Ferivas/RADIOBRIDGE/DOCS/MODBUS/MDBGPS_PROG1.jpg

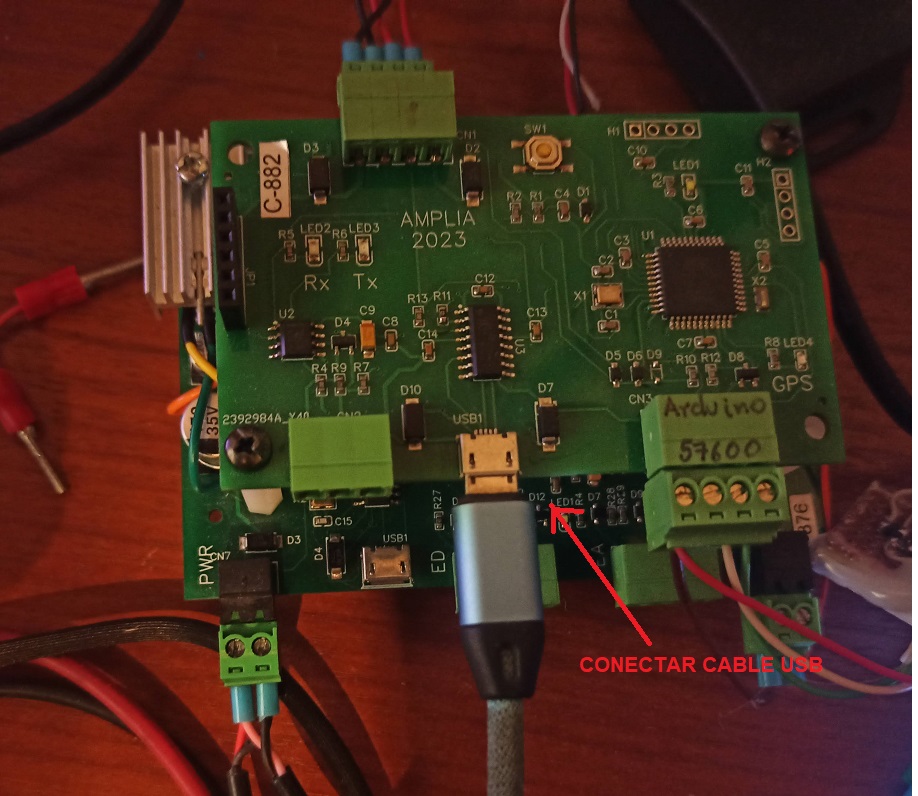
DOCS/MODBUS/MDBGPS_PROG1.jpg
