Ferivas/RADIOBRIDGE/DOCS/MODBUS/MDBGPS_PROG2.jpg

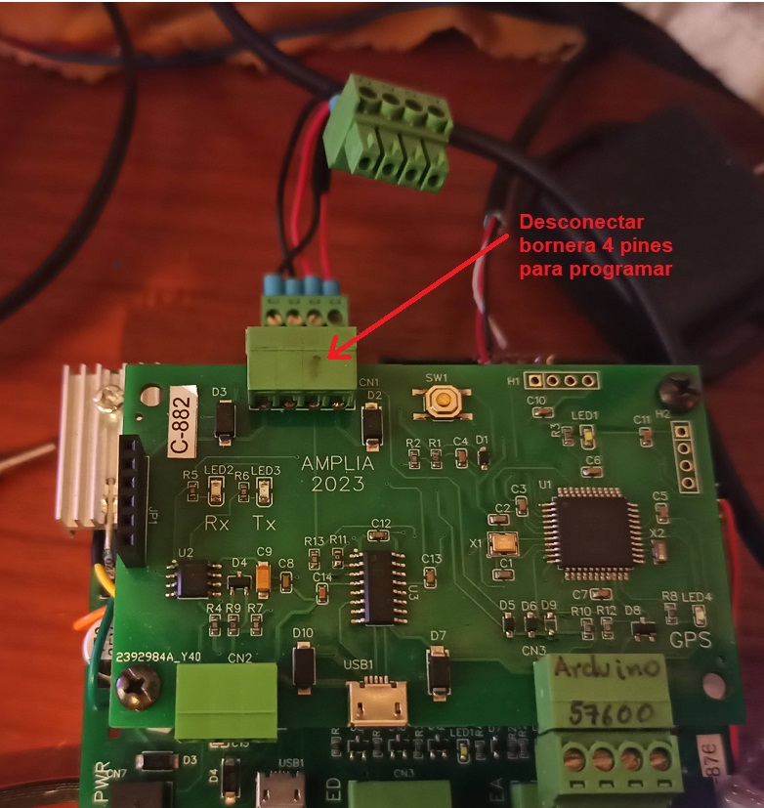
DOCS/MODBUS/MDBGPS_PROG2.jpg
