Ferivas/RADIOBRIDGE/DOCS/ON_OFF_RPI.jpg

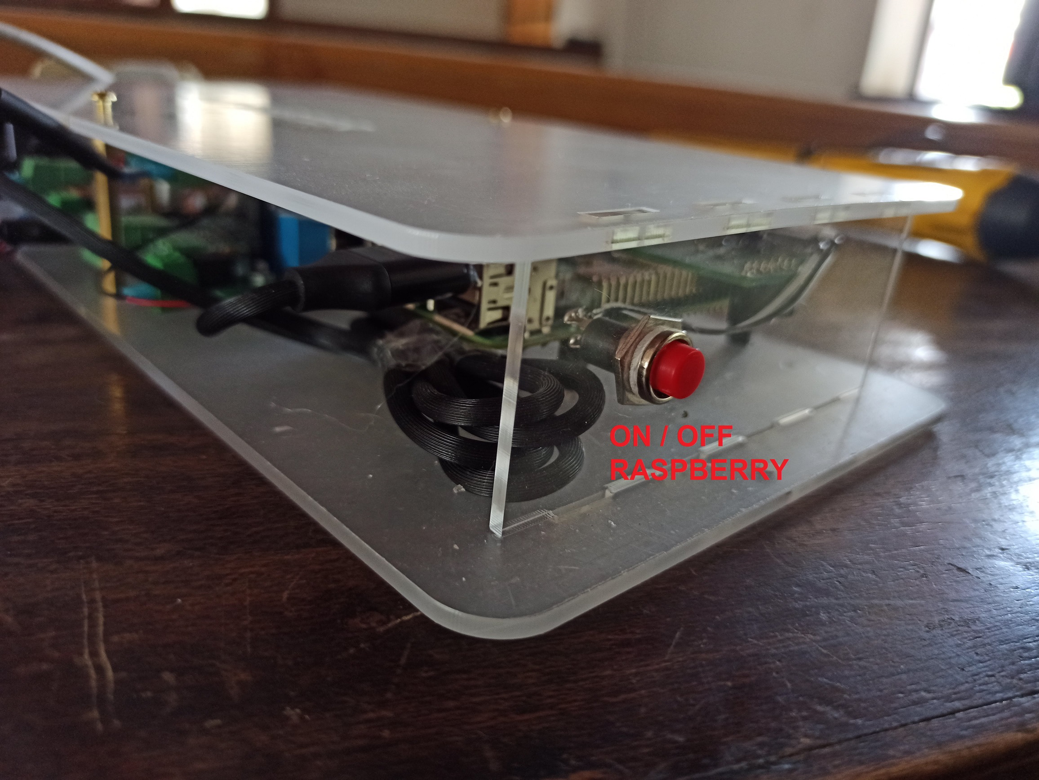
DOCS/ON_OFF_RPI.jpg
