Ferivas/RADIOBRIDGE/DOCS/PWR_RPI.jpg

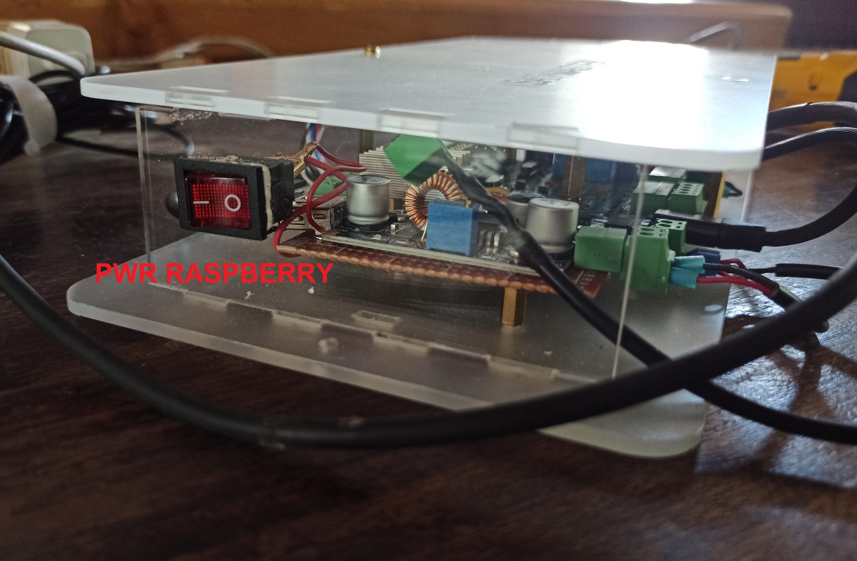
DOCS/PWR_RPI.jpg
