Ferivas/RADIOBRIDGE/DOCS/SAT_MASTER.jpg

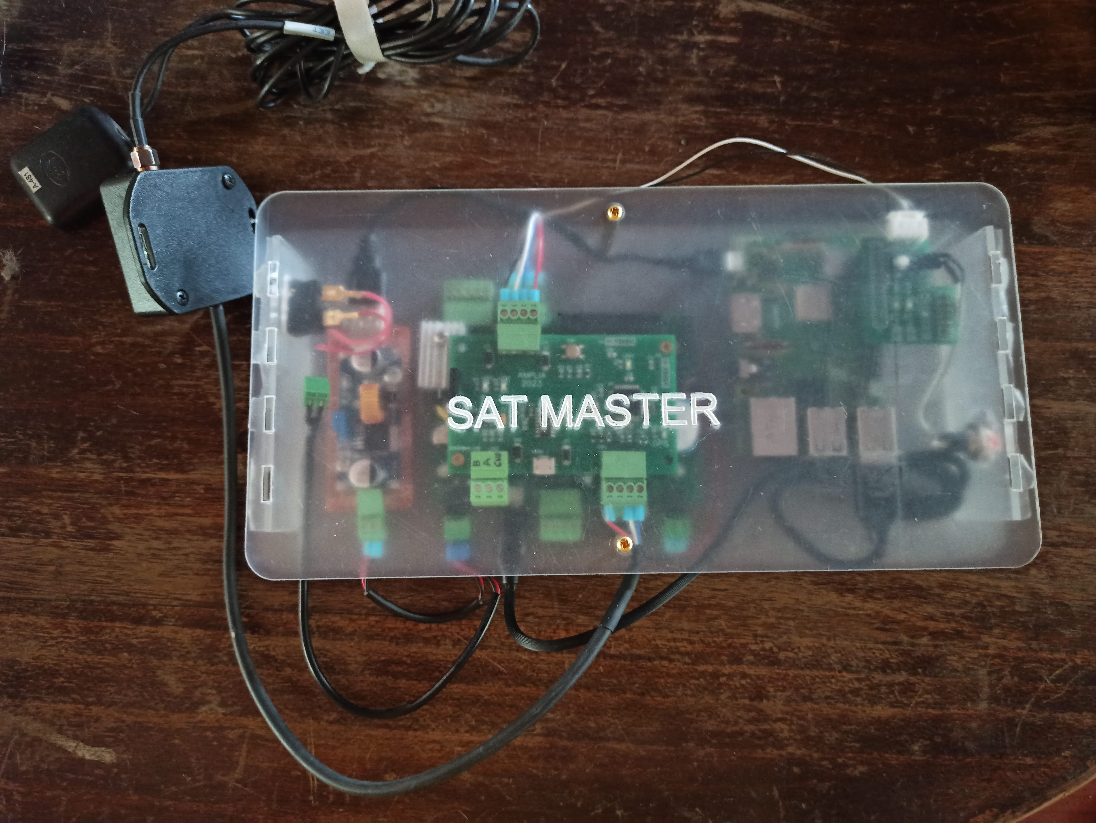
DOCS/SAT_MASTER.jpg
