Ferivas/RADIOBRIDGE/DOCS/SAT_MASTER_CONEXIONES.jpg

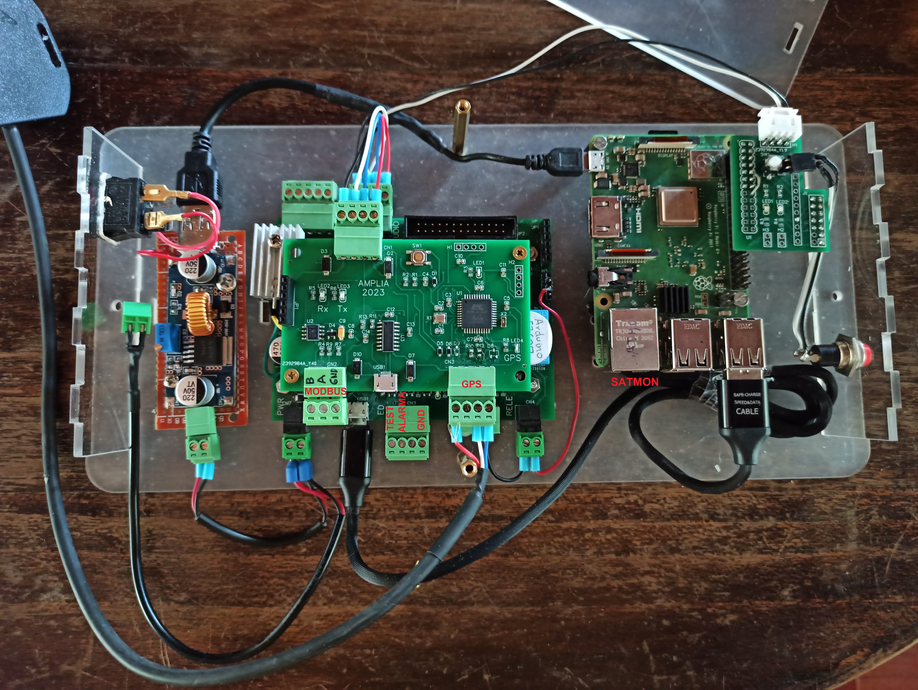
DOCS/SAT_MASTER_CONEXIONES.jpg
