Ferivas/RADIOBRIDGE/SCH/DRVLEDSAT/BOM_DRVLEDSAT_2024-02-23.csv

ID | Name | Designator | Footprint | Quantity | Manufacturer Part | Manufacturer | Supplier | Supplier Part | Price
1 | 22pF | C1,C2 | C0603 | 2 | CL10C220JB8NNNC | SAMSUNG | LCSC | C1653 | 0.006
2 | 100nF | C3,C4,C5,C6,C7,C8,C9,C12,C14,C15,C16 | C0603 | 11 | CC0603KRX7R9BB104 | YAGEO | LCSC | C14663 | 0.002
3 | 10uF | C10 | CAP-SMD_L3.2-W1.6-RD-C7171 | 1 | TAJA106K016RNJ | Kyocera AVX | LCSC | C7171 | 0.095
4 | 220uF | C11,C13 | CAP-SMD_BD6.3-L6.6-W6.6-FD | 2 | RVT220UF16V67RV0015 | KNSCHA(科尼盛) | LCSC | C2887273 | 0.031
5 | THD2528-11SD-GF | CARD1 | TF-SMD_THD2528-11SD-GF | 1 | THD2528-11SD-GF | THD | LCSC | C283232 | 0.208
6 | 1N4148WS T4 | D1,D4 | SOD-323_L1.8-W1.3-LS2.5-RD | 2 | 1N4148WS T4 | CJ | LCSC | C2128 | 0.01
7 | SS14 | D2 | SMA_L4.2-W2.6-LS5.3-RD | 1 | SS14 | MDD | LCSC | C2480 | 0.014
8 | SMAJ5.0A_C2925443 | D3 | SMA_L4.3-W2.6-LS5.0-RD | 1 | SMAJ5.0A | Liown(里阳半导体) | LCSC | C2925443 | 0.029
9 | 220S-1*4P H=8.5MM | H2 | HDR-TH_4P-P2.54-V-F | 1 | 220S-1*4P H=8.5MM Ytype Gold-plated | Ckmtw | LCSC | C124413 | 0.111
10 | whiteLEDSMD | LED1 | LED0805-R-RD | 1 | KT-0805W | KENTO | LCSC | C34499 | 0.017
11 | HDR-IDC-2.54-2X8P | P1,P2 | IDC-TH_16P-P2.54_C3406 | 2 | IDC Box 2.54mm 16P Straight | BOOMELE | LCSC | C3406 | 0.092
12 | SI2301CDS-T1-GE3 | Q1 | SOT-23-3_L3.0-W1.7-P0.95-LS2.9-BR | 1 | SI2301CDS-T1-GE3 | VISHAY | LCSC | C10487 | 0.072
13 | 2n3904S-RTK/PS_C18536 | Q2 | SOT-23-3_L2.9-W1.3-P1.90-LS2.4-TR | 1 | 2N3904S-RTK/PS | KEC | LCSC | C18536 | 0.012
14 | 47K | R1,R3 | R0603 | 2 | 0603WAF4702T5E | UniOhm | LCSC | C25819 | 0.001
15 | 1K | R2 | R0603 | 1 | 0603WAF1001T5E | UniOhm | LCSC | C21190 | 0.001
16 | 10kΩ | R4,R6,R7,R14,R15 | R0603 | 5 | 0603WAF1002T5E | UNI-ROYAL(厚声) | LCSC | C25804 | 0.001
17 | 100kΩ | R5 | R0603 | 1 | 0603WAF1003T5E | UNI-ROYAL(厚声) | LCSC | C25803 | 0.001
18 | 100Ω | R8,R9,R10,R11,R13,R16,R17 | R0603 | 7 | 0603WAF1000T5E | UNI-ROYAL(厚声) | LCSC | C22775 | 0.001
19 | 3.3kΩ | R12 | R0603_NEW | 1 | 0603WAF3301T5E | UniOhm | LCSC | C22978 | 0.001
20 | TS-1187A-B-A-B | SW1 | SW-SMD_4P-L5.1-W5.1-P3.70-LS6.5-TL-2 | 1 | TS-1187A-B-A-B | XKB Connectivity(中国星坤) | LCSC | C318884 | 0.016
21 | ATMEGA1284P-AU | U1 | TQFP-44_L10.0-W10.0-P0.80-LS12.0-BL | 1 | ATMEGA1284P-AU | MICROCHIP(美国微芯) | LCSC | C33575 | 7.038
22 | 24LC256T-I/SN SOP-8 | U2 | SOIC-8_L4.9-W3.9-P1.27-LS6.0-BL | 1 | 24LC256T-I/SN | MICROCHIP(美国微芯) | LCSC | C5458 | 0.804
23 | AMS1117-3.3 | U3 | SOT-223-3_L6.5-W3.4-P2.30-LS7.0-BR | 1 | AMS1117-3.3 | AMS | LCSC | C6186 | 0.141
24 | 32.768kHz | X2 | FC-135R_L3.2-W1.5 | 1 | Q13FC1350000400 | EPSON | LCSC | C32346 | 0.202
25 | 18.432MHz | X1 | CRYSTAL-SMD_4P-L5.0-W3.2-BL-7I12288F20UCG | 1 | TXM18.432M0004503KDCDO00T | YJX(雅晶鑫) | LCSC | C362488 | 0.228
