Ferivas/RADIOBRIDGE/SCH/SATMASTER/BOM_PCB_MDBGPS_2023-09-29.csv

ID | Name | Designator | Footprint | Quantity | Manufacturer Part | Manufacturer | Supplier | Supplier Part | Price
1 | CH340C | U3 | SOP-16_L10.0-W3.9-P1.27-LS6.0-BL | 1 | CH340C | WCH(南京沁恒) | LCSC | C84681 | 0.476
2 | 100nF | C7,C10,C3,C11,C4,C5,C6,C8,C12,C13 | C0603 | 10 | CC0603KRX7R9BB104 | YAGEO | LCSC | C14663 | 0.002
3 | 1N4148WS T4 | D1,D9,D5,D6 | SOD-323_L1.8-W1.3-LS2.5-RD | 4 | 1N4148WS T4 | CJ | LCSC | C2128 | 0.011
4 | SS14 | D2 | SMA_L4.2-W2.6-LS5.3-RD | 1 | SS14 | MDD | LCSC | C2480 | 0.014
5 | PSM712-LF-T7 | D4 | SOT-23-3_L3.0-W1.7-P0.95-LS2.9-BR | 1 | PSM712-LF-T7 | PROTEK | LCSC | C32677 | 0.326
6 | BAV70-C68978 | D8 | SOT-23-3_L3.0-W1.7-P0.95-LS2.9-BR | 1 | BAV70 | CJ | LCSC | C68978 | 0.018
7 | 2685Y-106CNG1SNA01 | JP1 | HDR-TH_6P-P2.54-V-F | 1 | 2685Y-106CNG1SNA01 | 华宇创 | LCSC | C350307 | 0.099
8 | 0805G (Green) | LED2 | LED0805-R-RD | 1 | KT-0805翠绿 | KENTO | LCSC | C2297
9 | 17-21SUYC/TR8 | LED3 | LED0805-R-RD | 1 | KT-0805黄灯 | KENTO | LCSC | C2296
10 | 47K | R1 | R0603 | 1 | 0603WAF4702T5E | UniOhm | LCSC | C25819 | 0.001
11 | 1K | R2,R7,R4,R5,R6,R10,R11,R12,R13 | R0603 | 9 | 0603WAF1001T5E | UniOhm | LCSC | C21190 | 0.001
12 | 470Ω | R3,R8 | R0603 | 2 | 0603WAF4700T5E | UNI-ROYAL(厚声) | LCSC | C23179 | 0.001
13 | TS-1187A-B-A-B | SW1 | SW-SMD_4P-L5.1-W5.1-P3.70-LS6.5-TL-2 | 1 | TS-1187A-B-A-B | XKB Connectivity(中国星坤) | LCSC | C318884 | 0.016
14 | ATMEGA1284P-AU | U1 | TQFP-44_L10.0-W10.0-P0.80-LS12.0-BL | 1 | ATMEGA1284P-AU | MICROCHIP(美国微芯) | LCSC | C33575 | 6.811
15 | SN75176BDR | U2 | SOIC-8_L5.0-W4.0-P1.27-LS6.0-BL | 1 | SN75176BDR | TI(德州仪器) | LCSC | C7063 | 0.283
16 | micro 5PBoard5.9No column plus welding feet | USB1 | MICRO-USB-SMD_5P-P0.65-H-F-C40955 | 1 | micro 5PBoard5.9No column plus welding feet | ValuePro | LCSC | C40955 | 0.066
17 | 16MHz | X1 | OSC-SMD_4P-L3.2-W2.5-BL | 1 | X322516MLB4SI | YXC | LCSC | C13738 | 0.064
18 | 32.768kHz | X2 | FC-135R_L3.2-W1.5 | 1 | Q13FC1350000400 | EPSON | LCSC | C32346 | 0.204
19 | 22pF | C1,C2 | C0603 | 2 | CL10C220JB8NNNC | SAMSUNG | LCSC | C1653 | 0.007
20 | SMAJ5.0A_C2925443 | D10,D3 | SMA_L4.3-W2.6-LS5.0-RD | 2 | SMAJ5.0A | Liown(里阳半导体) | LCSC | C2925443 | 0.039
21 | 0603White light_C2290 | LED1 | LED0603-R-RD_WHITE | 1 | KT-0603白灯 | KENTO | LCSC | C2290
22 | KT-0603R | LED4 | LED0603-RD | 1 | KT-0603R | KENTO | LCSC | C2286
23 | 120Ω | R9 | R0603 | 1 | 0603WAF1200T5E | UNI-ROYAL(厚声) | LCSC | C22787 | 0.001
24 | 10uF | C9 | CAP-SMD_L3.2-W1.6-RD-C7171 | 1 | TAJA106K016RNJ | Kyocera AVX | LCSC | C7171 | 0.1
25 | 10nF | C14 | C0603 | 1 | 0603B103K500NT | FH(风华) | LCSC | C57112 | 0.003
26 | SS14 | D7 | SMA_L4.4-W2.8-LS5.4-RD | 1 | SS14 | MDD | LCSC | C2480 | 0.014
