Ferivas/RADIOBRIDGE/SCH/BOM_RADIOBRIDGE_2022-01-24.csv

ID | Name | Designator | Footprint | Quantity | Manufacturer Part | Manufacturer | Supplier | Supplier Part | Price | JLCPCB Part Class
1 | 100nF | C1,C4,C5,C6,C8,C9,C11,C12,C13,C16,C18,C19,C21,C22,C23,C26,C31,C32 | C0603 | 18 | CC0603KRX7R9BB104 | YAGEO | LCSC | C14663 | 0.003 | Basic Part
2 | 22pF | C2,C3,C14,C15,C33,C34,C35,C36 | C0603 | 8 | CL10C220JB8NNNC | SAMSUNG | LCSC | C1653 | 0.005 | Basic Part
3 | 470uF | C7 | CAP-SMD_BD10.0-L10.3-W10.3-FD | 1 | RVE1V471M1010 | ROQANG | LCSC | C131125 | 0.15 | Extended Part
4 | 220uF | C10 | CAP-SMD_BD6.3-L6.6-W6.6-LS7.2-R-RD | 1 | RVT1A221M0605 | HONOR | LCSC | C3345 | 0.037 | Extended Part
5 | 100uF | C17,C29 | CAP-SMD_BD6.3-L6.6-W6.6-LS7.6-FD-1 | 2 | RVE100UF35V67RV0072 | KNSCHA(科尼盛) | LCSC | C2836437 | 0.057 | Extended Part
6 | 220pF | C20 | C0603 | 1 | CL10B221KB8NNNC | SAMSUNG | LCSC | C1603 | 0.005 | Basic Part
7 | 10uF | C24,C25,C27,C28,C30 | CAP-SMD_L3.2-W1.6-R-RD | 5 | TAJA106K016RNJ | AVX | LCSC | C7171 | 0.113 | Basic Part
8 | JL15EDGRC-35004GT1 | CN2,CN3,CN6 | CONN-TH_4P-P3.50_JL15EDGRC-35004GT1 | 3 | JL15EDGRC-35004GT1 | JILN | LCSC | C400561 | 0.062 | Extended Part
9 | 31342102 | CN4,CN7 | CONN-TH_2P-P3.50_31342102 | 2 | 31342102 | METZ CONNECT | LCSC | C123232 | 0.633 | Extended Part
10 | JL15EDGVC-35006G01 | CN5 | CONN-TH_6P-P3.50_JL15EDGVC-35006G01 | 1 | JL15EDGVC-35006G01 | JILN | LCSC | C400552 | 0.091 | Extended Part
11 | 1N4148WS T4 | D1,D5,D7,D9,D11 | SOD-323_L1.8-W1.3-LS2.5-RD | 5 | 1N4148WS T4 | CJ | LCSC | C2128 | 0.017 | Basic Part
12 | M7_C95872 | D2 | DO-214AC_L4.3-W2.7-LS5.3-RD | 1 | M7 | MDD | LCSC | C95872 | 0.009 | Basic Part
13 | SS34_C8678 | D3 | DO-214AC_L4.3-W2.7-LS5.3-RD | 1 | SS34 | MDD | LCSC | C8678 | 0.048 | Basic Part
14 | SS14 | D4 | SMA_L4.4-W2.8-LS5.4-RD | 1 | SS14 | MDD | LCSC | C2480 | 0.019 | Basic Part
15 | BAV99,215 | D8,D10,D12 | SOT-23-3_L2.9-W1.6-P1.90-LS2.8-BR | 3 | BAV99,215 | Nexperia | LCSC | C2500 | 0.026 | Basic Part
16 | 220S-1*4P H=8.5MM | H2 | HDR-TH_4P-P2.54-V-F | 1 | 220S-1*4P H=8.5MM Ytype Gold-plated | Ckmtw | LCSC | C124413 | 0.117 | Extended Part
17 | 2685Y-106CNG1SNA01 | JP1 | HDR-TH_6P-P2.54-V-F | 1 | 2685Y-106CNG1SNA01 | 华宇创 | LCSC | C350307 | 0.074 | Extended Part
18 | MTB110-26S | JP2 | IDC-TH_MTB110-26S | 1 | MTB110-26S | MINTRON | LCSC | C358747 | 0.177 | Extended Part
19 | 10uH | L1 | L0603 | 1 | SDFL1608S100KTF | Sunlord | LCSC | C1035 | 0.011 | Basic Part
20 | 0603White light_C2290 | LED1 | LED0603-R-RD_WHITE | 1 | 0603White light | KENTO | LCSC | C2290 |  | Basic Part
21 | 17-21SUYC/TR8 | LED2 | LED0805-RD | 1 | 17-21SUYC/TR8 | KENTO | LCSC | C2296 |  | Basic Part
22 | KT-0603R | LED3 | LED0603-R-RD | 1 | KT-0603R | KENTO | LCSC | C2286 |  | Basic Part
23 | SI2301CDS-T1-GE3 | Q1 | SOT-23-3_L3.0-W1.7-P0.95-LS2.9-BR | 1 | SI2301CDS-T1-GE3 | VISHAY | LCSC | C10487 | 0.083 | Basic Part
24 | MMBFJ177LT1G | Q2 | SOT-23-3_L3.0-W1.7-P0.95-LS2.9-BR | 1 | MMBFJ177LT1G | ON Semicon | LCSC | C106763 | 1.374 | Extended Part
25 | 2N5460 | Q3 | TO92-INLINE | 1
26 | 2n3904S-RTK | Q4,Q5 | SOT-23-3_L2.9-W1.3-P1.90-LS2.4-TR | 2 | 2n3904S-RTK/PS | KEC | LCSC | C18536 | 0.019 | Extended Part
27 | 47K | R1 | R0603 | 1 | 0603WAF4702T5E | UniOhm | LCSC | C25819 | 0.001 | Basic Part
28 | 1K | R2,R9,R10,R17,R21,R36 | R0603 | 6 | 0603WAF1001T5E | UniOhm | LCSC | C21190 | 0.001 | Basic Part
29 | 10K | R3,R11,R15,R24,R26 | R0603 | 5 | 0603WAF1002T5E | UniOhm | LCSC | C25804 | 0.001 | Basic Part
30 | 470 | R4,R5,R6,R27,R30,R35 | R0603 | 6 | 0603WAF4700T5E | UniOhm | LCSC | C23179 | 0.001 | Basic Part
31 | 0 | R7 | R0603 | 1 | 0603WAF0000T5E | UniOhm | LCSC | C21189 | 0.001 | Basic Part
32 | 51K | R8 | R0603 | 1 | 0603WAF5102T5E | UniOhm | LCSC | C23196 | 0.001 | Basic Part
33 | 100K | R12,R13,R18,R20,R29,R32,R34 | R0603 | 7 | 0603WAF1003T5E | UniOhm | LCSC | C25803 | 0.001 | Basic Part
34 | 300K | R14 | R0603 | 1 | 0603WAF3003T5E | UniOhm | LCSC | C23024 | 0.001 | Basic Part
35 | 220K | R16,R25 | R0603 | 2 | 0603WAF2203T5E | UniOhm | LCSC | C22961 | 0.001 | Basic Part
36 | 120K | R19 | R0603 | 1 | 0603WAF1203T5E | UniOhm | LCSC | C25808 | 0.001 | Basic Part
37 | 3.3K | R22 | R0603_NEW | 1 | 0603WAF3301T5E | UniOhm | LCSC | C22978 | 0.001 | Basic Part
38 | 56K | R23 | R0603 | 1 | 0603WAF5602T5E | UniOhm | LCSC | C23206 | 0.001 | Basic Part
39 | 1M | R28,R31,R33 | R0603 | 3 | 0603WAF1004T5E | UniOhm | LCSC | C22935 | 0.001 | Basic Part
40 | SRD-05VDC-SL-C | RLY1 | RELAY-TH_SRD-XXVDC-XL-C | 1 | SRD-05VDC-SL-C | SONGLE | LCSC | C35449 | 0.544 | Extended Part
41 | K2-1839SP-C4SW-02 | SW1 | SW-SMD_4P-L6.2-W6.2-P4.50-LS8.5 | 1 | K2-1839SP-C4SW-02 | Korean Hroparts Elec | LCSC | C164133 | 0.206 | Extended Part
42 | ATMEGA128A-AU | U1 | LQFP-64_L14.0-W14.0-P0.80-LS16.0-BL | 1 | ATMEGA128A-AU | MICROCHIP | LCSC | C6510 | 7.261 | Extended Part
43 | CJ7805 3% | U3 | TO-252-2_L6.6-W6.1-P4.58-LS10.1-BR-CW | 1 | CJ7805 3% | CJ | LCSC | C21706 | 0.34 | Extended Part
44 | CH340G | U4 | SOIC-16_150MIL | 1 | CH340G | WCH | LCSC | C14267 | 0.73
45 | 78L12G-AB3-R | U5 | SOT-89-3_L4.5-W2.5-P1.50-LS4.2-BR | 1 | 78L12G-AB3-R | UTC | LCSC | C75501 | 0.144 | Basic Part
46 | HT9170B | U6 | DIP18-2.54-22.8X7.62MM | 1 | HT9170B
47 | HT9200B | U8 | SOIC-14_L8.7-W3.9-P1.27-LS6.0-BL | 1 | HT9200B | HOLTEK | LCSC | C16087 | 1.097 | Extended Part
48 | micro 5PBoard5.9No column plus welding feet | USB1 | MICRO-USB-SMD_5P-P0.65-H-F-C40955 | 1 | micro 5PBoard5.9No column plus welding feet | ValuePro | LCSC | C40955 | 0.069
49 | 16MHz | X1 | OSC-SMD_4P-L3.2-W2.5-BL | 1 | X322516MLB4SI | YXC | LCSC | C13738 | 0.087 | Basic Part
50 | 12MHz | X2 | CRYSTAL-SMD_4P-L3.2-W2.5-BL | 1 | 7M1204LCSC-EIE4S | TXC | LCSC | C93114 |  | Extended Part
51 | 3.579545MHz | X3,X4 | HC-49S_L11.4-W4.8 | 2 | TXM3.579545M0002491HDDEO00T | Zhejiang Abel Elec | LCSC | C370890 | 0.12
52 | LM324 | U7 | SOIC-14_L8.7-W3.9-P1.27-LS6.0-BL | 1 | LM324 | PUOLOP | LCSC | C351427 | 0.156 | Extended Part
