Ferivas/RADIOBRIDGE/SCH/DRVAUDIO/BOM_DRVAUDIOSAT_2024-05-31.csv

ID | Name | Designator | Footprint | Quantity | Manufacturer Part | Manufacturer | Supplier | Supplier Part | Price
1 | 22pF | C1,C2 | C0603 | 2 | CL10C220JB8NNNC | SAMSUNG | LCSC | C1653 | 0.006
2 | 100nF | C3,C4,C6,C7,C8,C9,C12,C13,C15,C17,C20,C25,C35,C36,C37,C38 | C0603 | 16 | CC0603KRX7R9BB104 | YAGEO | LCSC | C14663 | 0.002
3 | 100uF | C5 | C1206 | 1 | CL31A107MQHNNNE | SAMSUNG(三星) | LCSC | C15008 | 0.065
4 | 1uF | C19,C22,C23,C24,C28,C29,C30,C32,C33,C34 | C1206 | 10 | CL31B105KBHNNNE | SAMSUNG(三星) | LCSC | C1848 | 0.017
5 | 10nF | C10 | C0603 | 1 | 0603B103K500NT | FH(风华) | LCSC | C57112 | 0.002
6 | 150pF | C27,C31 | C0603 | 2 | 0603B151K500NT | FH(风华) | LCSC | C1594 | 0.003
7 | 100uF | C11,C14,C16,C18 | CAP-SMD_BD8.0-L8.3-W8.3-FD | 4 | UWT1H101MNL1GS | Nichicon(尼吉康) | LCSC | C445063 | 0.168
8 | 10uF | C21,C26 | CAP-SMD_L3.2-W1.6-RD-C7171 | 2 | TAJA106K016RNJ | Kyocera AVX | LCSC | C7171 | 0.096
9 | 1N4148WS T4 | D1,D2,D4 | SOD-323_L1.8-W1.3-LS2.5-RD | 3 | 1N4148WS T4 | CJ | LCSC | C2128 | 0.009
10 | SS14 | D3,D8 | SMA_L4.4-W2.8-LS5.4-RD | 2 | SS14 | MDD | LCSC | C2480 | 0.015
11 | SMAJ5.0A_C2925443 | D5,D9 | SMA_L4.3-W2.6-LS5.0-RD | 2 | SMAJ5.0A | Liown(里阳半导体) | LCSC | C2925443 | 0.03
12 | SS210 | D6 | SMA_L4.3-W2.6-LS5.2-RD | 1 | SS210 | MDD | LCSC | C14996 | 0.024
13 | SMBJ28CA_C19077583 | D7 | SMB_L4.6-W3.6-LS5.4-RD | 1 | SMBJ28CA | 宏迦橙 | LCSC | C19077583 | 0.041
14 | 2685Y-106CNG1SNA01 | JP1 | HDR-TH_6P-P2.54-V-F | 1 | 2685Y-106CNG1SNA01 | 华宇创 | LCSC | C350307 | 0.093
15 | 19-213/Y2C-CQ2R2L/3T(CY) | LED1 | LED0603-RD-YELLOW | 1 | 19-213/Y2C-CQ2R2L/3T(CY) | EVERLIGHT(亿光) | LCSC | C72038 | 0.021
16 | AO3401A | Q1 | SOT-23_L2.9-W1.3-P1.90-LS2.4-BR | 1 | AO3401A | AOS | LCSC | C15127 | 0.055
17 | 47K | R1,R5 | R0603 | 2 | 0603WAF4702T5E | UniOhm | LCSC | C25819 | 0.001
18 | 1K | R2,R7,R8,R9,R30,R31 | R0603 | 6 | 0603WAF1001T5E | UniOhm | LCSC | C21190 | 0.001
19 | 10kΩ | R3,R4,R25,R29 | R0603 | 4 | 0603WAF1002T5E | UNI-ROYAL(厚声) | LCSC | C25804 | 0.001
20 | 120Ω | R6,R14 | R0603 | 2 | 0603WAF1200T5E | UNI-ROYAL(厚声) | LCSC | C22787 | 0.001
21 | 47Ω | R10,R11 | R0603 | 2 | 0603WAF470JT5E | UNI-ROYAL(厚声) | LCSC | C23182 | 0.001
22 | 560Ω | R12 | R0603 | 1 | 0603WAF5600T5E | UNI-ROYAL(厚声) | LCSC | C23204 | 0.001
23 | 390Ω | R13,R15 | R0603 | 2 | 0603WAF3900T5E | UNI-ROYAL(厚声) | LCSC | C23151 | 0.001
24 | 100kΩ | R16,R17,R18,R19,R20,R21,R22,R23,R26,R28 | R0603 | 10 | 0603WAF1003T5E | UNI-ROYAL(厚声) | LCSC | C25803 | 0.001
25 | 150kΩ | R24,R27 | R0603 | 2 | 0603WAF1503T5E | UNI-ROYAL(厚声) | LCSC | C22807 | 0.001
26 | TS-1187A-B-A-B | SW1 | SW-SMD_4P-L5.1-W5.1-P3.70-LS6.5-TL-2 | 1 | TS-1187A-B-A-B | XKB Connectivity(中国星坤) | LCSC | C318884 | 0.017
27 | ATMEGA328PB-AU | U1 | TQFP-32_L7.0-W7.0-P0.80-LS9.0-BL | 1 | ATMEGA328PB-AU | MICROCHIP(美国微芯) | LCSC | C132230 | 1.958
28 | AMS1117-3.3 | U3 | SOT-223-3_L6.5-W3.4-P2.30-LS7.0-BR | 1 | AMS1117-3.3 | AMS | LCSC | C6186 | 0.135
29 | CH340C | U5 | SOP-16_L10.0-W3.9-P1.27-LS6.0-BL | 1 | CH340C | WCH(南京沁恒) | LCSC | C84681 | 0.486
30 | LM317MQDCYR | U6,U7,U8 | SOT-223-4_L6.5-W3.5-P2.30-LS7.0-BR | 3 | LM317MQDCYR | TI(德州仪器) | LCSC | C496125 | 0.494
31 | CD4066BM/TR | U9 | SOP-14_L8.6-W3.9-P1.27-LS6.0-BL | 1 | CD4066BM/TR | HGSEMI(华冠) | LCSC | C512770 | 0.101
32 | micro 5PBoard5.9No column plus welding feet | USB1 | MICRO-USB-SMD_5P-P0.65-H-F-C40955 | 1 | micro 5PBoard5.9No column plus welding feet | ValuePro | LCSC | C40955 | 0.059
33 | 16MHz | X1 | OSC-SMD_4P-L3.2-W2.5-BL | 1 | X322516MLB4SI | YXC | LCSC | C13738 | 0.055
34 | LM324DT | U10 | SOIC-14_L8.7-W3.9-P1.27-LS6.0-BL | 1 | LM324DT | ST(意法半导体) | LCSC | C71035 | 0.114
35 | 31342102 | CN3,CN4 | CONN-TH_2P-P3.50_31342102 | 2 | 31342102 | METZ CONNECT | LCSC | C123232 | 0.596
