Ferivas/RADIOBRIDGE/DOCS/MODBUS/HoldingregisterPruebas.jpg

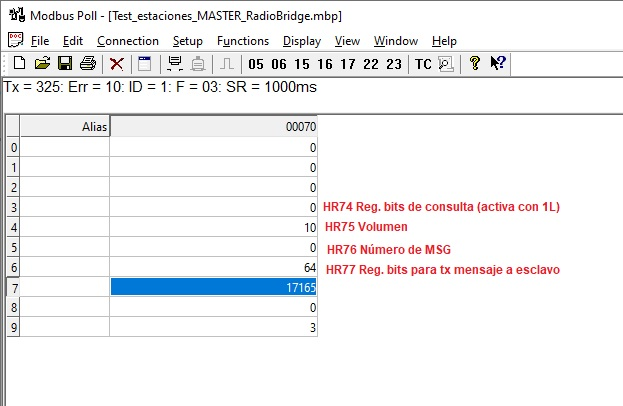
DOCS/MODBUS/HoldingregisterPruebas.jpg
