Ferivas/RADIOBRIDGE/DOCS/MODBUSPOLL/Escribe_Registro_TEST.jpg

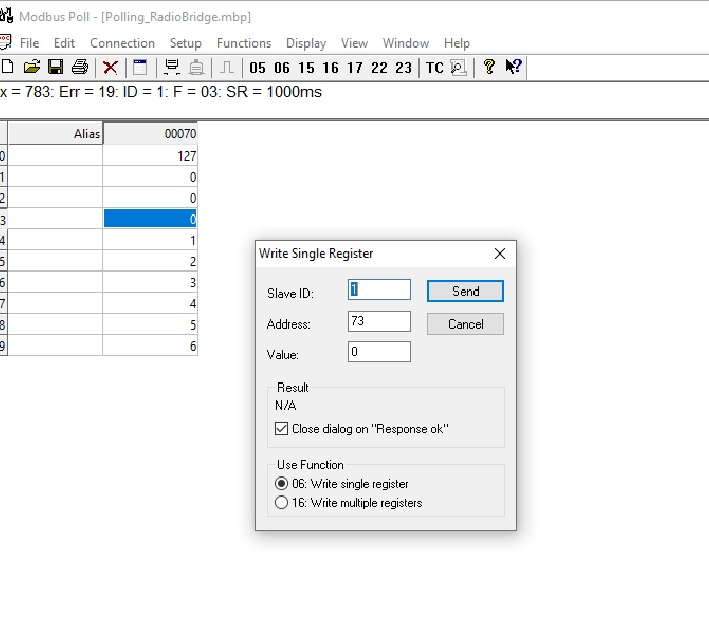
DOCS/MODBUSPOLL/Escribe_Registro_TEST.jpg
