Ferivas/RADIOBRIDGE/DOCS/MODBUSPOLL/Prueba_TEST_HDR.jpg

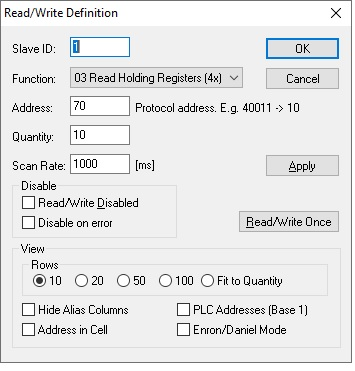
DOCS/MODBUSPOLL/Prueba_TEST_HDR.jpg
