Ferivas/RADIOBRIDGE/DOCS/MODBUS PUNTEROS HOLDING REGISTERS.pdf

## HOLDING REGISTER

En dos registros de 16 bits se almacenan consecutivamente CNTR tx, VBAT, VPS

Numestacion | PTR_ CTRTX | PTR_VBAT | PTR_VPS
1 | 1 | 3 | 5
2 | 7 | 9 | 11
3 | 13 | 15 | 17
4 | 19 | 21 | 23
5 | 25 | 27 | 29
6 | 31 | 33 | 35
7 | 37 | 39 | 41
8 | 43 | 45 | 47
9 | 49 | 51 | 53
10 | 55 | 57 | 59
11 | 61 | 63 | 65
12 | 67 | 69 | 71

74 En el Holding Register 74 se almacena la palabra de 16 bits que activa las consultas en estado Normal y Test de las estaciones

B15B14B13B12B11B10B9B8B7B6B5B4B3B2B1B0 En el Holding Register 74 se escriben los bits para hacer una consulta vía Modbus de los esclavos

B0 (bit 0 de HR20) corresponde a la estación 1

B1 (bit 1 de HR20) corresponde a la estación 2

B8 (bit 8 de HR20) corresponde a la estación 9

Un cambio de bit a 1L habilita una consulta en modo Test

Un cambio a bit0 hace una consulta en modo normal

## INPUT REGISTER

DIRECCION

1 MSW CNTRTX

2 LSW CNTRTX

3 N4N3N2N1 | N1, N2, N3 y N4 nibbles de 4 bits que almacenan estados de estacion 1, 2,3,4
4 N8N7N6N5 | Estados estacion 5, 6, 7 y 8

5 N12N11N10N9 Estado estacion 9,10,11,12

6 S2S1 | STAinout de estacion 1,2 | En cada registro de 16 bits se almacenan los estados de los registros ADC I2C del Driver Audio de dos estaciones
7 S4S3 | STAinout de estacion 3,4 | En el registro 6 se almacena los estados de las estaciones 1 y 2, en el registro 7 los estados de las estaciones 3 y 4, y así sucesivamente
8 S6S5 | STAinout de estacion 5,6 | Por ejemplo, el IPR 8(Input Register 8) almacena los estados de la estación 5 en el LSB (byte menos significativo) y los estados de la estación 6 en el MSB (byte MSB)
9 S8S7 | STAinout de estacion 7,8 | El registro de 16 bits almacena los estados de los registros ADC del DRIVERAUDIO
10 S10S9 | STAinout de estacion 9,10 | Un 0 en un bit implica que el valor ADC leído es menor que un valor de referencia que se configura en el RadioBridge,
11 S12S11 | STAinout de estacion 11,12 | mientras que un 1 en un bit implica que el valor ADC leído es mayot que el valor de referencia configurado

12 ULTIMA CONSULTA DE ESTACION

En los bytes que almacenan el estado de los registros ADC del DRIVERAUDIO, los estados se codifican en las siguientes posiciones:

B4 | Estado ADC0 | (Voltaje de entrada del DRVAUDIO)
B5 | Estado ADC1 | (Sensor de Temperatura)
B6 | Estado ADC2 | (Corriente Salida B)
B7 | Estado ADC3 | (Corriente Salida A)
21 B15B14B13B12B11B10B9B8B7B6B5B4B3B2B1B0 | En el registro de entrada 21 se escriben los bits para indicar un Timeout en la rx de datos de los esclavos (3600 segundos por defecto)

Un bit 0 indica estado normal y un bit 1 indica que se ha producido un timeout

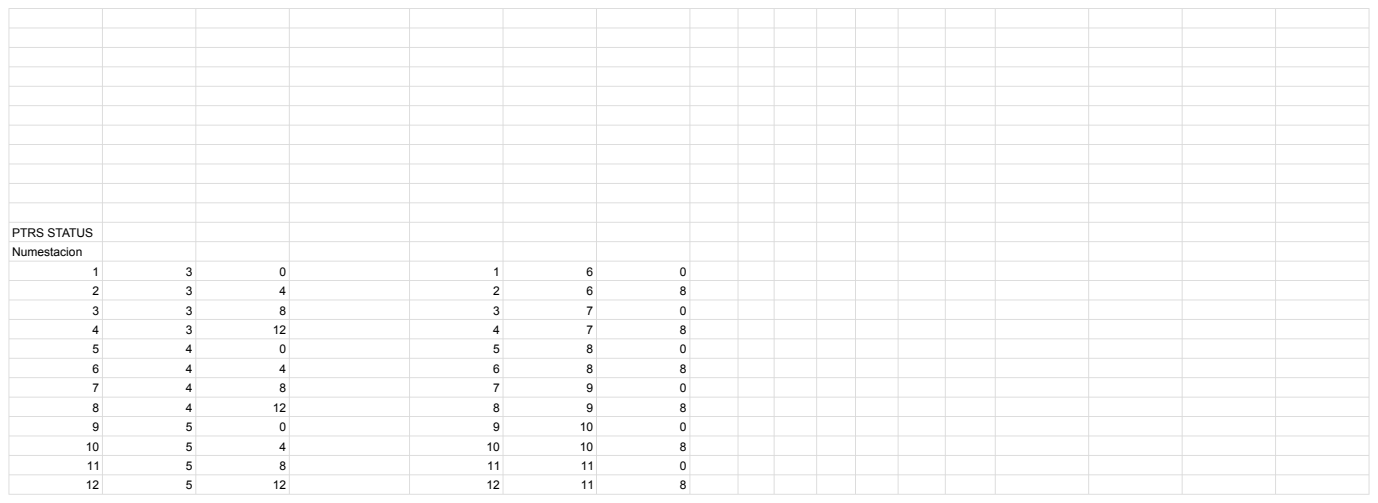
[picture p19: page 2]
PTRS STATUS; Numestacion
