Ferivas/RADIOBRIDGE/SCH/JLCPCB/PDF_RADIOBRIDGE NUEVO_2026-04-17/SCH_RADIOBRIDGE_2026-04-17.pdf

## DRIVER LED

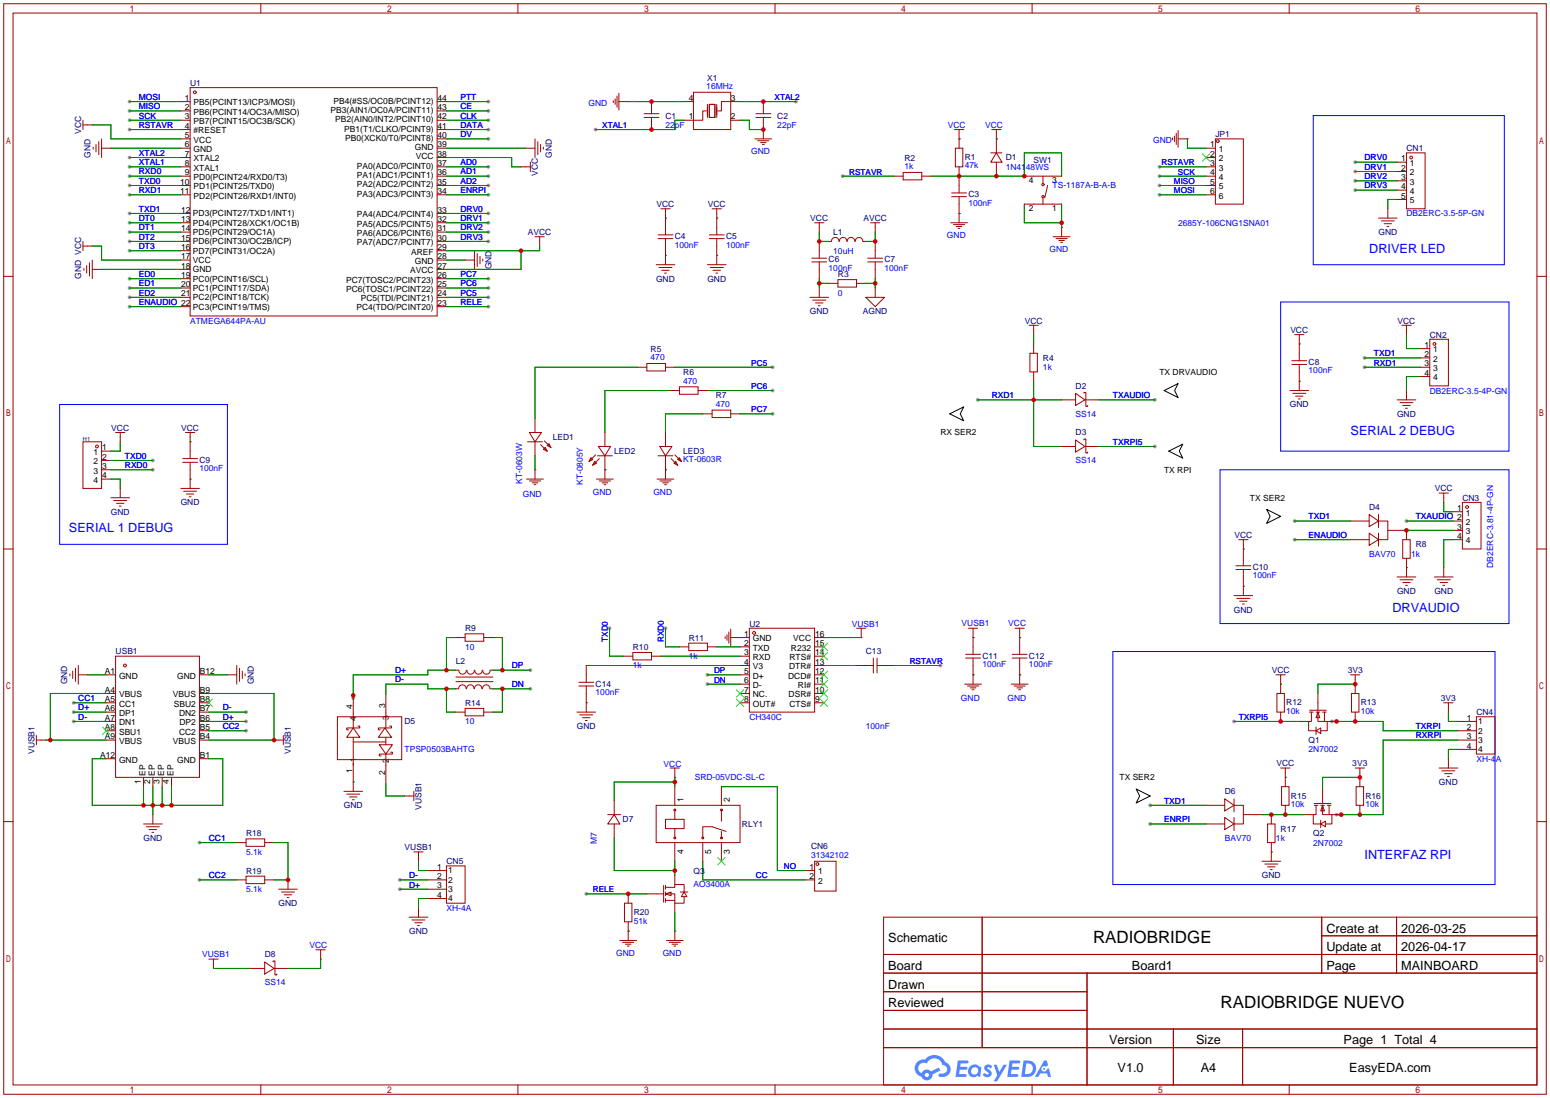
[picture p20: page 1]

DSR# 10 RI# 11 DCD# 12 DTR# 13 RTS# 14 R232 15 VCC 16

Schematic | RADIOBRIDGE | Create at | 2026-03-25

Update at | 2026-04-17

Board | Board1 | Page | MAINBOARD
Drawn | | RADIOBRIDGE NUEVO
Reviewed

Version | Size | Page 1 Total 4
V1.0 | A4 | EasyEDA.com

# TOE 10 Q1 11 Q2 12 Q3 13 Q4 14 StD 15 ESt 16 St/GT 17 VDD 18

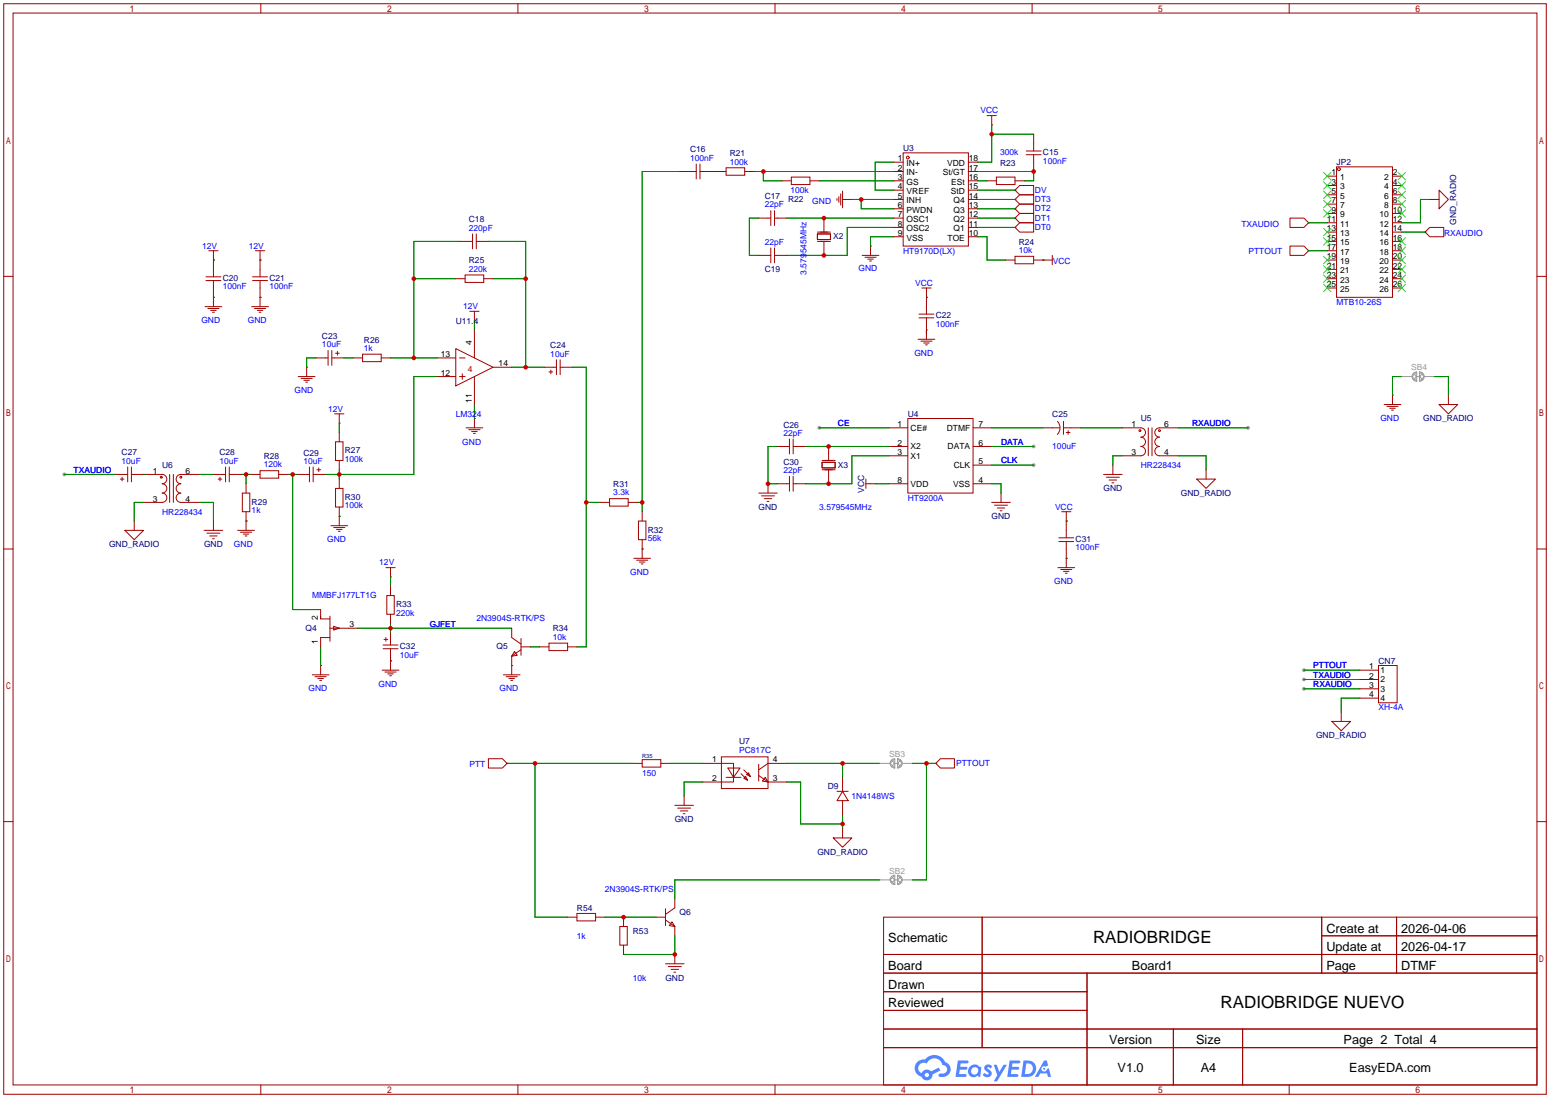
[picture p21: page 2]

Schematic | RADIOBRIDGE | Create at | 2026-04-06

Update at | 2026-04-17

Board | Board1 | Page | DTMF
Drawn | | RADIOBRIDGE NUEVO
Reviewed

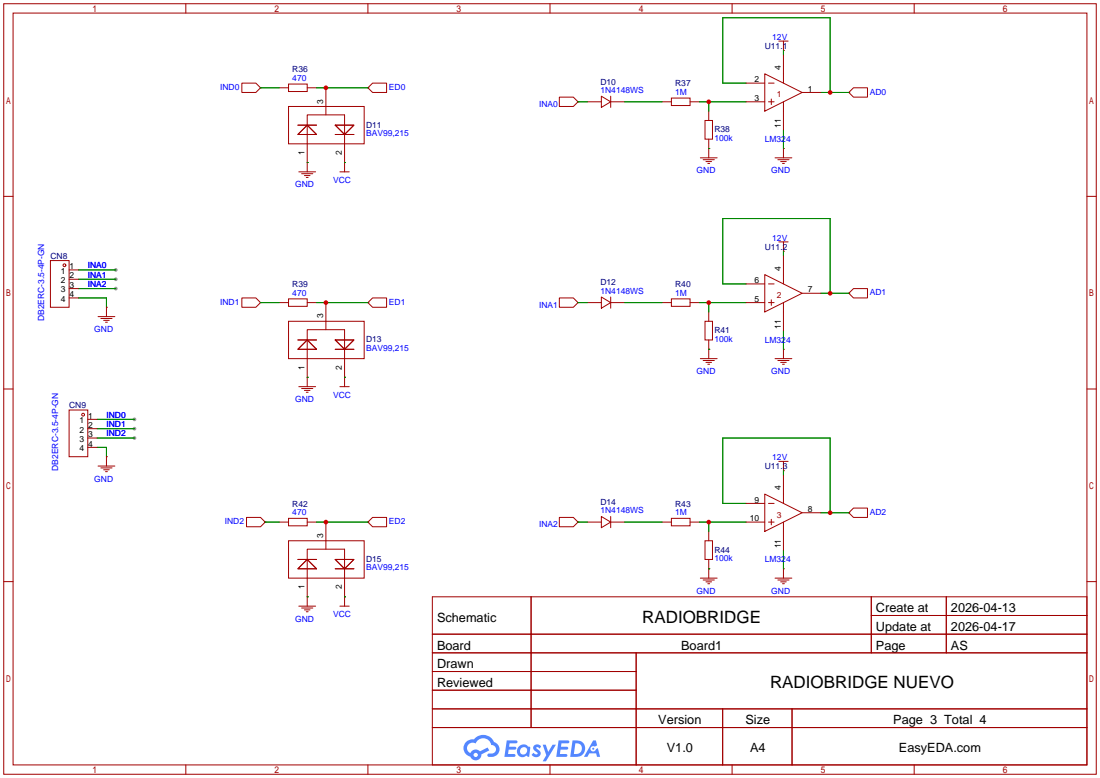
[picture p22: page 3]

Schematic | RADIOBRIDGE | Create at | 2026-04-13

Update at | 2026-04-17

Board | Board1 | Page | AS
Drawn | | RADIOBRIDGE NUEVO
Reviewed

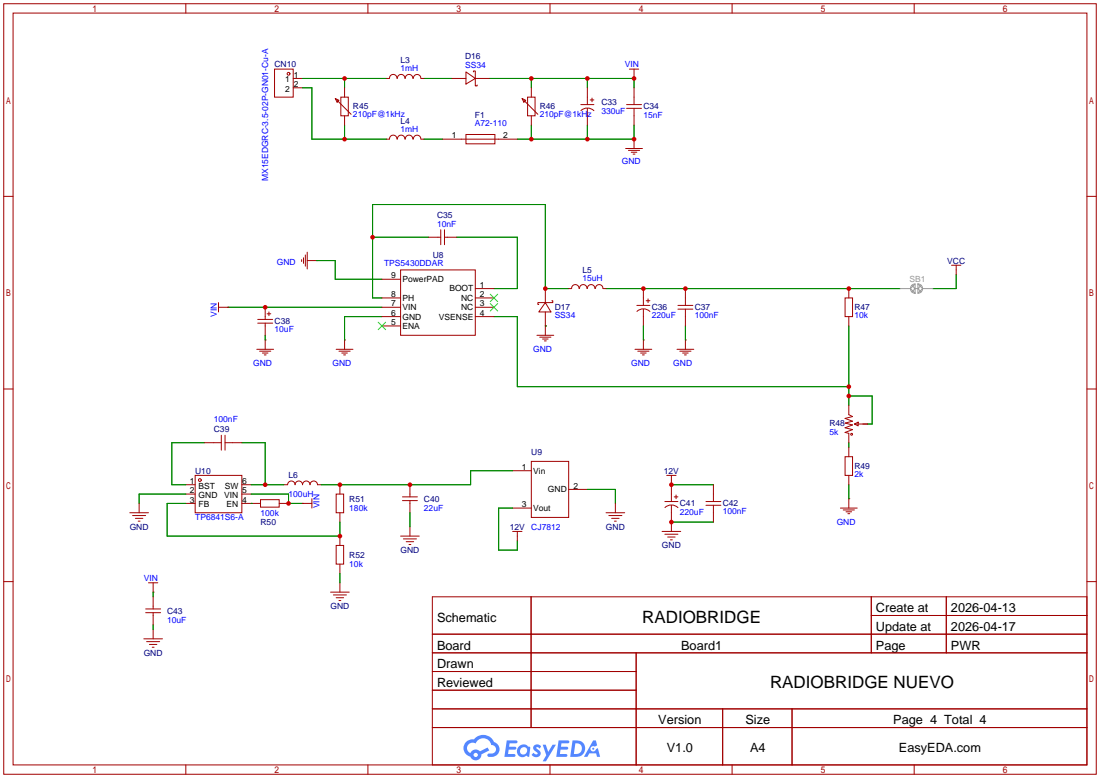
[picture p23: page 4]

Schematic | RADIOBRIDGE | Create at | 2026-04-13

Update at | 2026-04-17

Board | Board1 | Page | PWR
Drawn | | RADIOBRIDGE NUEVO
Reviewed
