Ferivas/RADIOBRIDGE/SCH/DRVAUDIO/Schematic_DRVAUDIOSAT_2026-05-25.pdf

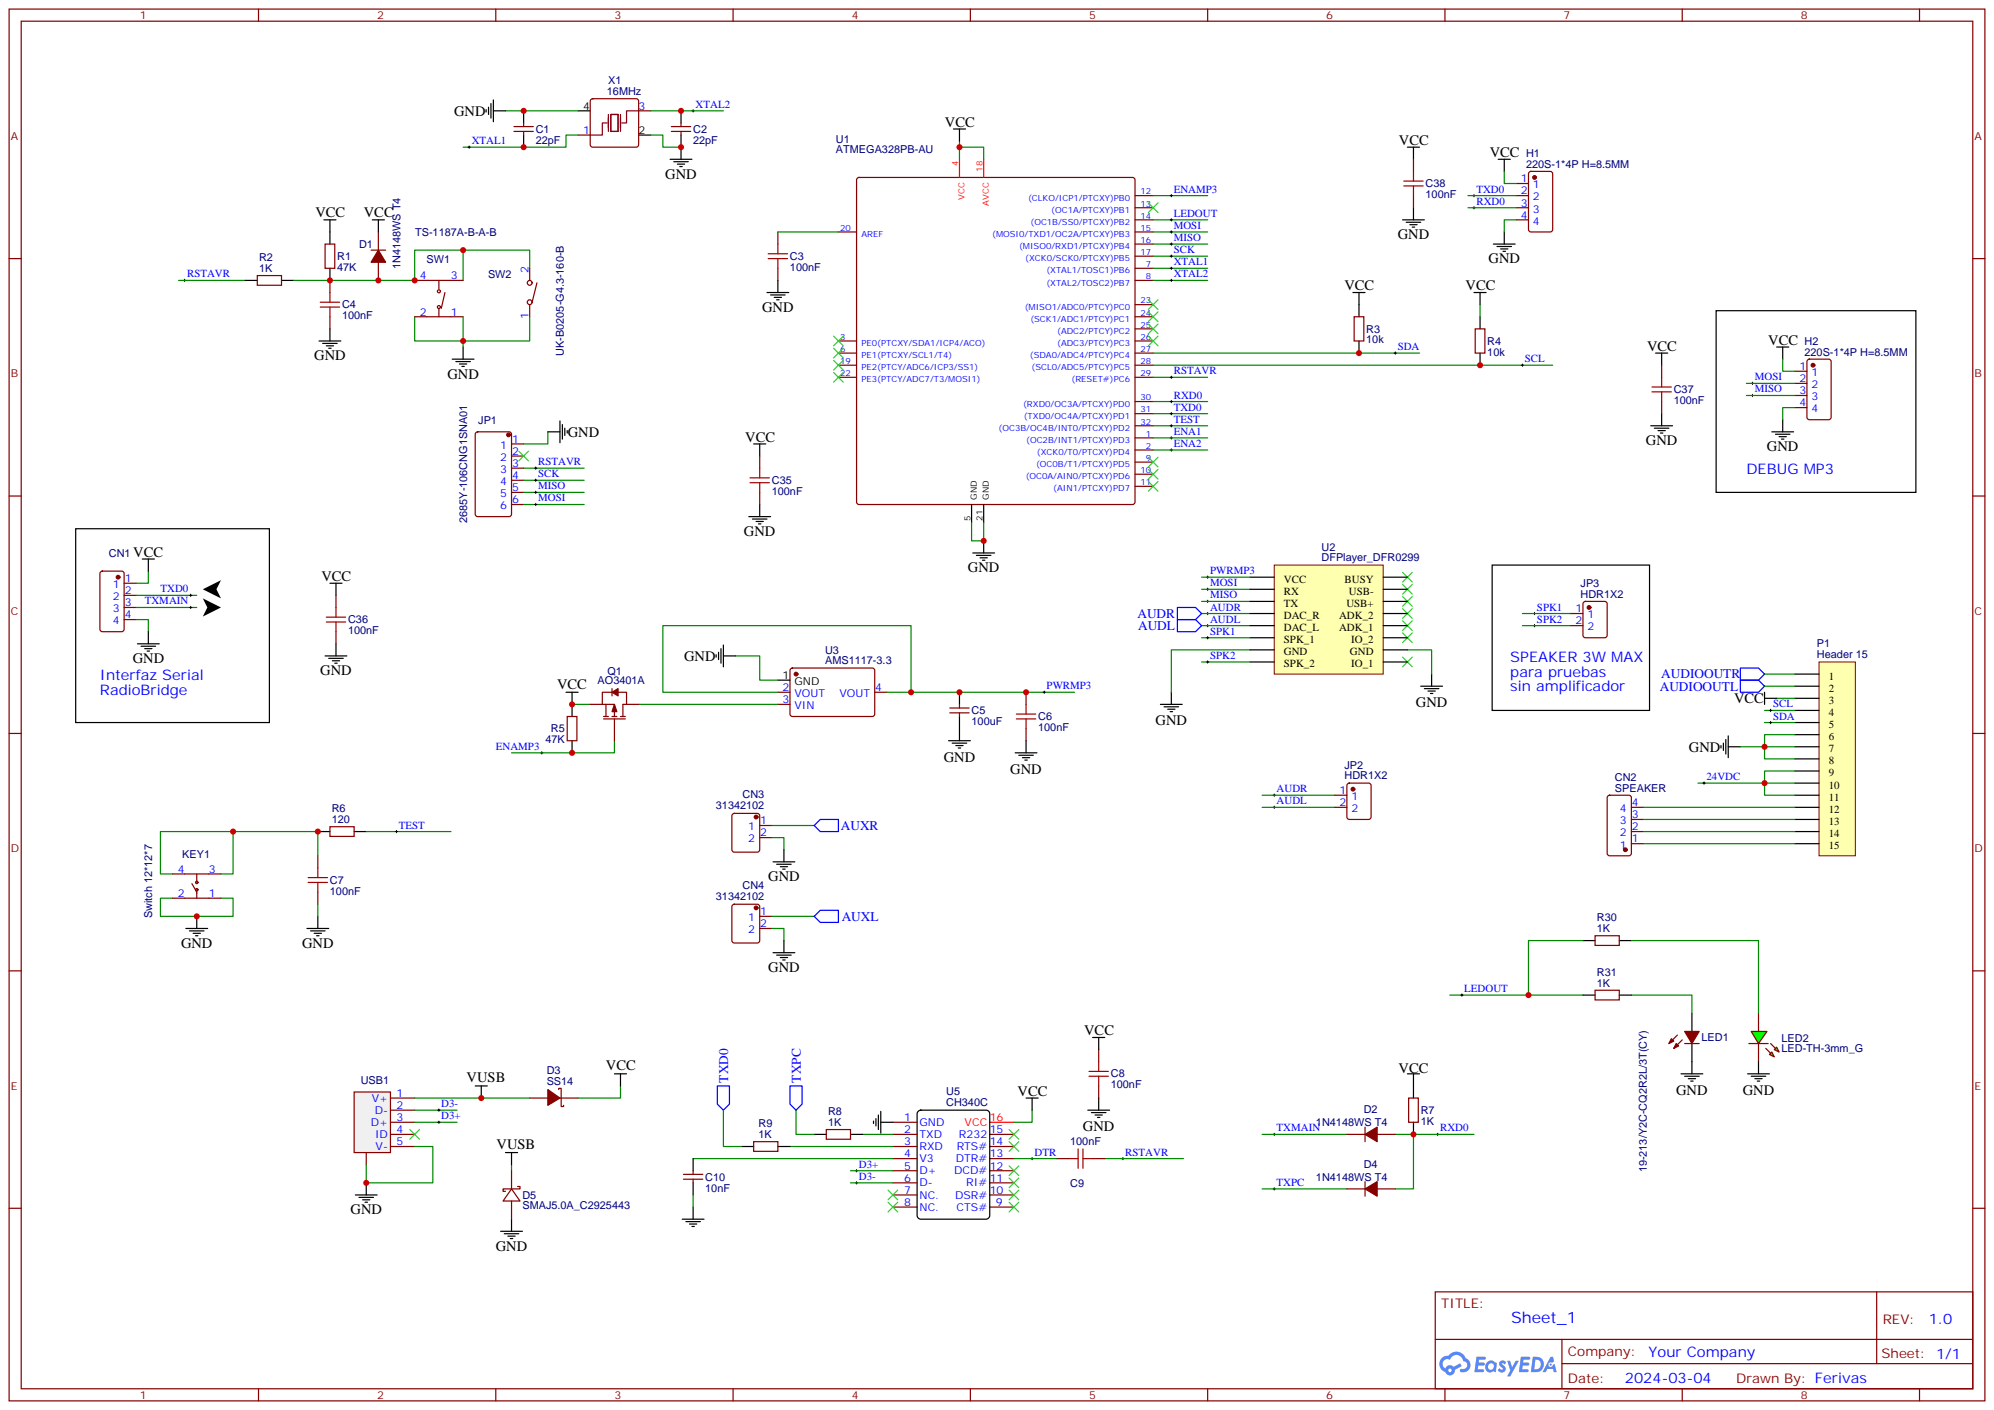
[picture p24: page 1]

## ADJ

## ADJ

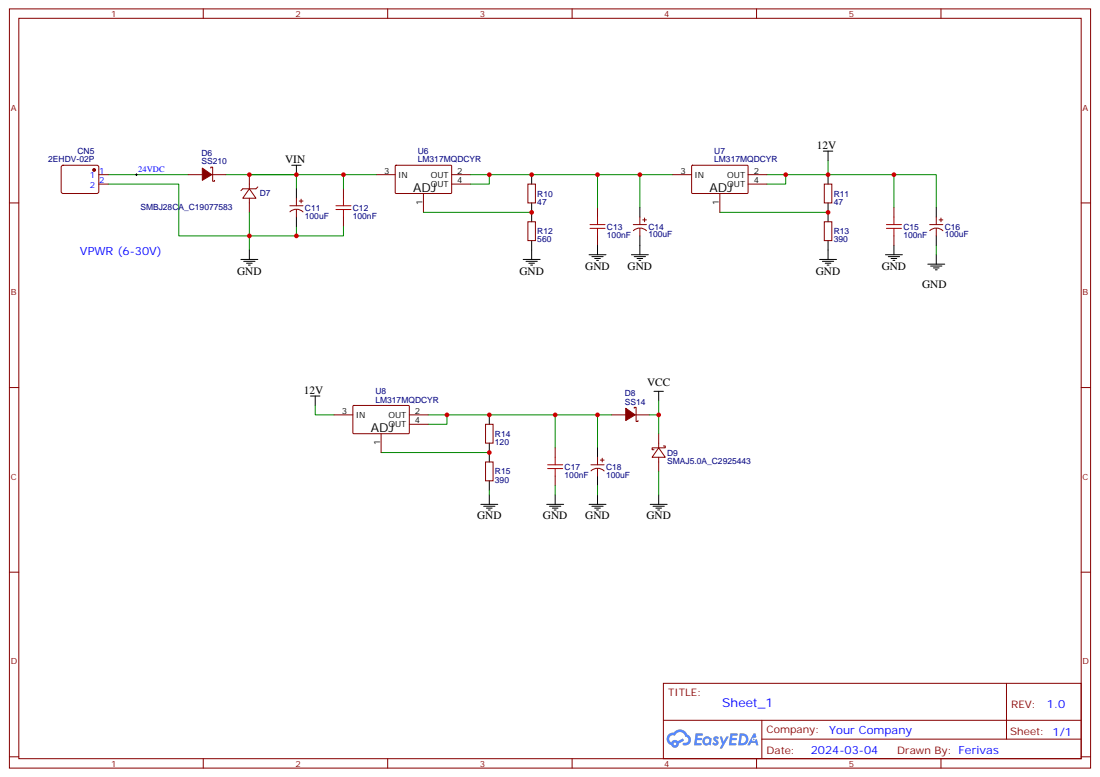
[picture p25: page 2]

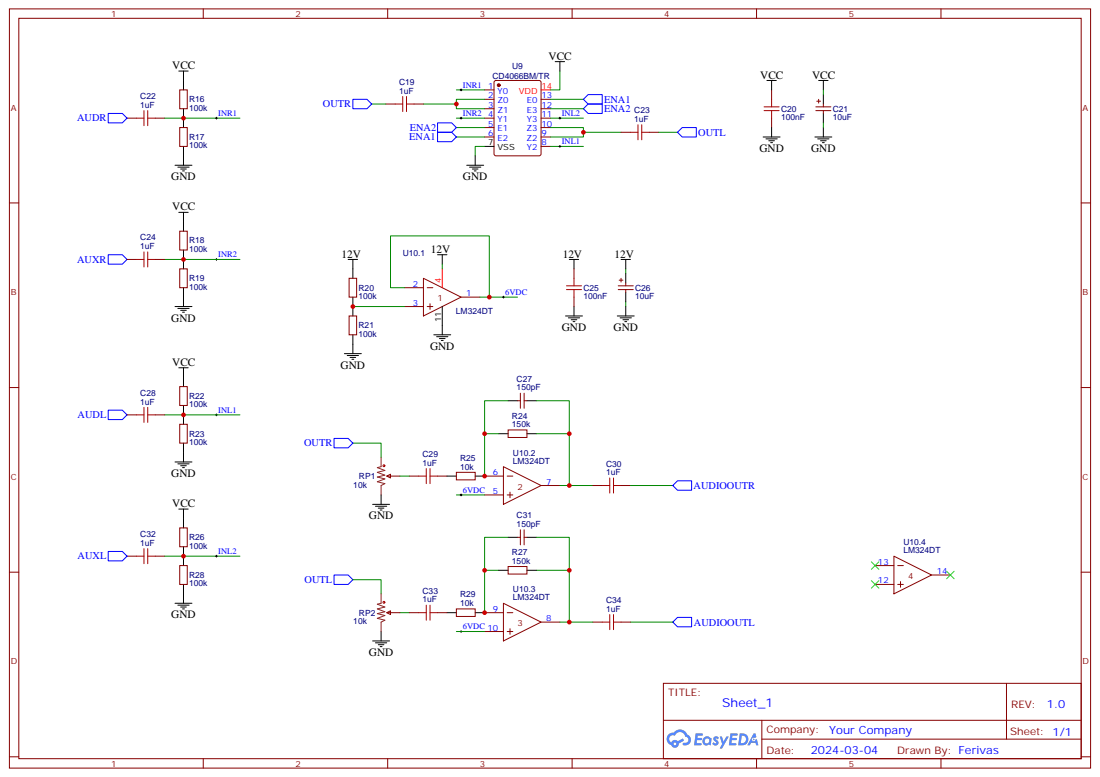
[picture p26: page 3]
