Ferivas/RADIOBRIDGE/SCH/DRVLEDSAT/Schematic_DRVLEDSAT_2026-05-25.pdf

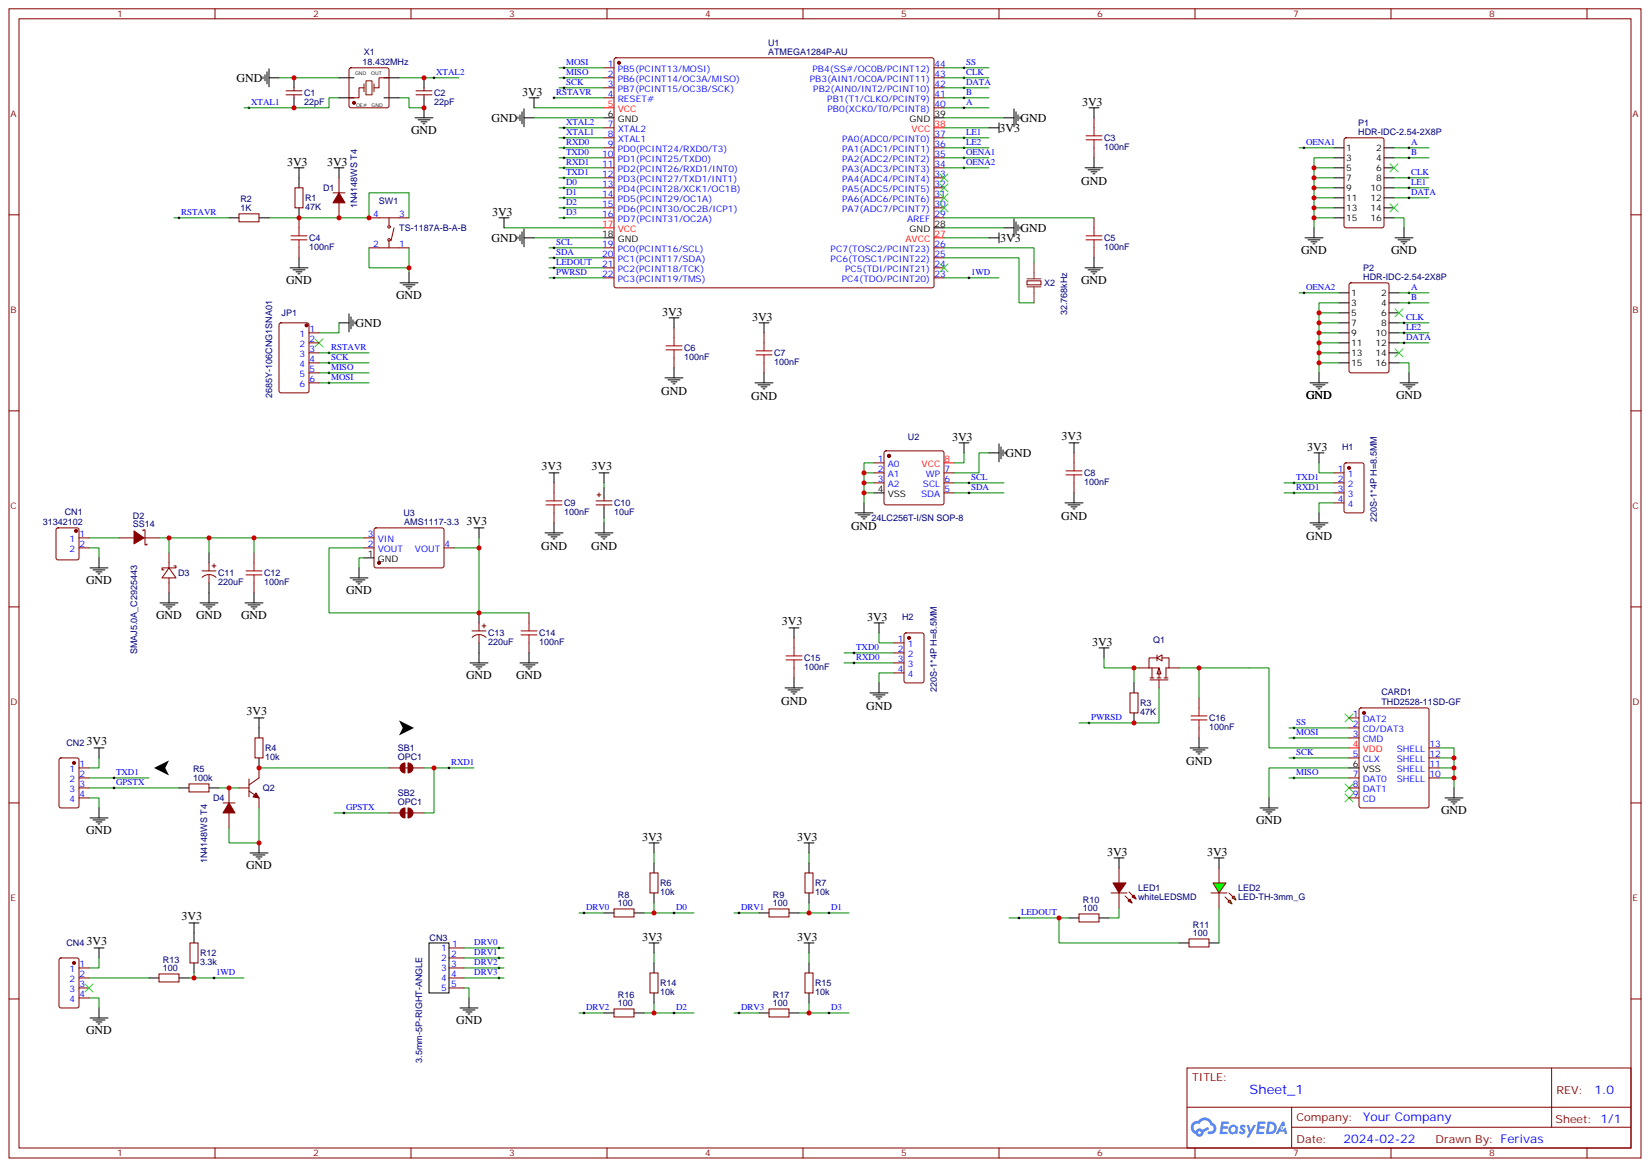
[picture p27: page 1]
