Ferivas/RADIOBRIDGE/SCH/SATMASTER/Schematic_MDBMODULO_2023-09-18.pdf

A | A

1

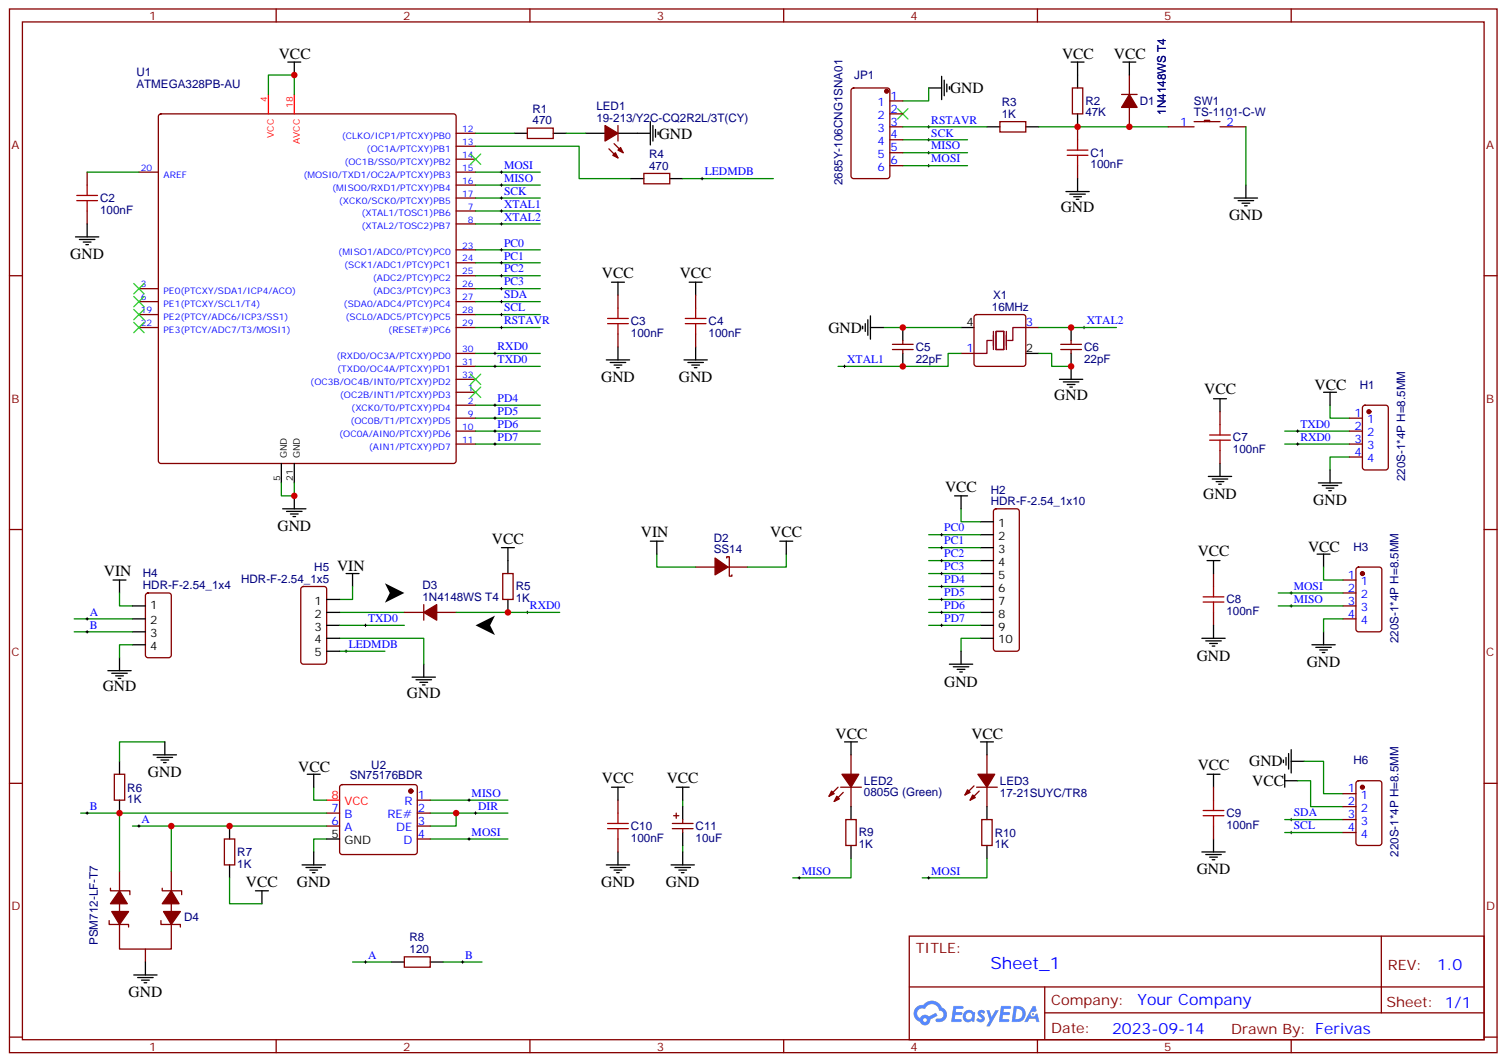
[picture p28: page 1]

Company: Your Company ¹N⁴¹⁴⁸WS T4
VCC
