Ferivas/RADIOBRIDGE/SCH/SATMASTER/Schematic_MICROGPS_2023-09-18.pdf

A | A

1

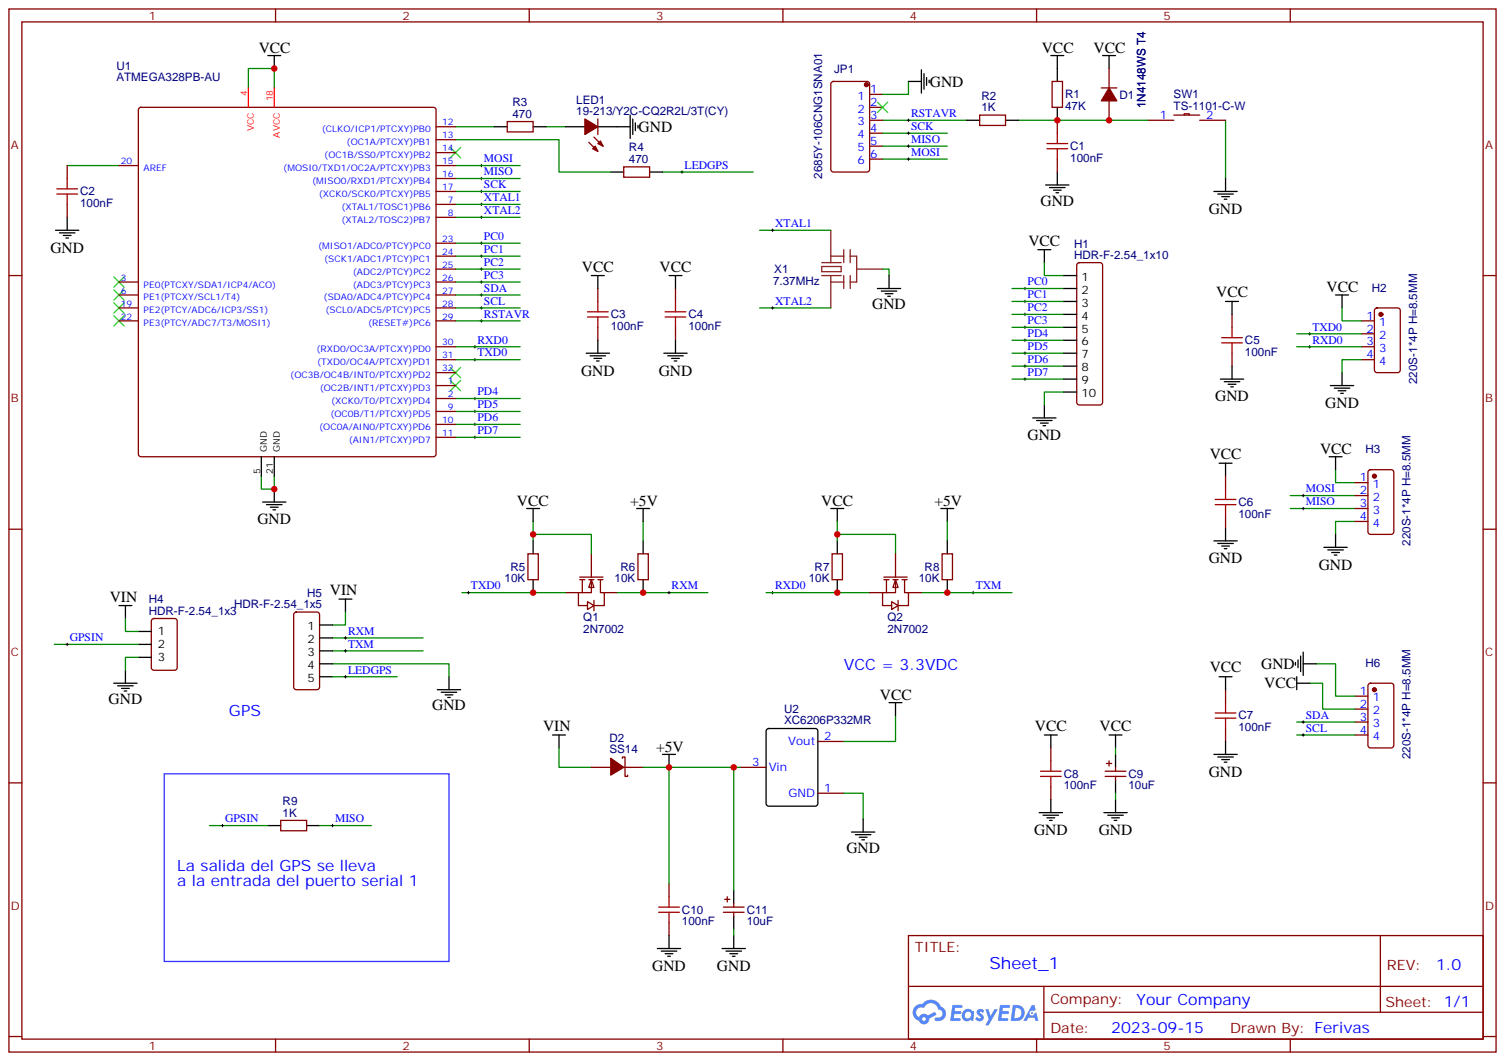
[picture p29: page 1]

La salida del GPS se lleva
a la entrada del puerto serial 1
