Ferivas/RADIOBRIDGE/SCH/SATMASTER/Schematic_SATMASTER_2023-09-18.pdf

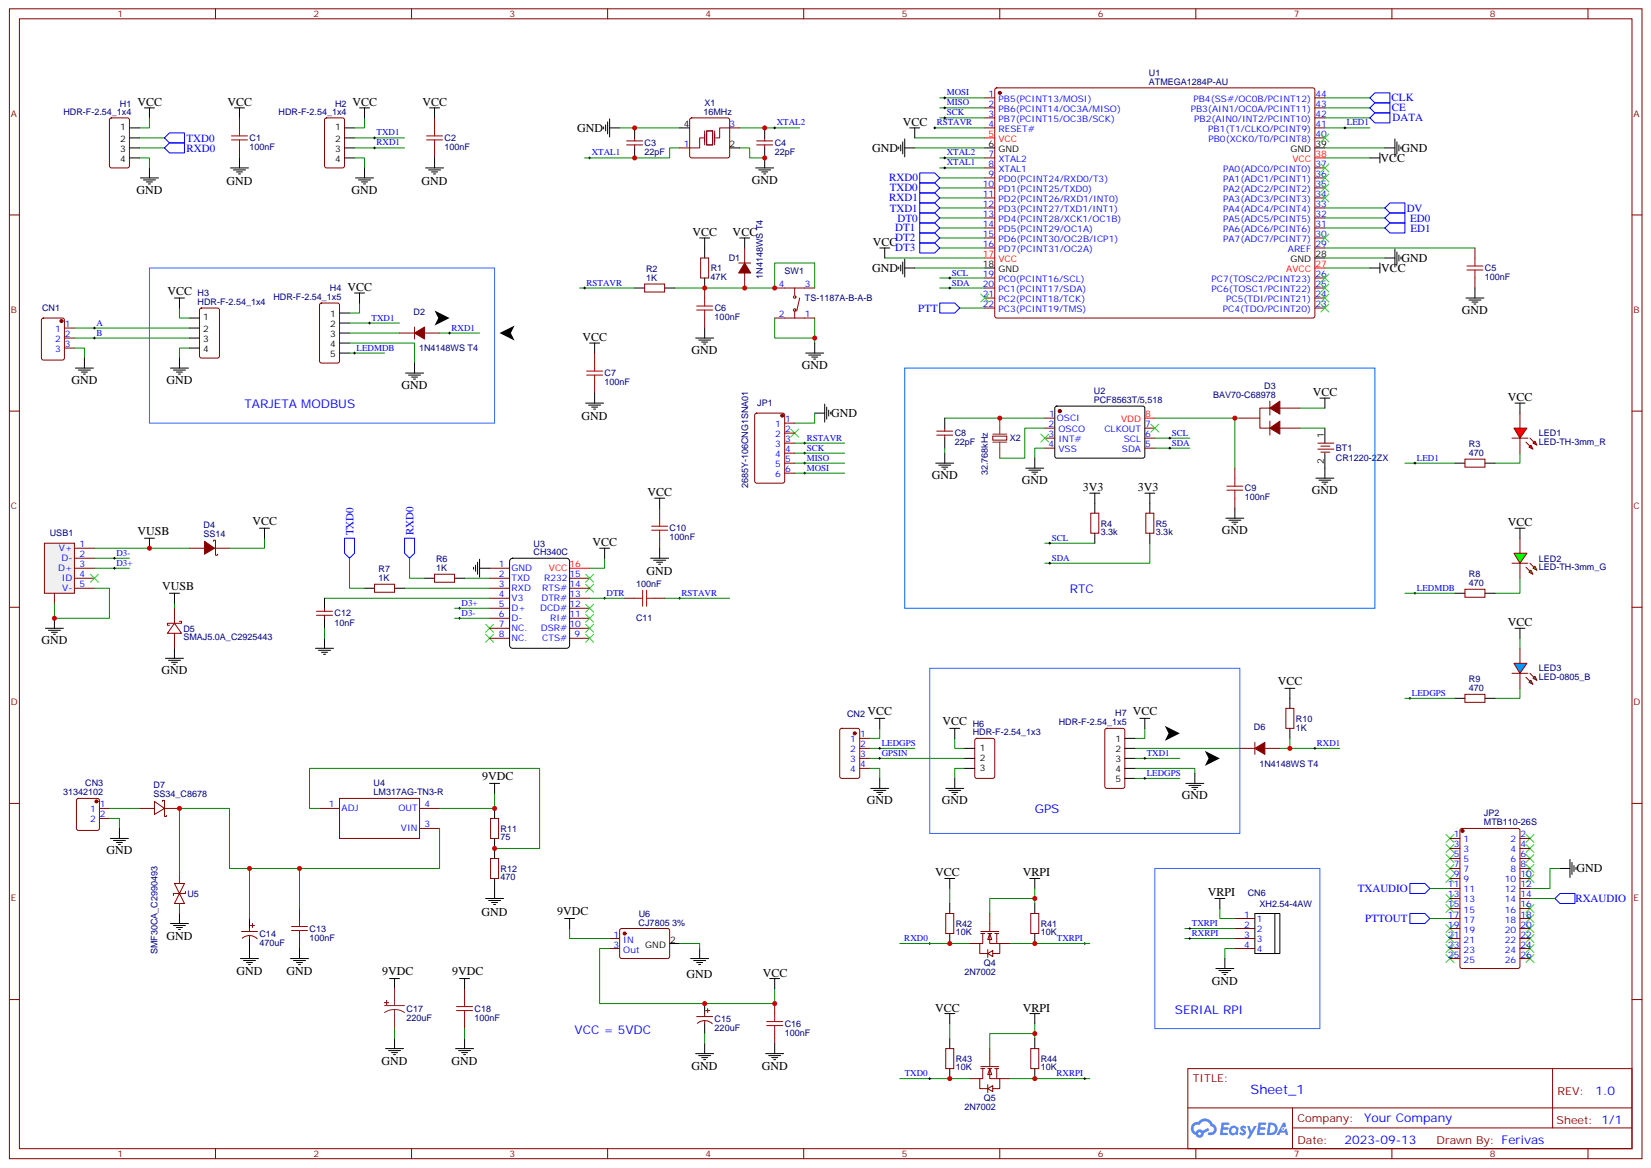
[picture p30: page 1]

# TOE 10 Q1 11 Q2 12 Q3 13 Q4 14 StD 15 ESt 16 St/GT 17 VDD 18

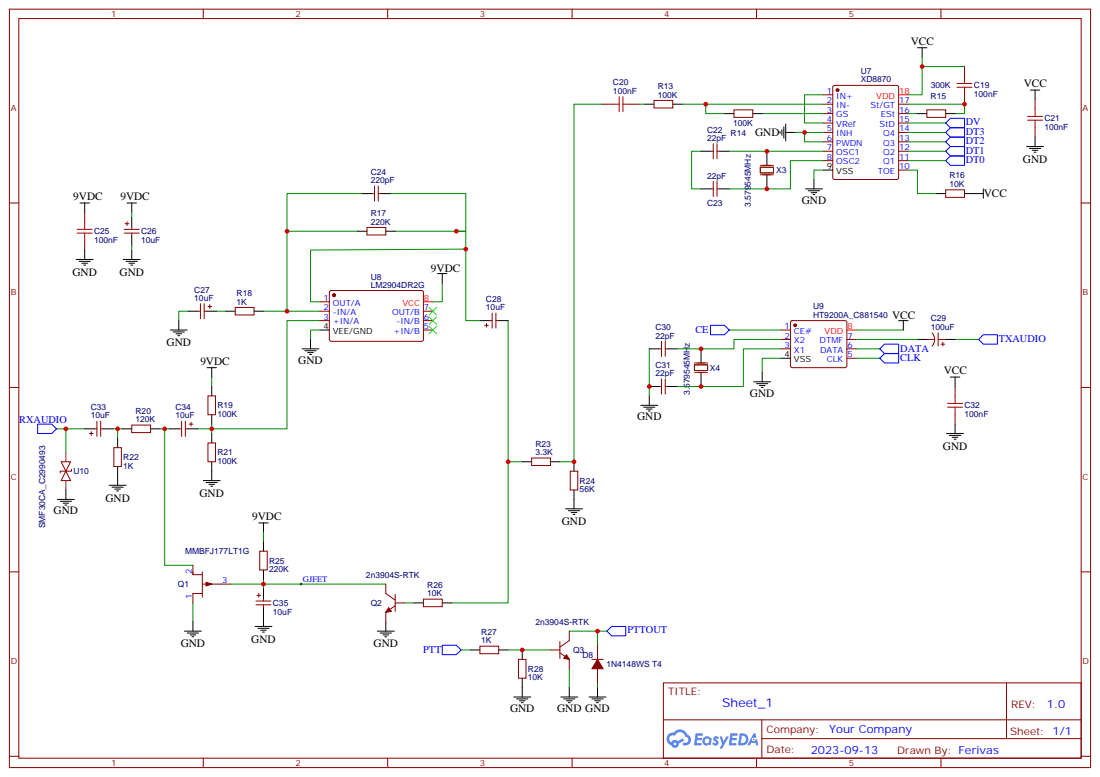
[picture p31: page 2]

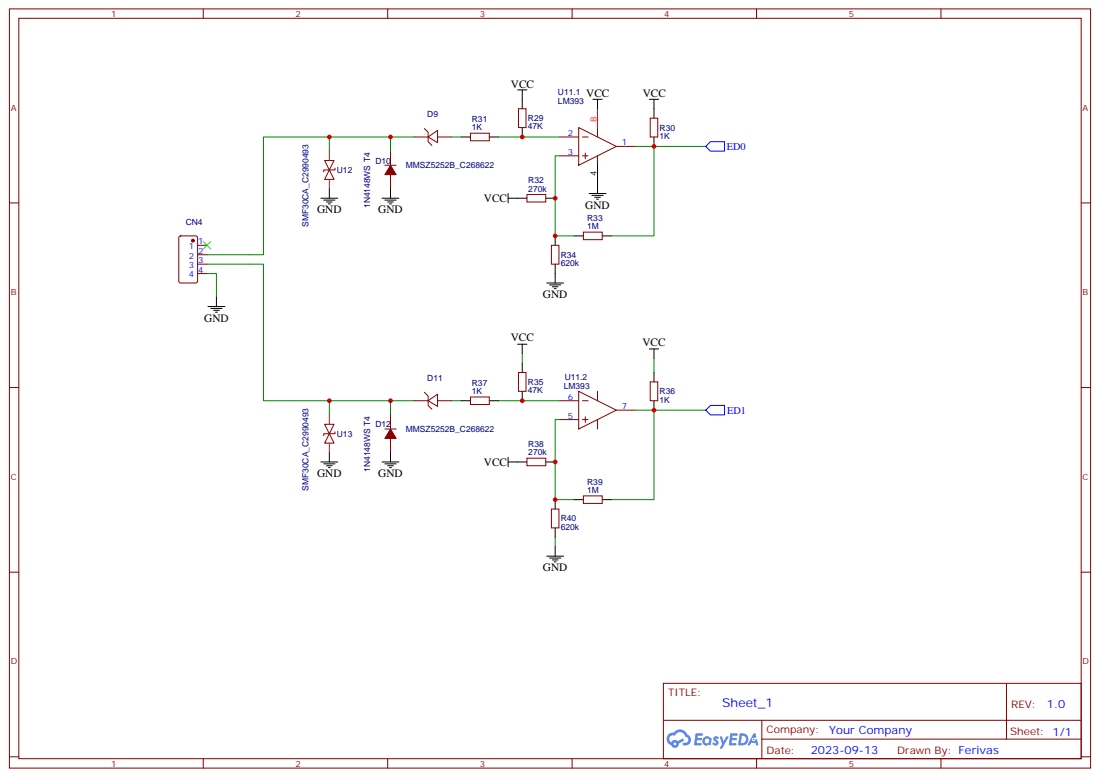
[picture p32: page 3]
