Ferivas/RADIOBRIDGE/SCH/JLCPCB/Schematic_RADIOBRIDGE_2022-02-17.pdf

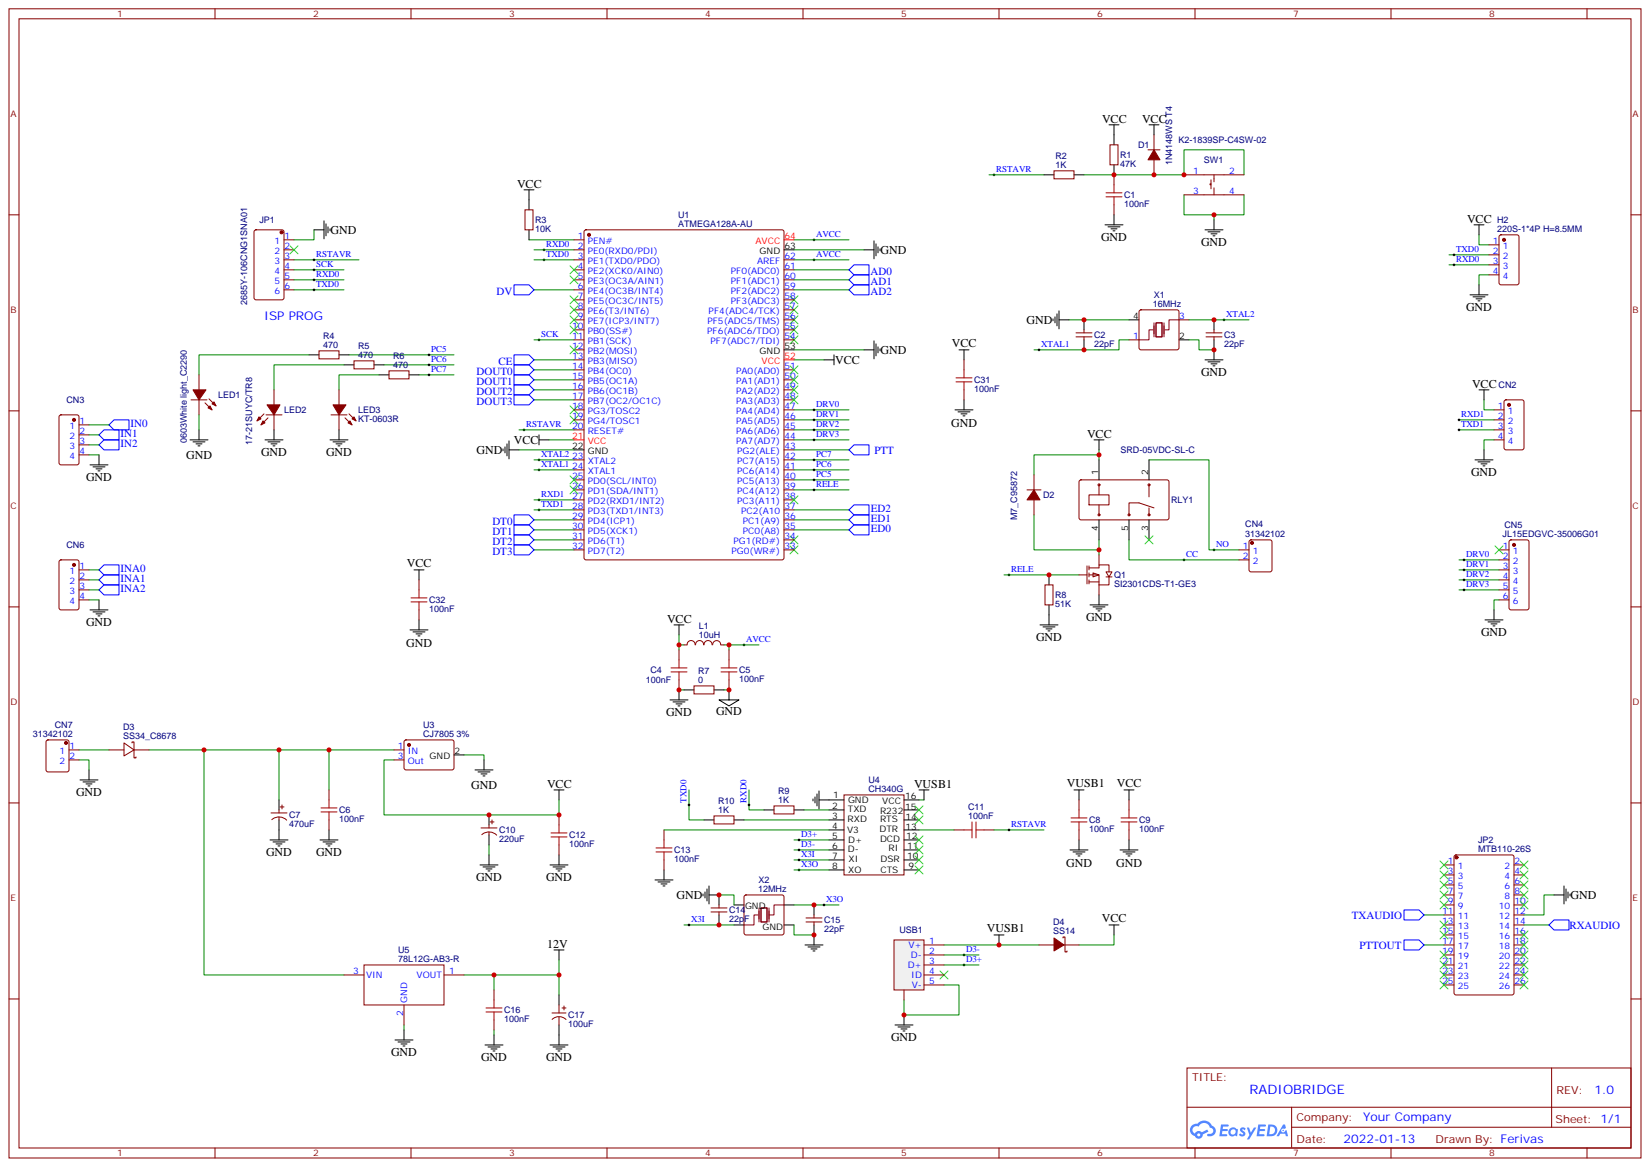
[picture p33: page 1]

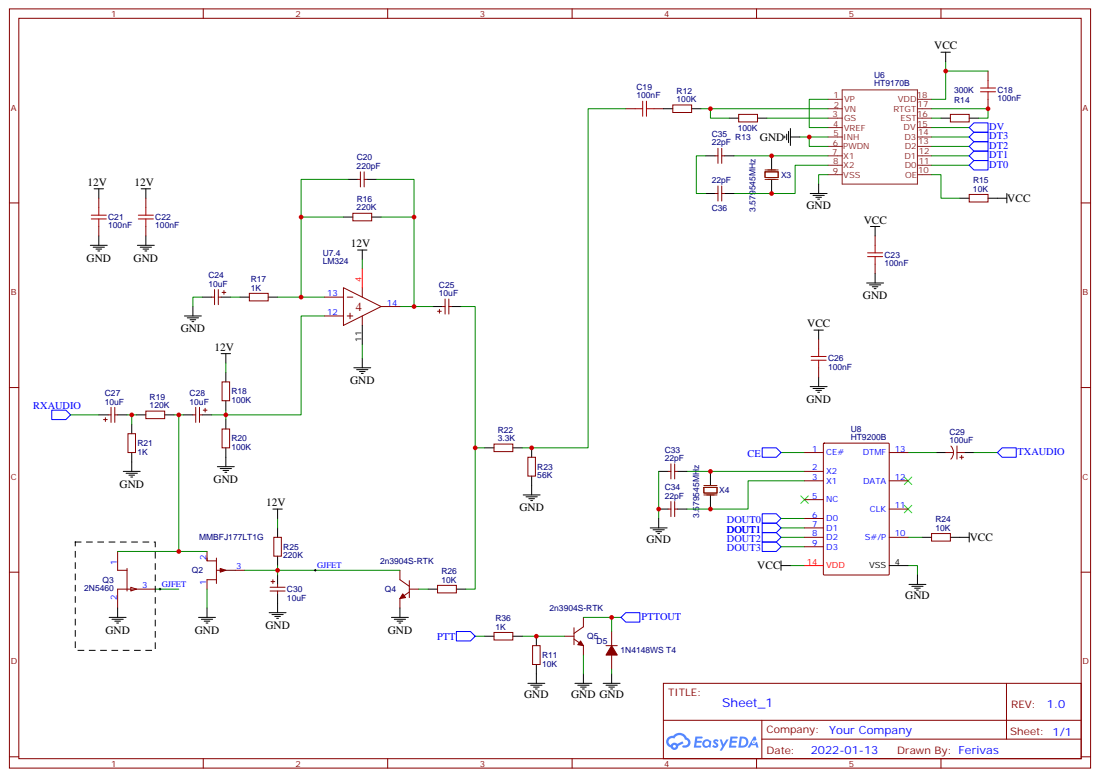
[picture p34: page 2]

1

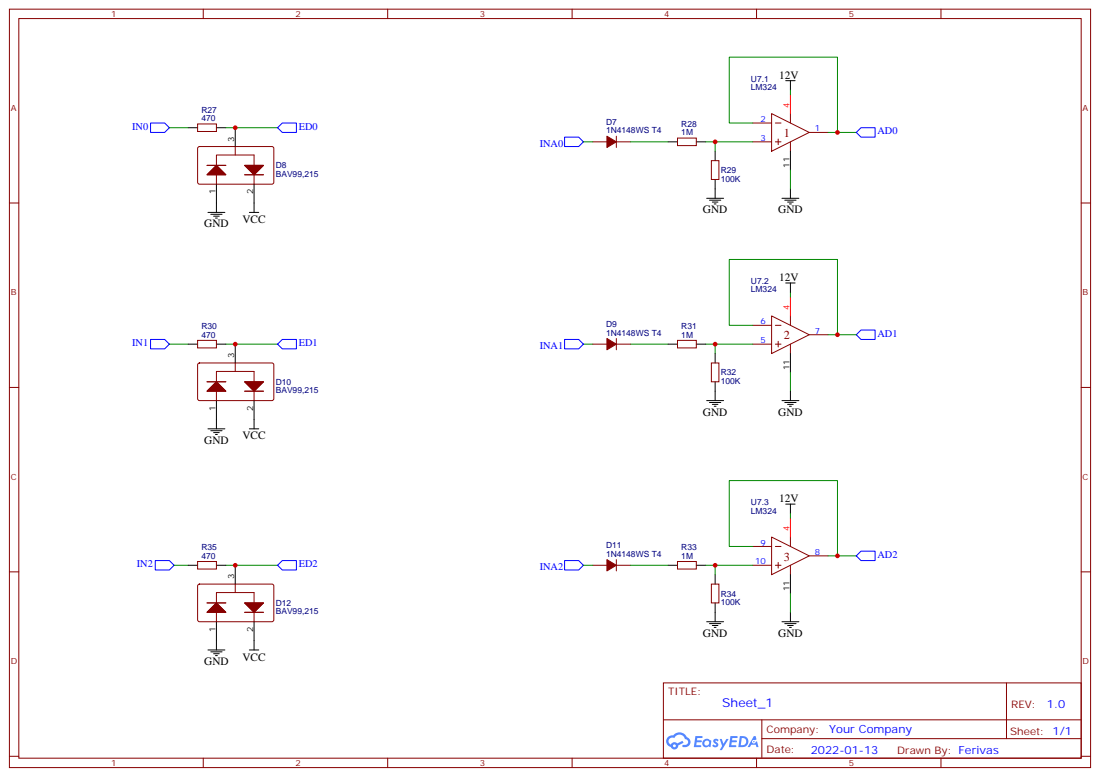
[picture p35: page 3]
