Ferivas/RADIOBRIDGE/SCH/DRVAUDIO/PCB_PCB_DRVAUDIOSAT_2024-05-30.pdf

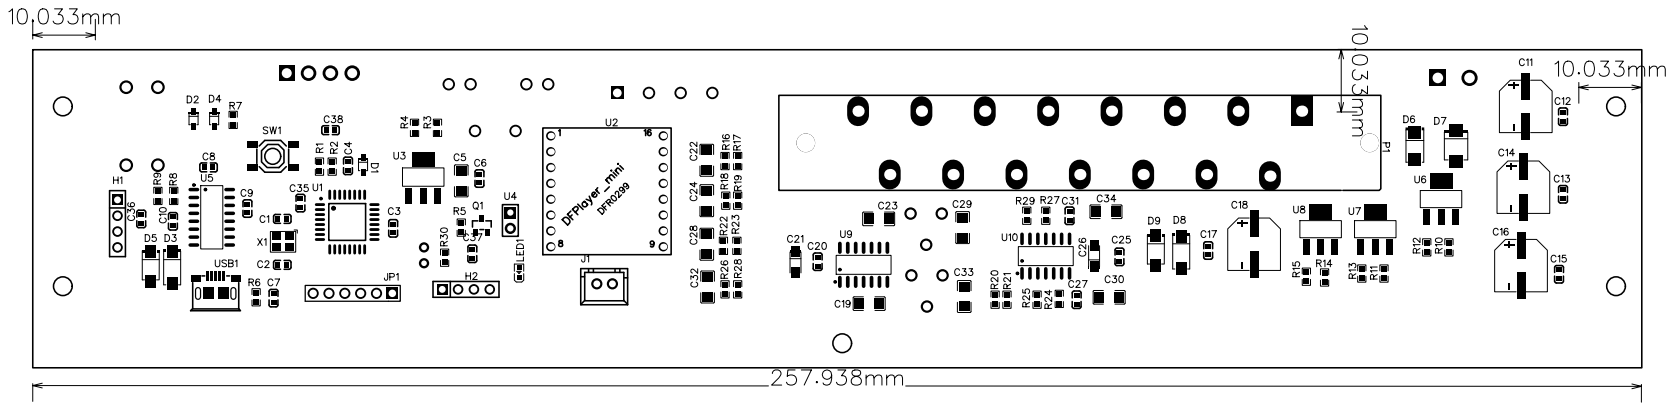
[picture p36: page 1]
