Ferivas/RADIOBRIDGE/SCH/JLCPCB/PCB__RADIOBRIDGE_TAPA_ACRILICO.pdf

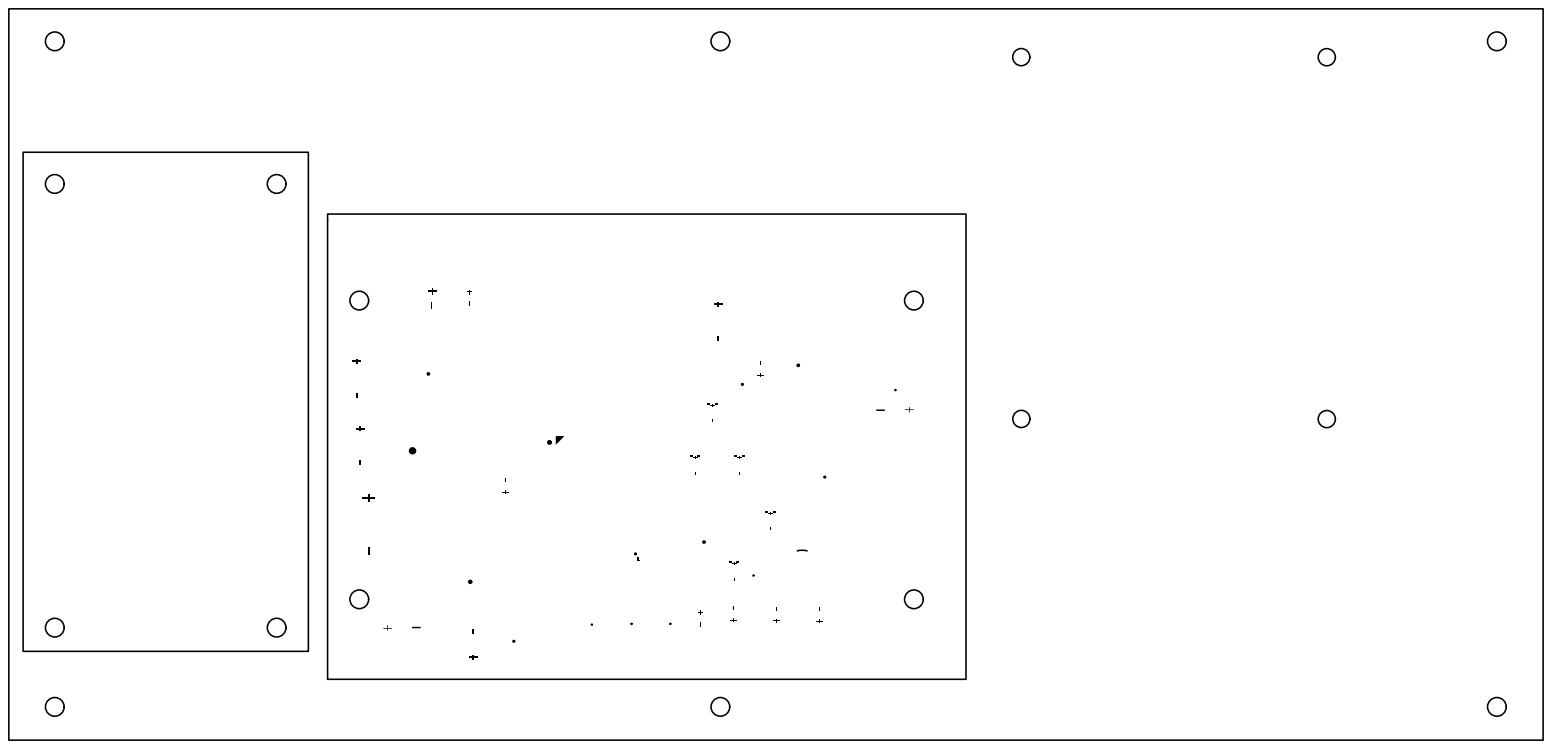
[picture p37: page 1]
