Ferivas/RADIOBRIDGE/SCH/SATMASTER/PCB_PCB_MDBMODULO_2023-09-25.pdf

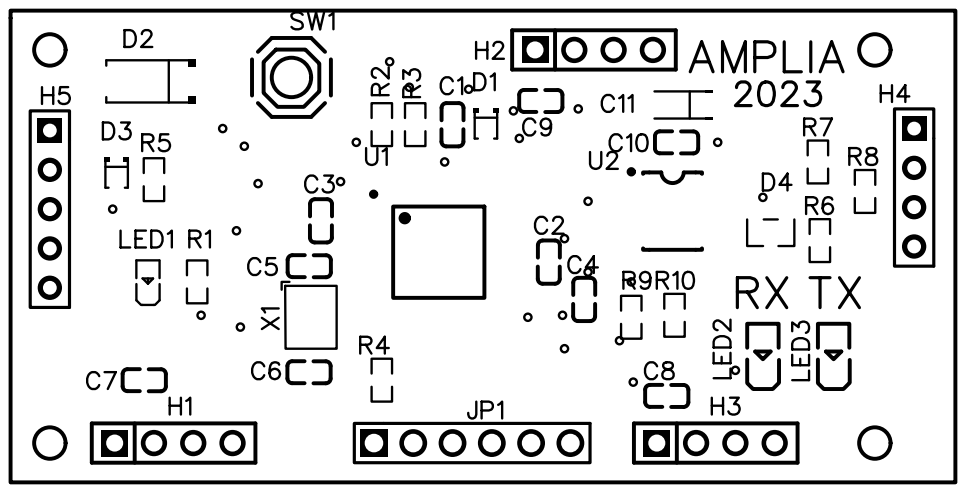
[picture p38: page 1]
