Ferivas/RADIOBRIDGE/SCH/SATMASTER/PCB_PCB_MICROGPS_2023-09-25.pdf

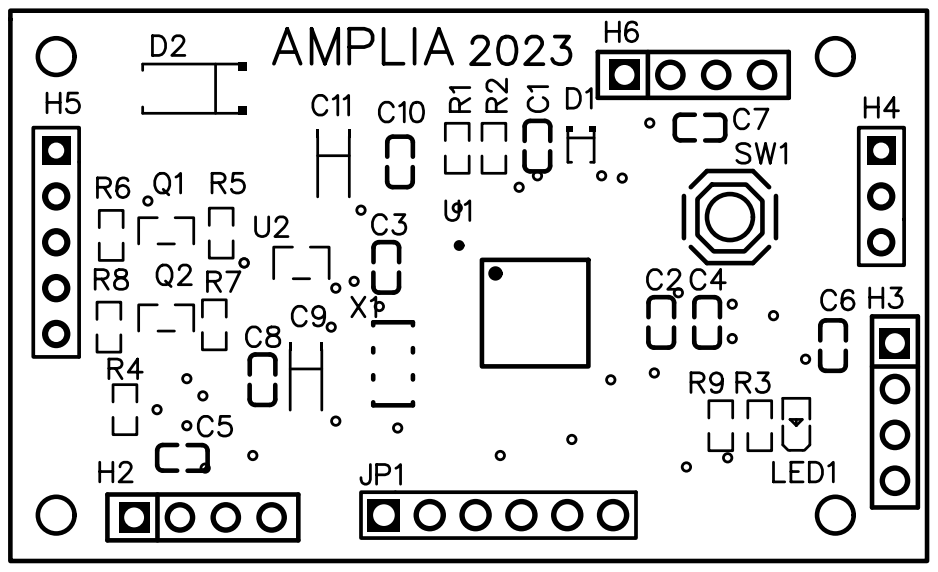
[picture p39: page 1]
