Ferivas/RADIOBRIDGE/SCH/SATMASTER/PCB_PCB_SATMASTER_2023-09-25.pdf

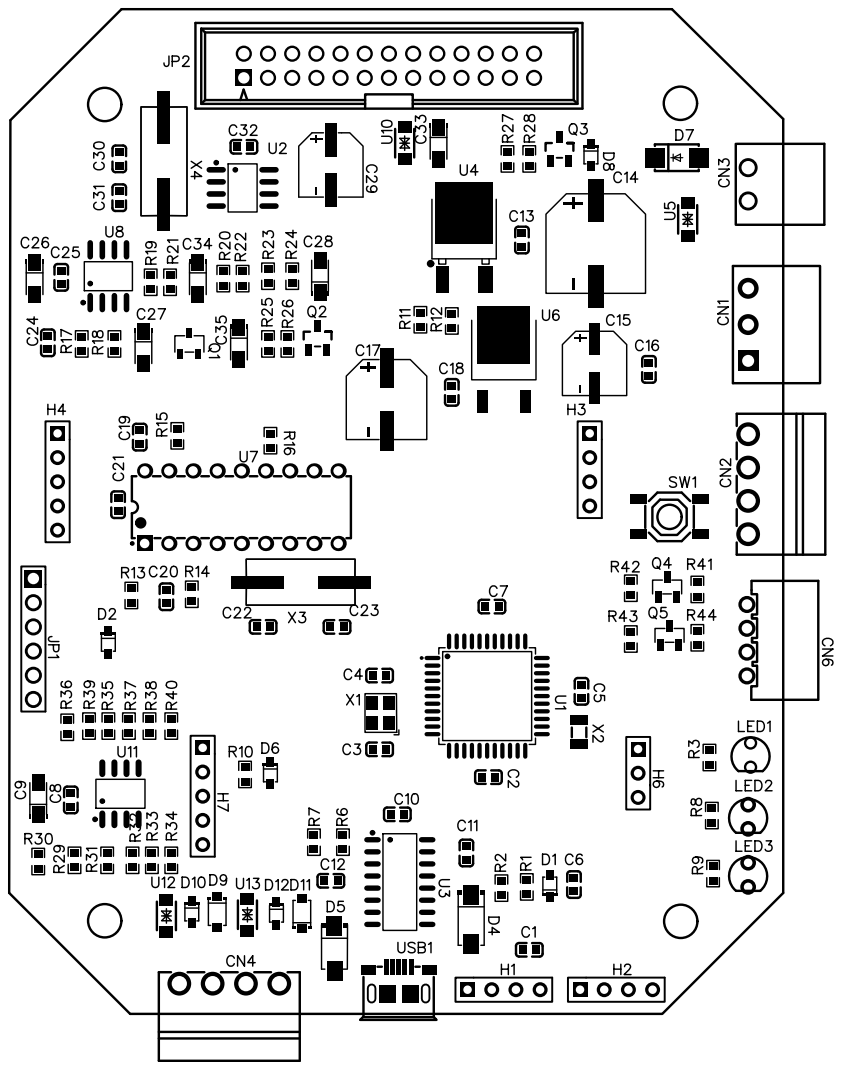
[picture p40: page 1]
