Ferivas/RADIOBRIDGE/SCH/JLCPCB/PCB_PCB_RADIOBRIDGE_2022-01-22.pcbdoc_2022-02-17.pdf

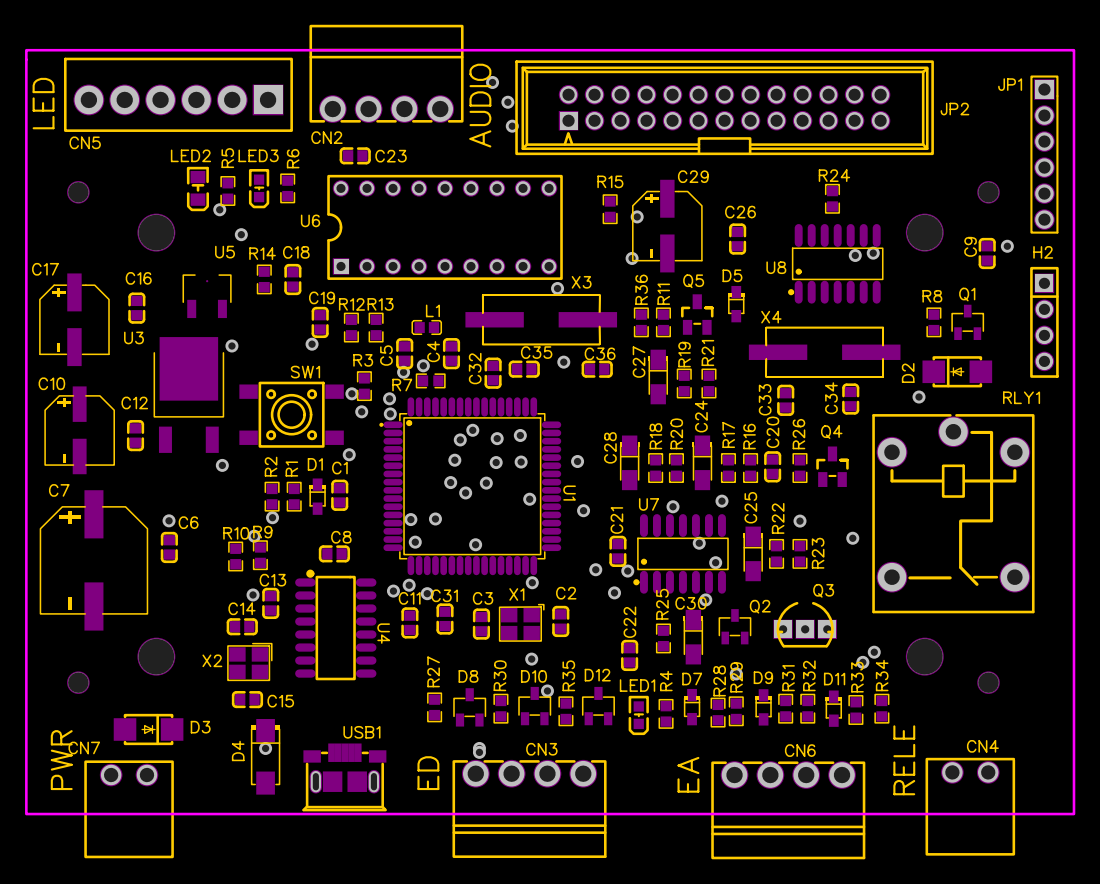
[picture p41: page 1]
