Ferivas/RADIOBRIDGE/SCH/RADIOBRIDGE_antiguo/RadioBridge.PDF

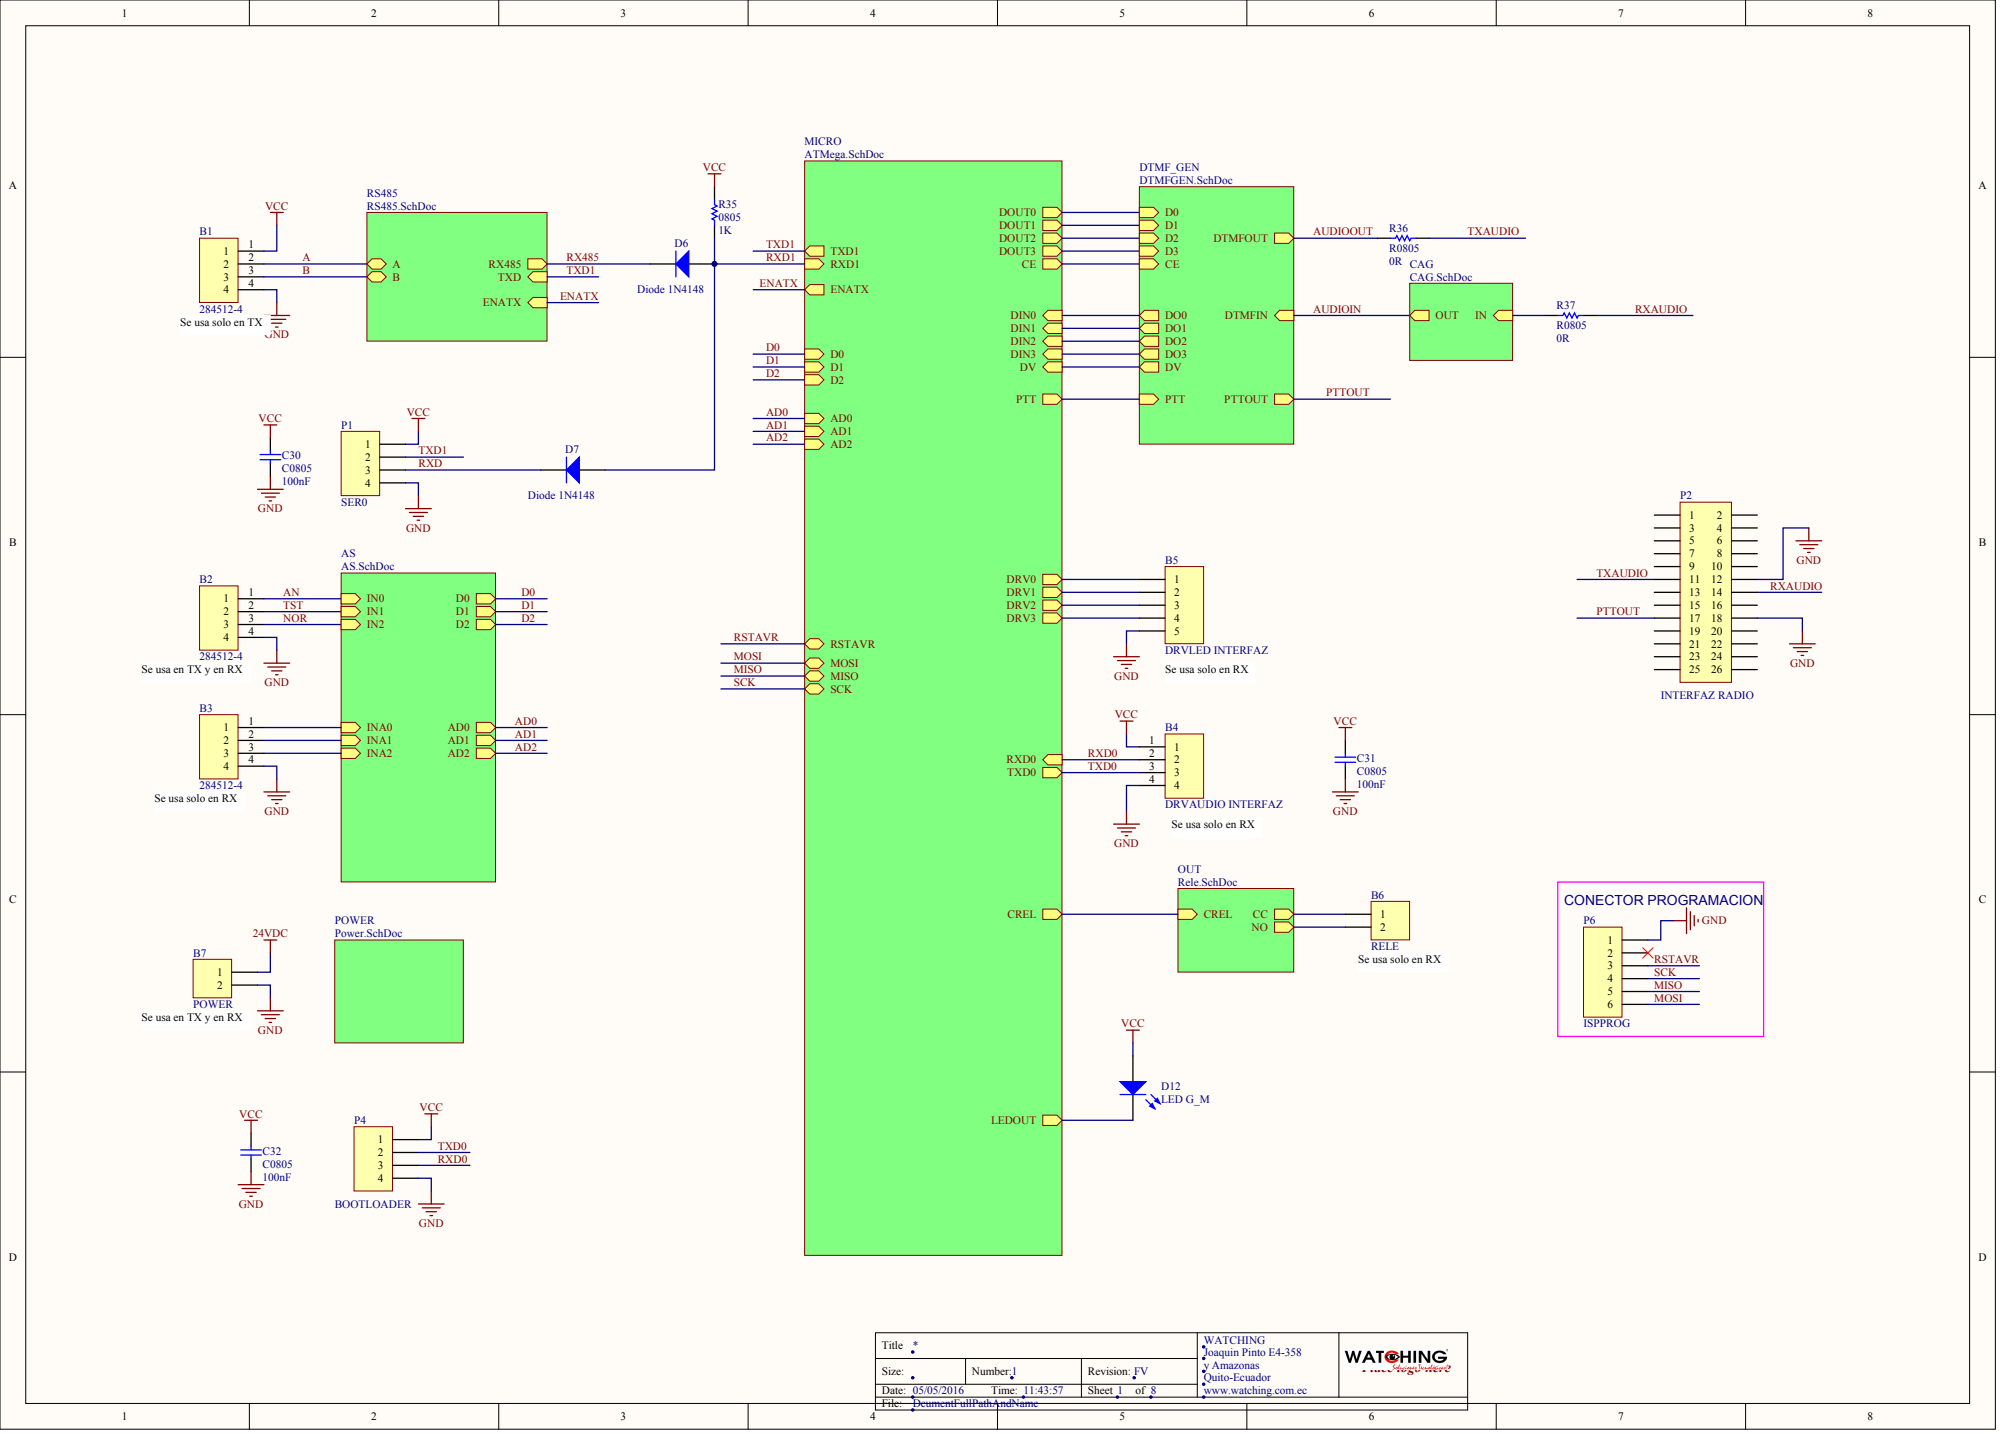
[picture p42: page 1]

2 TST | D1
3 NOR | D2
4 | AD0

DRVLED INTERFAZ
Se usa solo en RX

Se usa en TX y en RX

2 | AD1
3 | AD2

REL

Title * | WATCHING Joaquin Pinto E4-358 y Amazonas Quito-Ecuador www.watching.com.ec | Place logo here

Size: | Number: | Revision: F V
Date: File: 05/05/2016 Time: 11:43:57 | | Sheet of

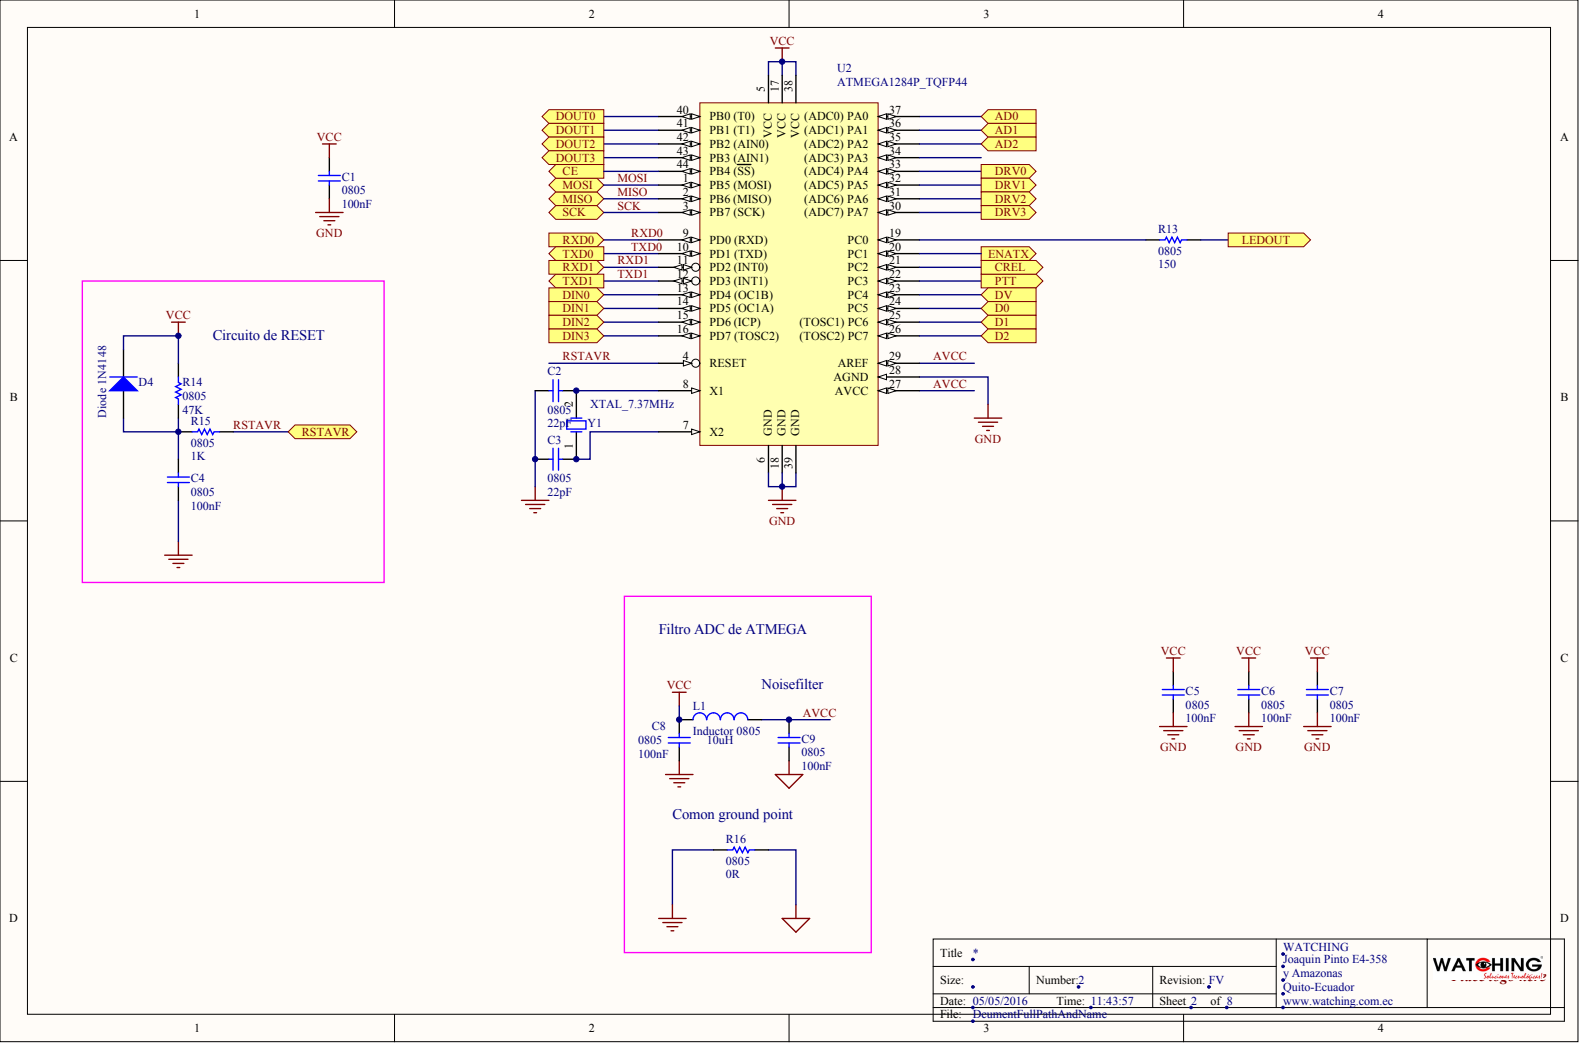
[picture p43: page 2]

Filtro ADC de ATMEGA

Title * | WATCHING Joaquin Pinto E4-358 y Amazonas

Date:

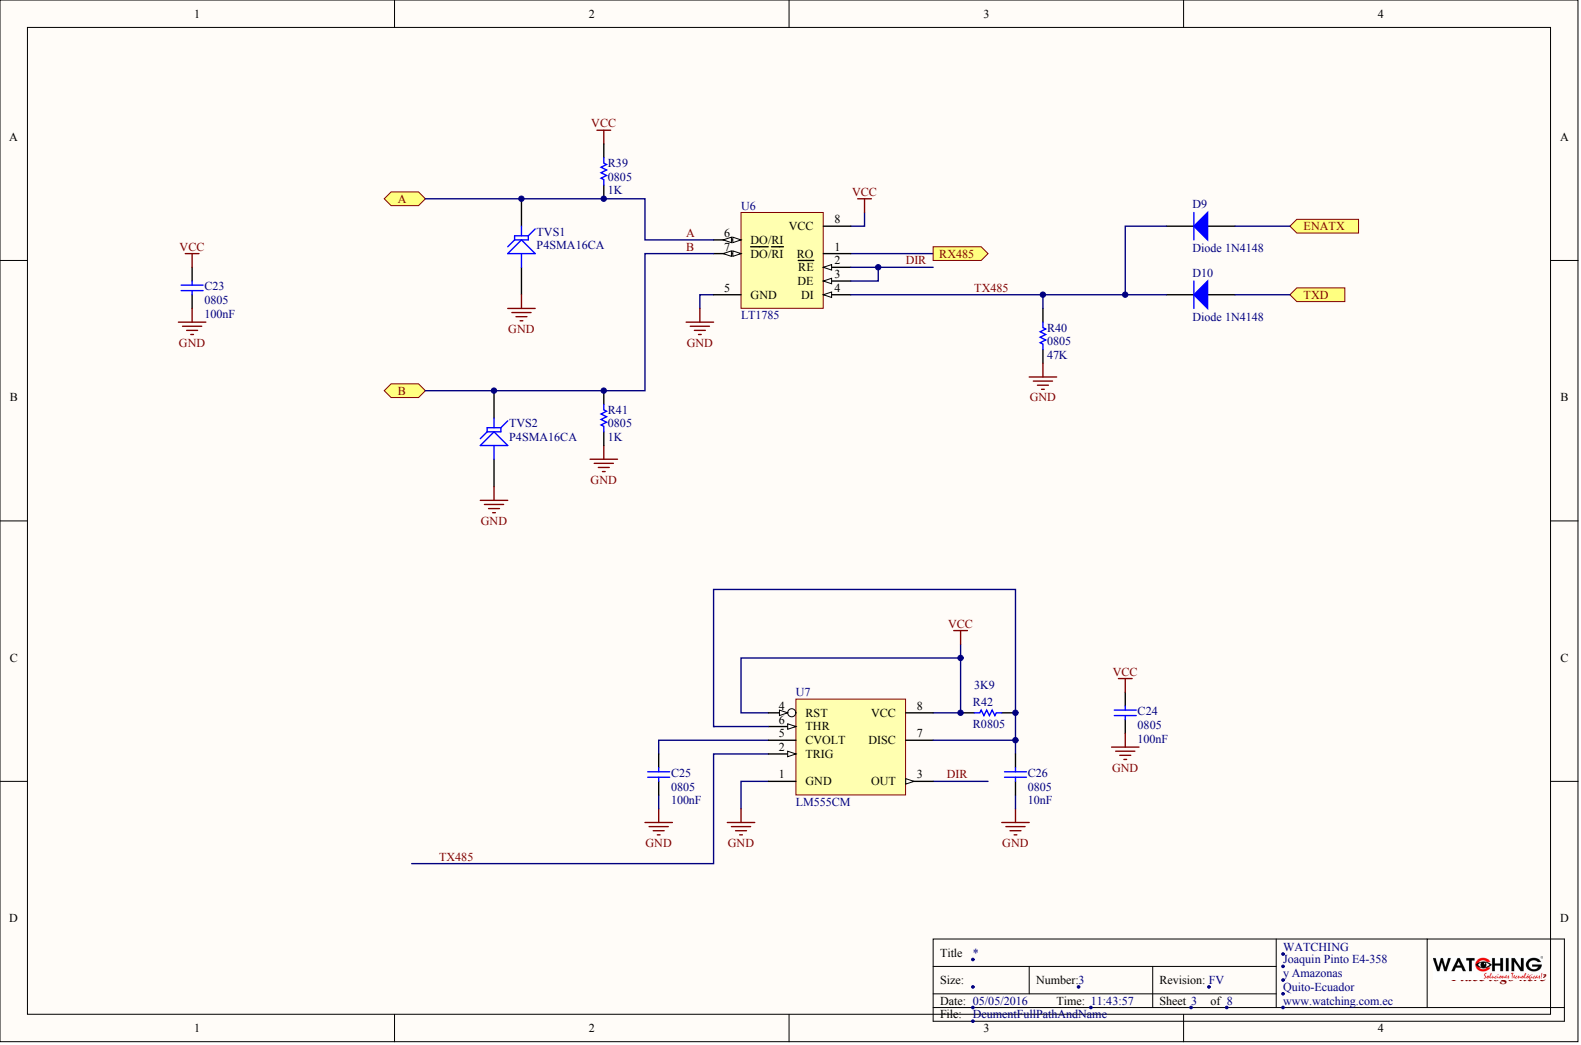
[picture p44: page 3]

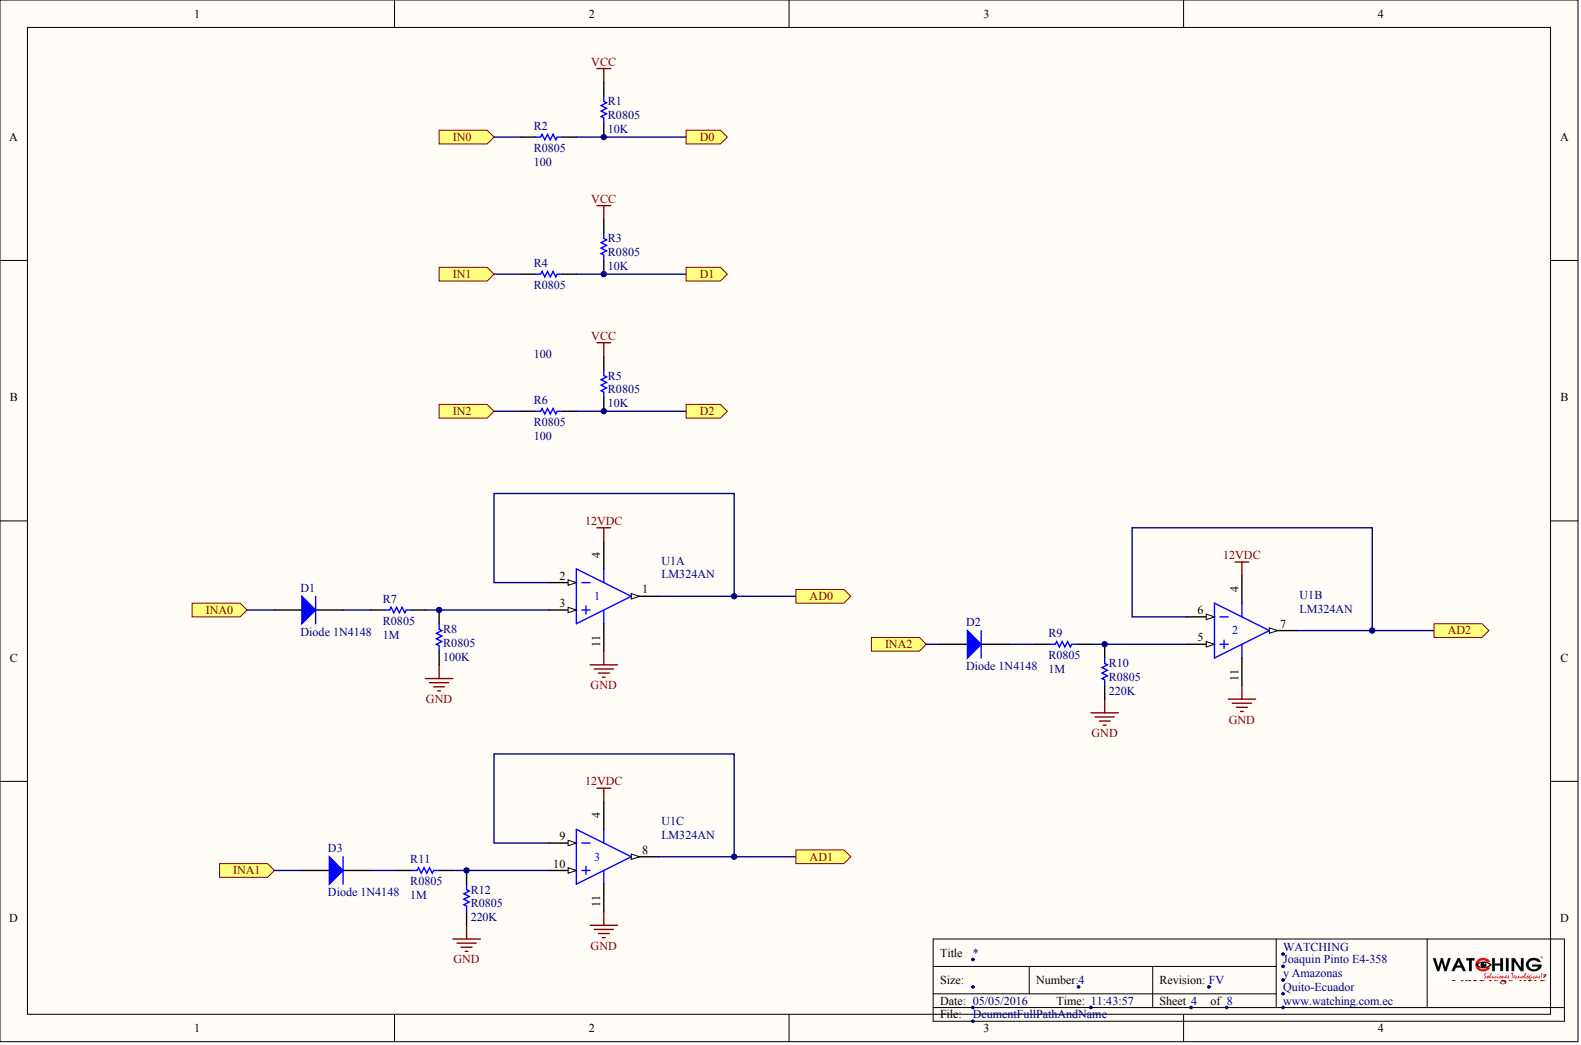
[picture p45: page 4]

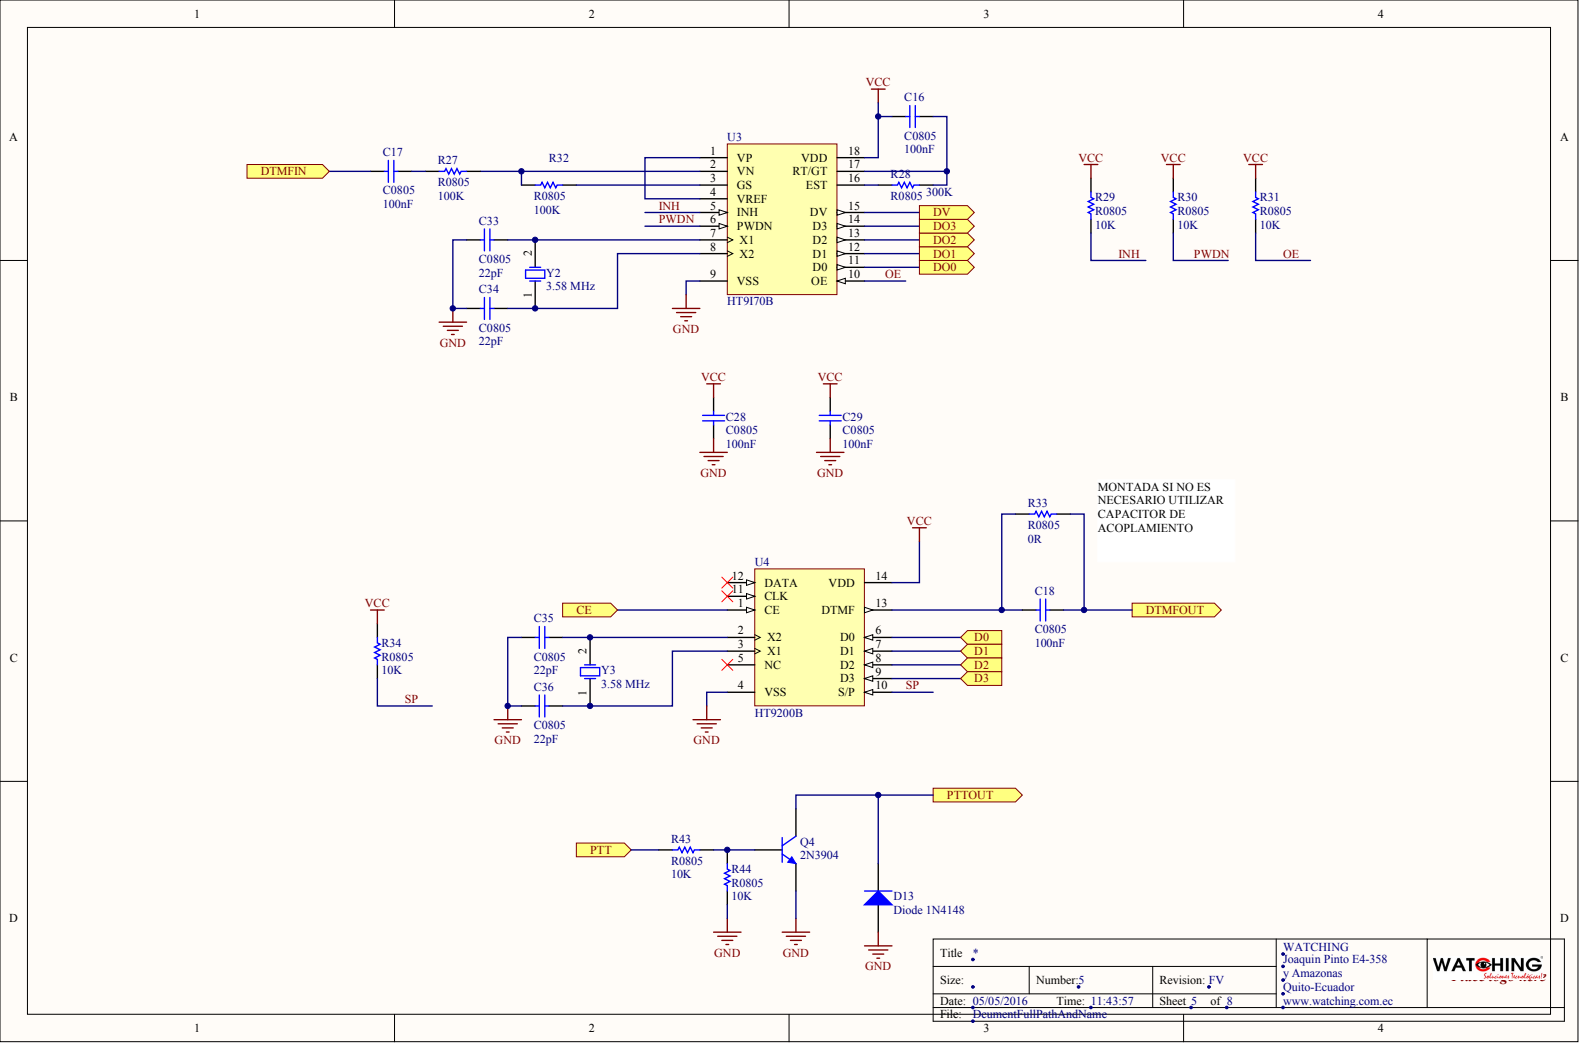
[picture p46: page 5]

MONTADA SI NO ES
NECESARIO UTILIZAR
CAPACITOR DE
ACOPLAMIENTO

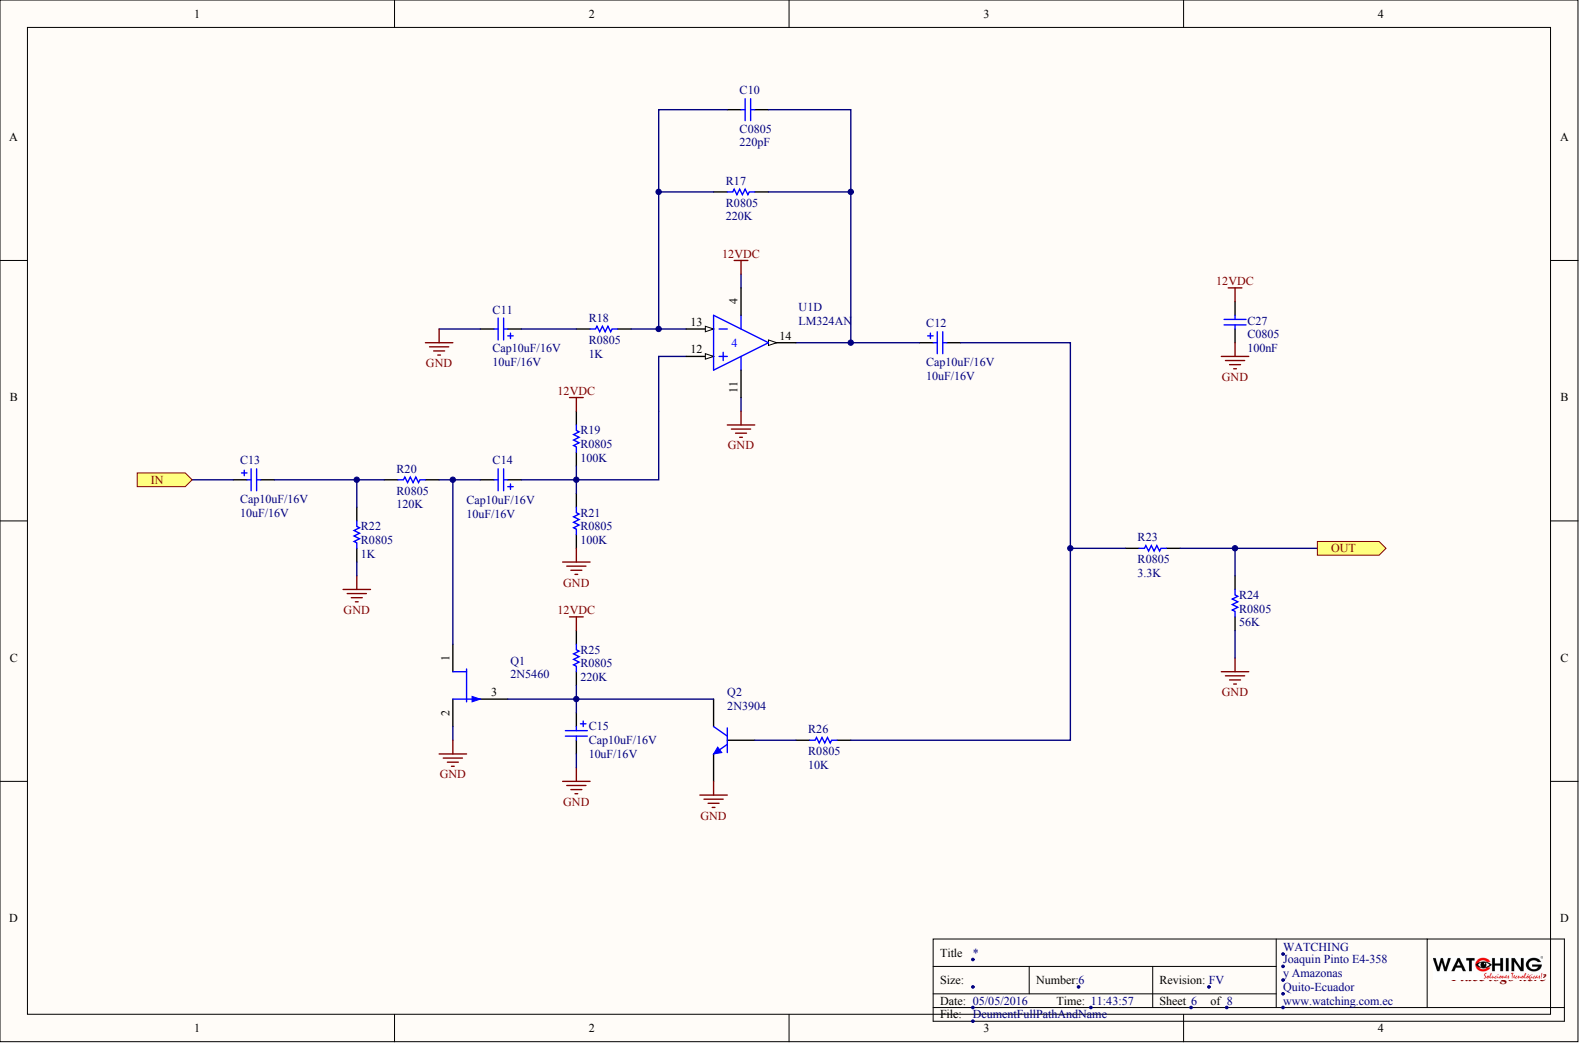
[picture p47: page 6]

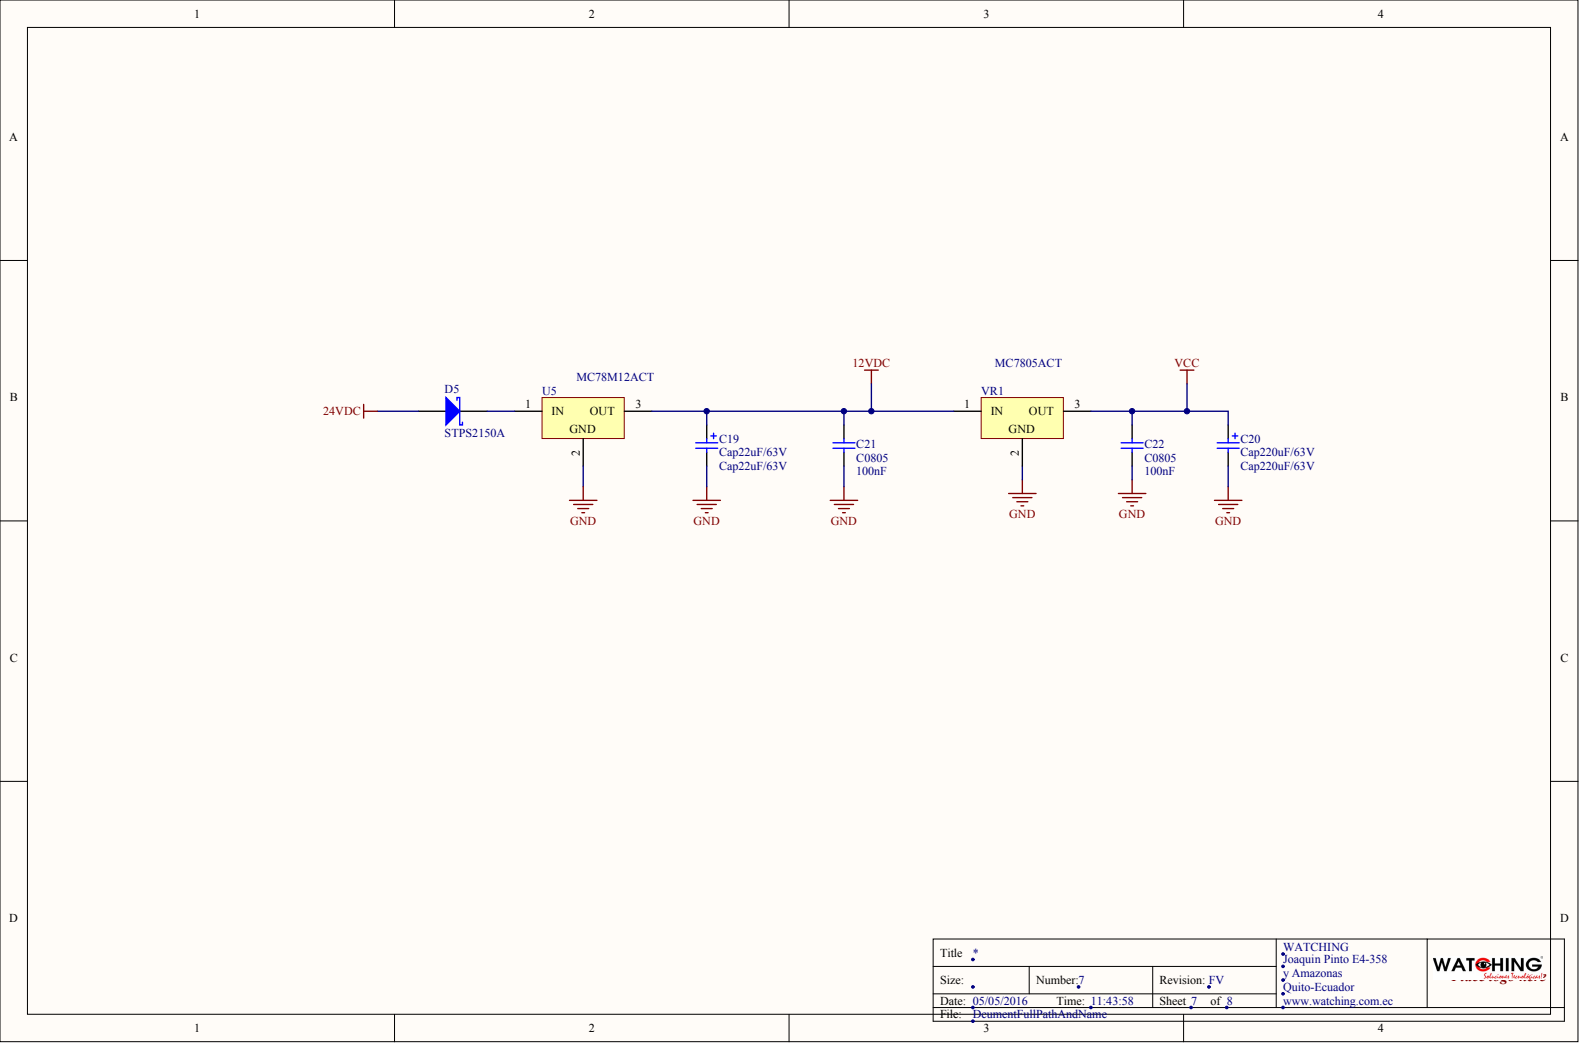
[picture p48: page 7]

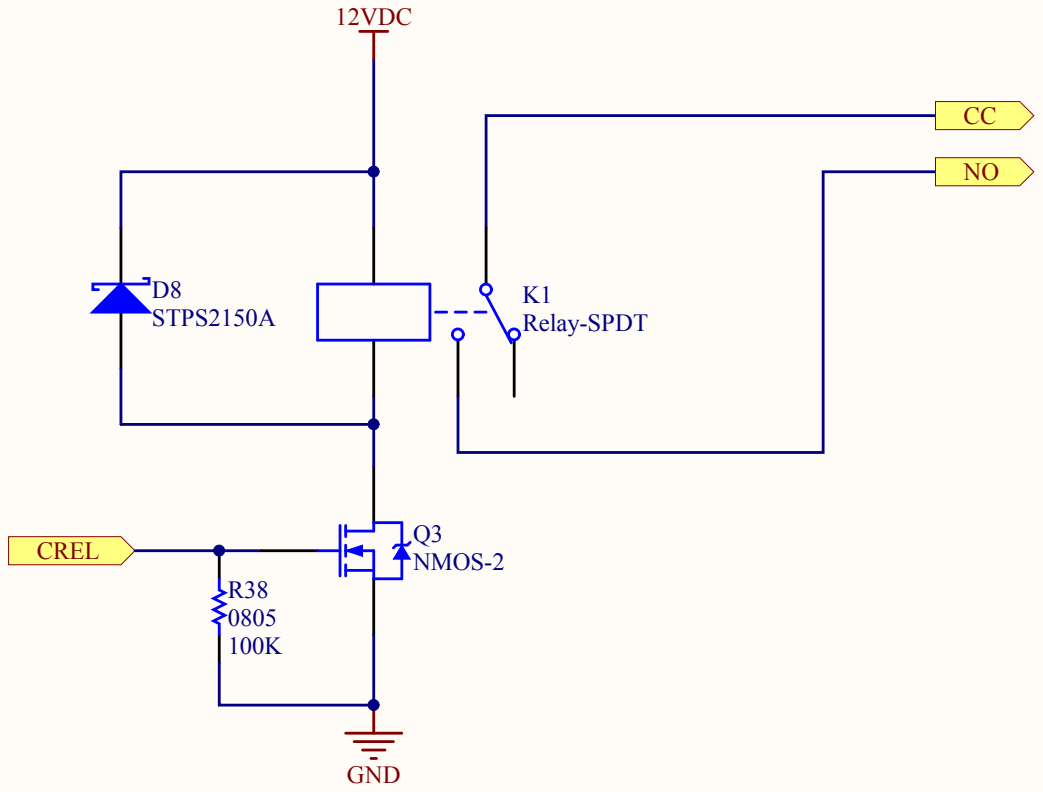
[picture p49: page 8]

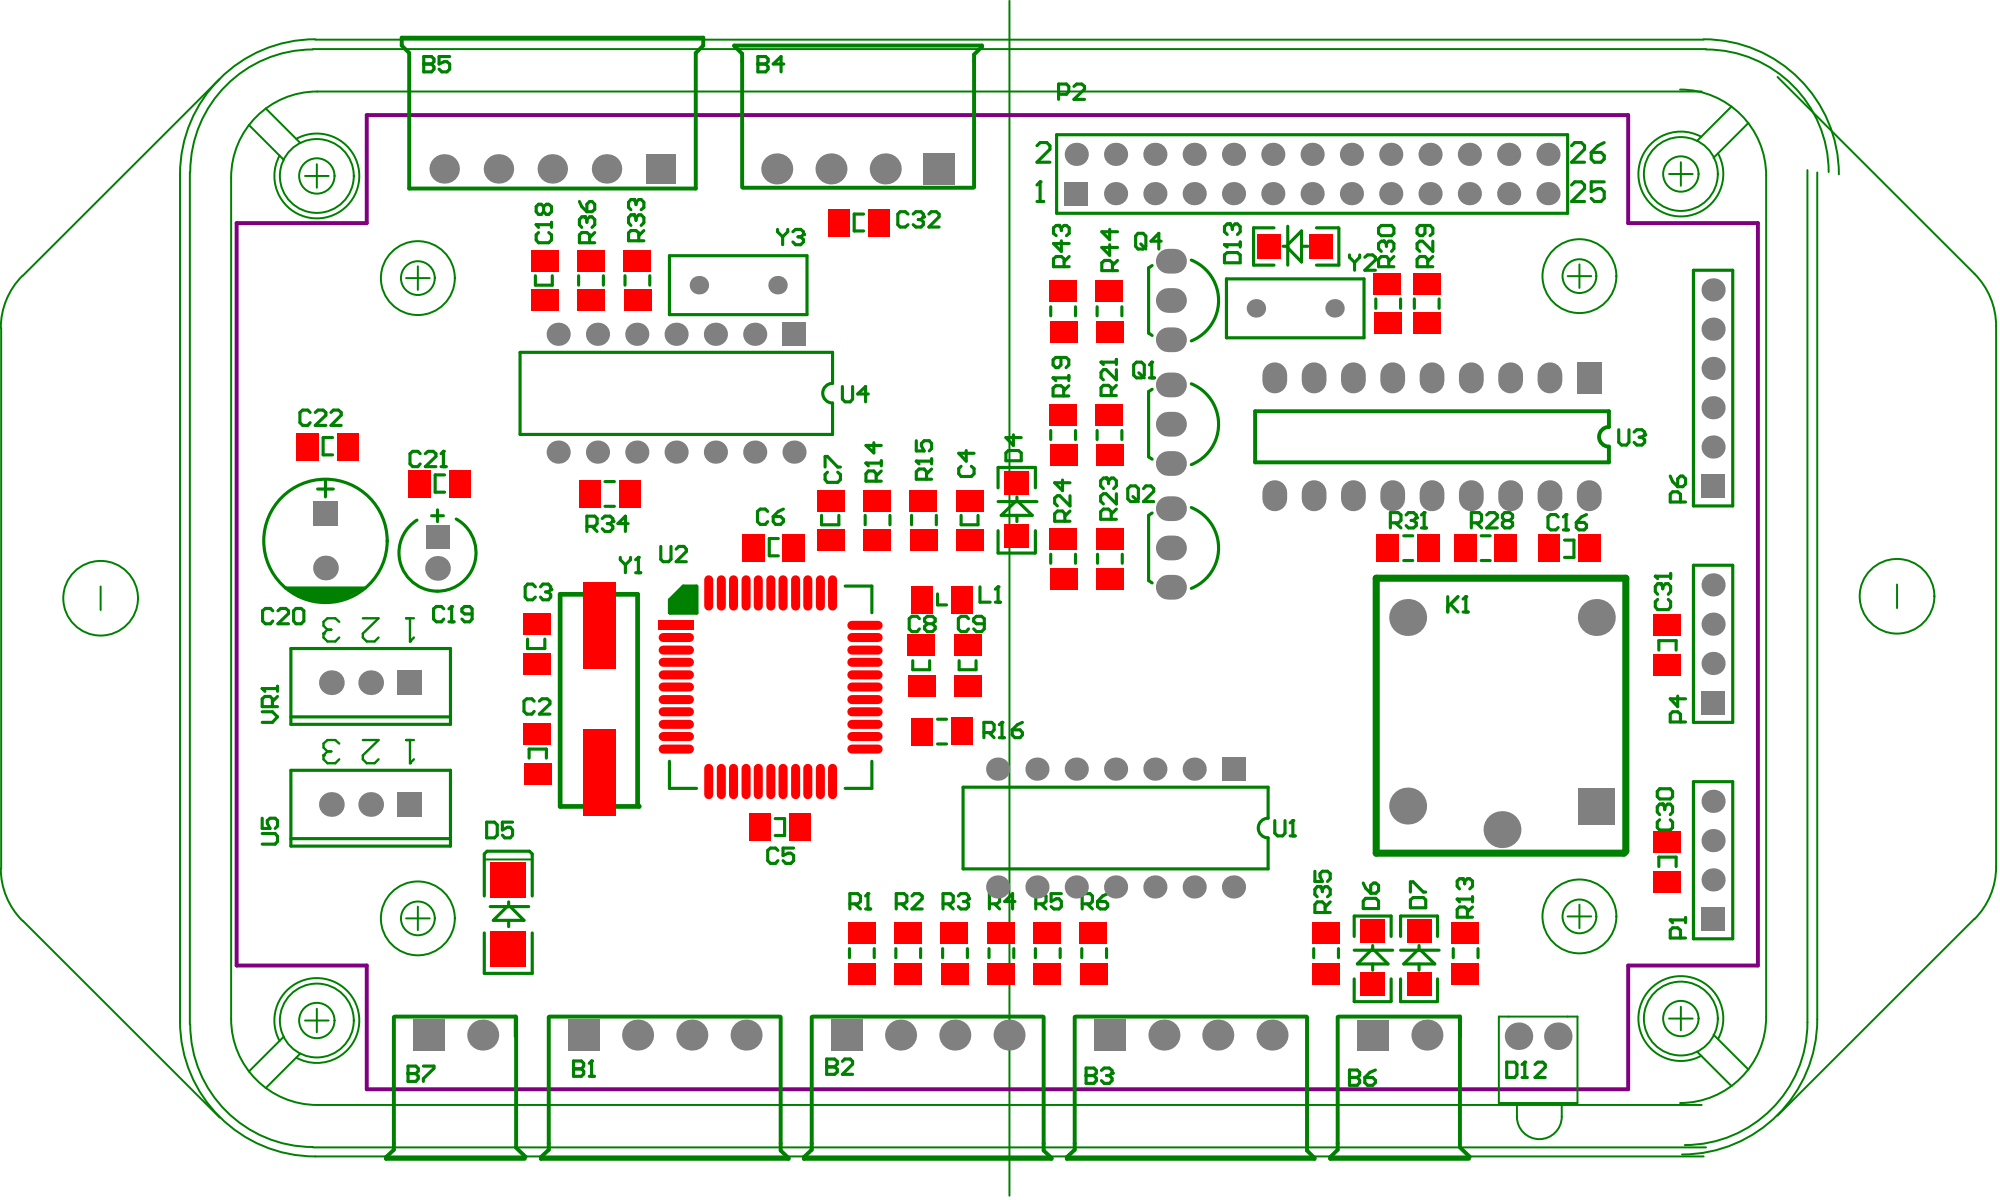
[picture p50: page 9]

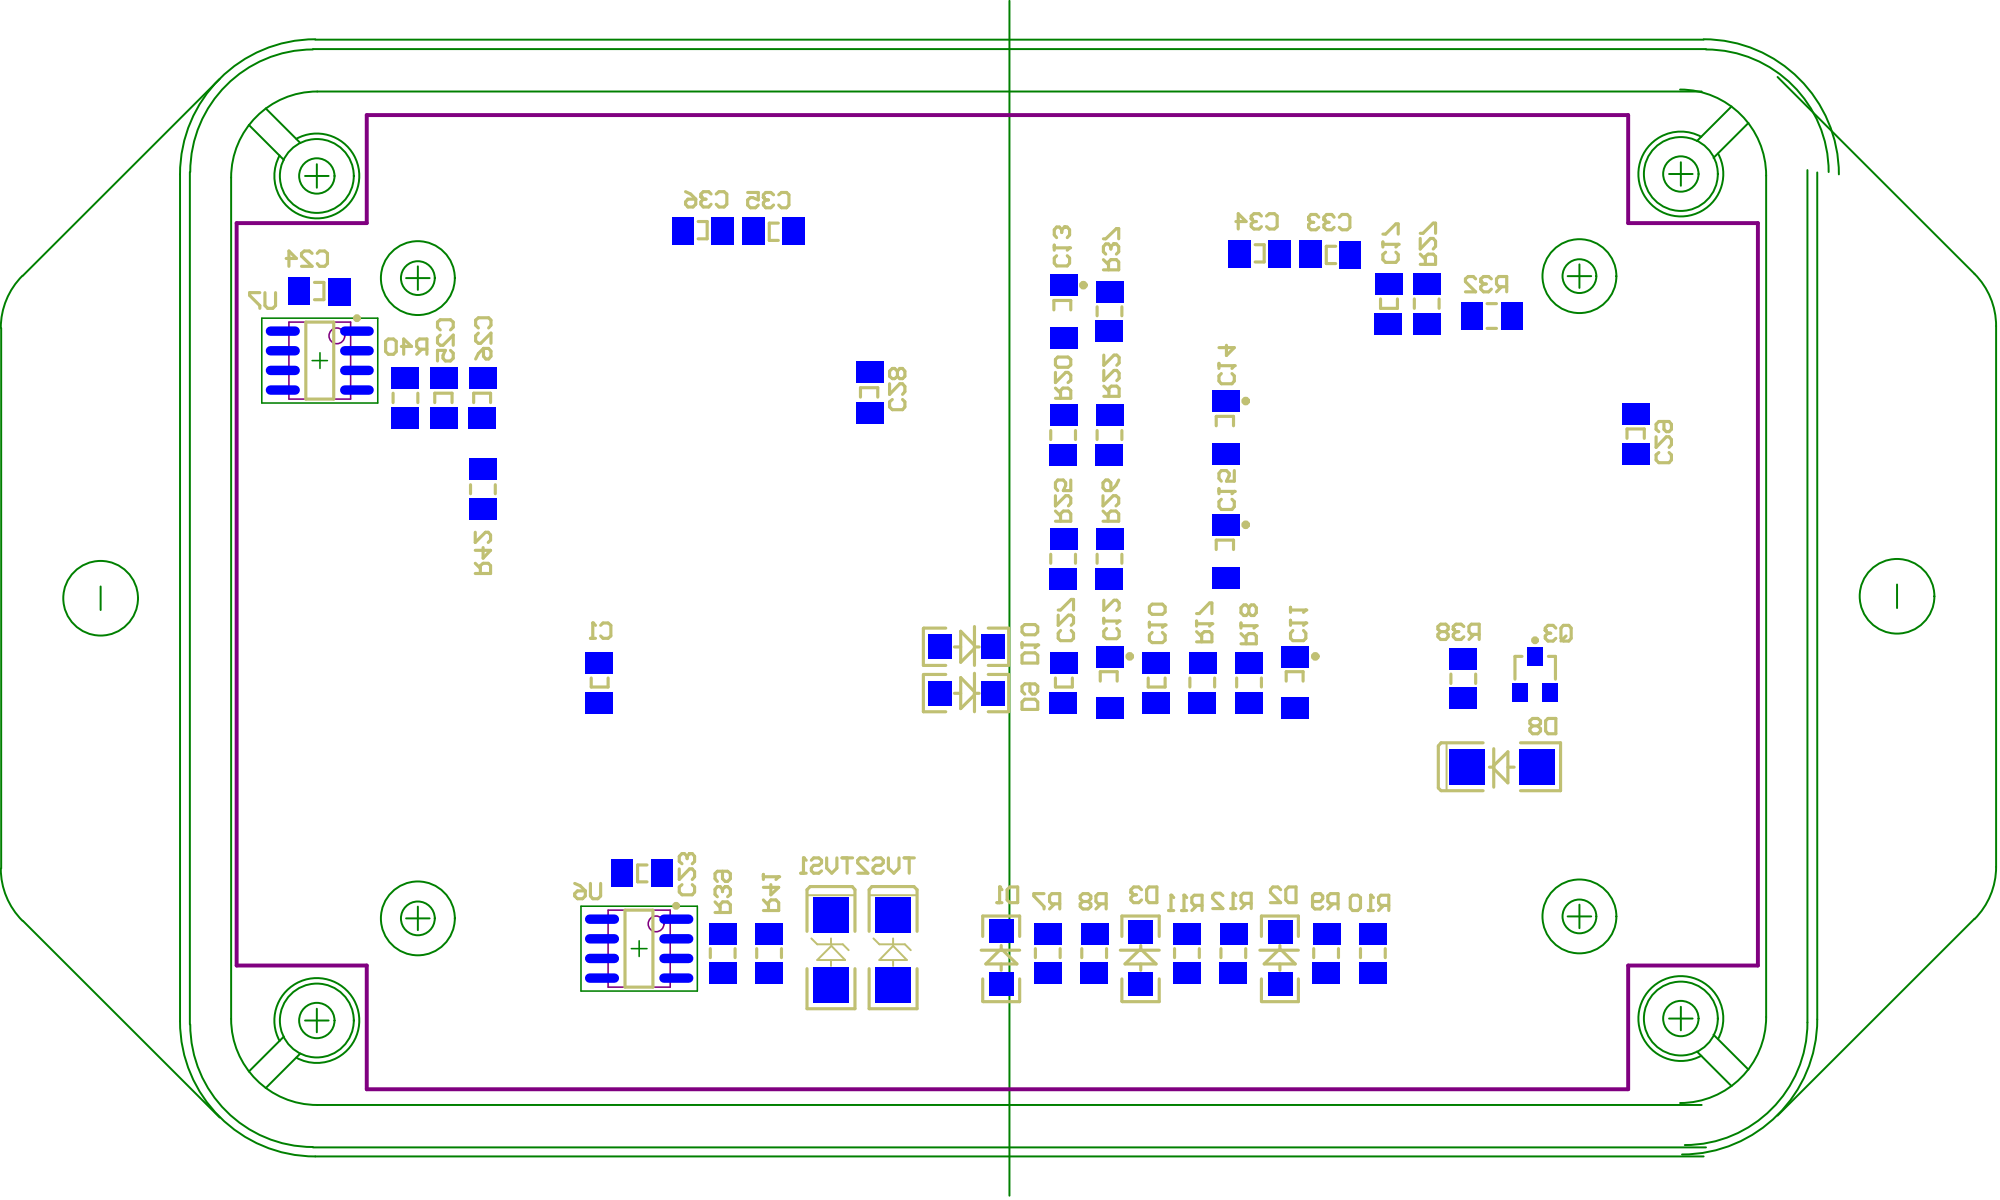
[picture p51: page 10]
