Ferivas/RADIOBRIDGE/(list of files, drawings)

Other design files:
SCH/PCB_RADIOBRIDGE_2022-01-21.pcb
