Ferivas/RADIOBRIDGE/BASCOM/DRVLED/SME/DRV32X192_FINarchivos.bas

'* * * * * * * * * * * * * * * * * * * * * * * * * * * * * * * * * * * * * * * *
'*  SD_Archivos.bas                                                        *
'* * * * * * * * * * * * * * * * * * * * * * * * * * * * * * * * * * * * * * * *
'*                                                                             *
'*  Variables, Subrutinas y Funciones                                          *
'* WATCHING SOLUCIONES TECNOLOGICAS                                            *
'* 25.06.2015                                                                  *
'* * * * * * * * * * * * * * * * * * * * * * * * * * * * * * * * * * * * * * * *

$nocompile


'*******************************************************************************
'Declaracion de subrutinas
'*******************************************************************************
Declare Sub Inivar()
Declare Sub Espera(byval Tespera As Word)                   'Subrutina para delay en multiplos de 10 ms
Declare Sub Procser()
Declare Sub Diskinsertion()
Declare Sub Disp_buffer(byval Ptrb As Word , Byval Cntr_seg As Word)
Declare Sub Leerdata()
Declare Sub Leersta()
Declare Sub Wrbufdata()
Declare Sub Rdbufdata()
Declare Sub Gendig(byval Valdig As Byte , Byval Posdig As Byte)
Declare Sub Gendp(byval Posdp As Byte)
Declare Sub Rdlinesd()
' Variables para leer DS18B20
Declare Sub Temperatura()
Declare Sub Leer_ds18b20()

Declare Sub Gendigt(byval Valdig As Byte , Byval Posdig As Byte)
Declare Sub Gensp(byval Posdp As Byte)
Declare Sub Gengrado(byval Posdp As Byte)



'*******************************************************************************
'Declaracion de variables
'*******************************************************************************
'Generales
Dim Tmpb As Byte
Dim Tmpb2 As Byte
Dim Tmpbyte As Byte
Dim Tmpl As Long
Dim Cntr2 As Byte
Dim Tmpstr As String * 2

Dim Tmpl2 As Long , Tmpl3 As Long
Dim Tmplsd As Long
Dim Lonfile As Long
Dim Temp As Byte
Dim K As Byte
Dim K1 As Byte
Dim Kt As Byte
Dim Tmp3 As Byte
Dim Dlsb As Byte , Dmsb As Byte
Dim Tmpw As Word
Dim Tmpw2 As Word
Dim Tmpw3 As Word
Dim Tmpw4 As Word
Dim Tt As Word
Dim Cc As Byte
Dim Nn As Word
Dim M As Byte
Dim T As Long
Dim Statusant As Byte
Dim Ptrdig As Word
Dim Ptrpos As Word
Dim Kw As Word
Dim Ptrtx As Word
Dim Tmpwf As Word
Dim Tmps As Single

Dim Tmpptr As Word
Dim Cntrframe As Byte
Dim Newframe As Bit
Dim Tmpptrtx As Word

Dim Tbl_hora(6) As Byte
Dim Tbl_horaant(6) As Byte


Dim Horamin As Long
Dim Horamineep As Eram Long

Dim Iniespera As Bit

'Temperatura
Dim Crc As Byte
Dim T1 As Single , Bint As Integer , Tr As Byte , Ti As Byte
Dim Bt(9) As Byte
Dim Tempestr4 As String * 4 , Signo As String * 1 , Tempe As Byte
Dim Tbltemp(6) As Byte

Dim Cntrtemp As Byte , Stemp As Bit
Dim Cntrerrortemp As Byte
Dim Errortemp As Bit
Dim Cntrsegtemp As Byte , Initemp As Bit
'Variables SD
Dim Sdinitok As Bit
Dim Dirstr As String * 16
'Matriz
Dim Dato8 As Byte
Dim Buffram(longbuf) As Byte
Dim Sample As Byte

'TIMER0
Dim Cntr_col As Byte
Dim Kk As Byte
Dim Tmpwtx As Word
'Dim Tmpw3 As Word
Dim T0c As Byte
Dim Num_ventana As Byte
Dim Estadoled As Long
Dim Estado_led As Byte
Dim Iluminar As Bit
Dim T0frame As Byte


'TIMER2
Dim T2c As Byte
Dim Tmpsec As Long
Dim Newseg As Bit
Dim Cntrmin As Byte
Dim Hora As String * 10
Dim Fecha As String * 10

Dim Cmdtmp As String * 6
Dim Atsnd As String * 255
Dim Cmderr As Byte
Dim Tmpstr2 As String * 2
Dim Tmpstr8 As String * 16
Dim Tmpstr52 As String * 52
Dim Debugsd As Byte

Dim Cntrdata As Word                                        'Variable para almacenar numero de líneas de un archivo
Dim Cntrdataeep As Eram Word
Dim Numfile As Word                                         ' Almacena numero de archivo
Dim Numfileeep As Eram Word
Dim Numlineas As Word                                       'Almacena numero máximo de lineas
Dim Numlineaseep As Eram Word
Dim Filename As String * 16
Dim Filenameeep As Eram String * 16
Dim Cfgok As Byte
Dim Cfgokeep As Eram Byte

Dim Status As Byte                                          'Variable para almacenar el estado
Dim Aniflag As Bit                                          'Bandera para configurar animaciones
Dim Horaflag As Bit
Dim Tempflag As Bit
Dim Leertemp As Bit

'Dim Statuseep As Eram Byte

'Variables SERIAL0
Dim Ser_ini As Bit , Sernew As Bit
Dim Numpar As Byte
Dim Cmdsplit(34) As String * 20
Dim Serdata As String * 255 , Serrx As Byte , Serproc As String * 255

'Variables SERIAL1
Dim Gps_ini As Bit , Gpsnew As Bit
Dim Gpsdata As String * 200 , Serrx1 As Byte , Gpsproc As String * 200

Dim Ptrbufdata As Word
Dim Cntrbufdata As Byte

Dim Buf1(9985) As Byte
'Dim Buf2(11) As Byte

'Dim Bufdata(6913) As Byte




'*******************************************************************************
'* END public part                                                             *
'*******************************************************************************


Goto Loaded_arch

'*******************************************************************************
' INTERRUPCIONES
'*******************************************************************************

'*******************************************************************************
' Subrutina interrupcion de puerto serial 1
'*******************************************************************************
At_ser1:
   Serrx = Udr0
   Disable Timer0
'   Toggle Led1

   Select Case Serrx
      Case "$":
         Ser_ini = 1
         Serdata = ""

      Case 13:
         If Ser_ini = 1 Then
            Ser_ini = 0
            Serdata = Serdata + Chr(0)
            Serproc = Serdata
            Sernew = 1
            Enable Timer0
         End If

      Case Is > 31
         If Ser_ini = 1 Then
            Serdata = Serdata + Chr(serrx)
         End If

   End Select

Return

'*******************************************************************************
' Subrutina interrupcion de puerto serial 2
'*******************************************************************************
At_ser2:
   Serrx1 = Udr1
   'Disable Timer0
'   Toggle Led2
   Select Case Serrx1
      Case "$":
         Gps_ini = 1
         Gpsdata = ""

      Case 13:
         If Gps_ini = 1 Then
            Gps_ini = 0
            Gpsdata = Gpsdata + Chr(0)
            Gpsproc = Gpsdata
            Gpsdata = ""
            If Mid(gpsproc , 1 , 5) = "GPRMC" Then
               Gpsnew = 1
               Disable Urxc1
            End If
    '        Enable Timer0
         End If

      Case Is > 31
         If Gps_ini = 1 Then
            Gpsdata = Gpsdata + Chr(serrx1)
         End If

    End Select

Return

'*******************************************************************************



'*******************************************************************************
' TIMER0
'*******************************************************************************
Tim0_isr:
   Timer0 = &HB5                                            '240hz  CON 18432000
   'Reset Oena2
   Select Case Cntr_col
      Case 0:
         Reset Sela
         Reset Selb
      Case 1:
         Set Sela
         Reset Selb
      Case 2:
         Reset Sela
         Set Selb
      Case 3:
         Set Sela
         Set Selb
   End Select
   Cntr_col = Cntr_col + 1

      'Set Pinbug

   Reset Oena
   Reset Oena2
   For Kk = 1 To Numtxser_2
      Tmpwtx = Lookup(kk , Tbl_txser)
      Tmpwtx = Tmpwtx + Cntr_col
      Dato8 = Buffram(tmpwtx)
      Dato8 = Dato8 Xor &HFF
      Shiftout Datos , Sck , Dato8 , 1
   Next
   Set Lena
   Reset Lena
   'Set Oena

   'Reset Oena2
   For Kk = 1 To Numtxser_2
      Tmpwtx = Lookup(kk , Tbl_tx2)
      Tmpwtx = Tmpwtx + Cntr_col
      Dato8 = Buffram(tmpwtx)
      Dato8 = Dato8 Xor &HFF
      Shiftout Datos , Sck , Dato8 , 1
   Next
   Set Lena2
   Reset Lena2
   Set Oena
   Set Oena2
   'Reset Pinbug
   Cntr_col = Cntr_col Mod 4

'   Incr T0frame
'   T0frame = T0frame Mod 120
'   If T0frame = 0 Then
'      Set Newframe

'   End If

'   Reset Pinbug
Return

'*******************************************************************************
'TIMER 2


Sectic:
   Set Newseg
'   Incr Num_ventana
'   Num_ventana = Num_ventana Mod 16
'   Estadoled = Lookup(estado_led , Tabla_estado)
'   Iluminar = Estadoled.num_ventana
'   Toggle Iluminar
'   Ledout = Iluminar
'   'Staout = Iluminar
   If Sdinitok = 1 Then
      Toggle Iluminar
      Ledout = Iluminar
   Else
      Reset Ledout
   endif

   Incr Cntrsegtemp
   Cntrsegtemp = Cntrsegtemp Mod 3
   If Cntrsegtemp = 0 Then Set Initemp

Return

'*******************************************************************************
' SUBRUTINAS
'*******************************************************************************
Sub Inivar()
  ' Set Buzzer
  Reset Pwrsd
Print #1 , "************ DRIVER matriz LEDs P10(1R)-V701C ************"
Print #1 , Version(1)
Print #1 , Version(3)
Print #1 , "Nummatriz=" ; Nummatriz
Print #1 , "Longbuf=" ; Longbuf
Print #1 , "Longdat=" ; Longdat
Print #1 , "Longdat_mas_uno=" ; Longdat_mas_uno
Print #1 , "Longbuf_mas_uno=" ; Longbuf_mas_uno
Print #1 , "Numtxser=" ; Numtxser

For Tmpw4 = 1 To Longbuf
   Buffram(tmpw4) = 0
Next

Buffram(576) = &B01111110
Buffram(193) = &B01111110
Buffram(177) = &B01111110
Buffram(592) = &B01111110



Estado_led = 2

   'Horamin = Horamineep
   'Print #1 , "Last act CLK " ; Date(horamin) ; "," ; Time(horamin)
   'Tmplntp = Syssec(horamin)
   'Tmpstr8 = Time(horamin)
   'Time$ = Tmpstr8
   'Print #1 , "Ts:" ; Tmpstr8 ; " T:" ; Time$
   'Tmpstr8 = Date(horamin)
   'Date$ = Tmpstr8
   Print #1 , "Ds:" ; Tmpstr8 ; " D:" ; Date$
   Print #1 , "H:" ; Time$ ; " D:" ; Date$
   Tmpsec = Syssec()
   Statusant = 99
   'Status = Statuseep
   'Print #1 , "STATUS=" ; Estatus
   For Tmpb = 1 To 6
      Tbl_horaant(tmpb) = 99
   Next
   Tempestr4 = "0.0"
   Signo = "-"

End Sub


'*****************************************************************************
' Subrutina para leer temperatura del DS18B20
'*****************************************************************************
Sub Temperatura()
   Call Leer_ds18b20()
   If Err = 1 Then                                          ' No hay sensor
      Print #1 , "T=Err"
      Incr Cntrerrortemp
      If Cntrerrortemp = 5 Then
         Set Errortemp
      End If
   Else
    If Crc = 0 Then                                         ' Se verifica si hay CRC
       Tempestr4 = Fusing(t1 , "#.#")
       Tempe = Val(tempestr4)
       Print #1 , "T=" ; Tempestr4
       Errortemp = 0
       Cntrerrortemp = 0
    Else
      Print #1 , "T=**"
    End If
   End If

End Sub

'*****************************************************************************
' Subrutina para leer temperatura del DS18B20
'*****************************************************************************
Sub Leer_ds18b20()
1wreset
1wwrite &HCC
1wwrite &H44
Waitms 800
'Call Rdramds18b20()

 1wreset                                                    ' reset the bus
 1wwrite &HCC
 1wwrite &HBE                                               ' read 9 data bytest
 For Tr = 1 To 9
    Bt(tr) = 1wread()
 Next                                                       ' read bytes in array
 1wreset

'Call Crcit                                                    'Check CRC

 Crc = 0
 For Ti = 1 To 9
 Tr = Crc Xor Bt(ti)
 Crc = Lookup(tr , Crc8)
 Next

If Crc = 0 Then                                             ' if is OK, calculate for
  Bint = Makeint(bt(1) , Bt(2))
  If Bt(2).3 = 0 Then                                       'Temp postiva
   T1 = Bint / 16
   Signo = "+"
  Else
   Bint = Not Bint                                          ' Comprobar esta subrutina
   Bint = Bint + 1
   T1 = Bint / 16
   Signo = "-"
  End If
End If

End Sub
'*****************************************************************************

'***********************************************************************************************
'Subrutina para leer datos de memoria SD
'***********************************************************************************************
Sub Leerdata()
   'Set Pinbug

'   Local Sample As Byte
      Get #3 , Sample , Tmplsd
      Line Input #3 , Atsnd
      Tmplsd = Loc(#3)
      Tmpstr8 = Mid(atsnd , 2 , 2)
      Numpar = Val(tmpstr8)
      If Numpar > 0 Then
         Tmpw3 = Lookup(numpar , Tbl_ptrbuf)
         For K = 1 To 32
            Kt = Lookup(k , Tbl_mid)
            Tmpstr8 = Mid(atsnd , Kt , 2)
            Tmpbyte = Hexval(tmpstr8)
            Incr Tmpw3
            Buffram(tmpw3) = Tmpbyte
         Next
      Else
         'Set Iniespera
         If Lonfile =< Tmplsd Then
            Tmplsd = 1
            Get #3 , Sample , 1
         End If
      End If

    'Reset Pinbug
End Sub

'***********************************************************************************************
'Subrutina para leer estado asignado por PLC
'***********************************************************************************************
Sub Leersta()
   Status = 0
   Status.0 = Sta0
   Status.1 = Sta1
   Status.2 = Sta2
   Status.3 = Sta3
   'Toggle Status.0
   'Toggle Status.1
   'Toggle Status.2
   'Toggle Status.3


   If Status <> Statusant Then
      Print #1 , "STATUS=" ; Status
      'Tmpb = Status + 1
      'Estado_led = Status
      Statusant = Status
      Select Case Status
         Case 0:
            Filename = "Ani1.txt"
            Set Aniflag
            Reset Tempflag
            Reset Horaflag

         Case 1:
            Filename = "Ani2.txt"
            Set Aniflag
            Reset Tempflag
            Reset Horaflag

         Case 2:
            Filename = "Ani3.txt"
            Set Aniflag
            Reset Tempflag
            Reset Horaflag

         Case 3:
            Filename = "Ani4.txt"
            Set Aniflag
            Reset Tempflag
            Reset Horaflag

         Case 4:                                            'Muestra Temperatura
            Print #1 , "MUESTRA TEMPERATURA"
           Reset Aniflag
           Set Tempflag
           Reset Horaflag

         Case 5:
            Filename = "Ani5.txt"
            Set Aniflag
            Reset Tempflag
            Reset Horaflag

         Case 6:                                            'Muestra la hora
            Print #1 , "MUESTRA HORA"
            Reset Aniflag
            Reset Tempflag
            Set Horaflag

         Case 7:                                            'Apaga todo
            Print #1 , "APAGA TODO"
            Reset Aniflag
            Reset Tempflag
            Reset Horaflag

         Case 8:
            Filename = "Ani6.txt"
            Set Aniflag
            Reset Tempflag
            Reset Horaflag

         Case 9:
            Filename = "Ani7.txt"
            Set Aniflag
            Reset Tempflag
            Reset Horaflag

         Case 10:
            Filename = "Ani8.txt"
            Set Aniflag
            Reset Tempflag
            Reset Horaflag

         Case 11:                                           'Apaga todo
            Print #1 , "APAGA TODO"
            Reset Aniflag
            Reset Tempflag
            Reset Horaflag

         Case 12:
            Filename = "Ani9.txt"
            Set Aniflag
            Reset Tempflag
            Reset Horaflag

         Case 13:
            Filename = "Ani10.txt"
            Set Aniflag
            Reset Tempflag
            Reset Horaflag

         Case 14:
            Filename = "Ani11.txt"
            Set Aniflag
            Reset Tempflag
            Reset Horaflag

         Case 15:                                           'Apaga todo
            Print #1 , "APAGA TODO"
            Reset Aniflag
            Reset Tempflag
            Reset Horaflag

      End Select

      Close #3

      If Aniflag = 0 And Tempflag = 0 And Horaflag = 0 Then
         Disable Timer0
         Enable Urxc1
         Set Leertemp
         Reset Oena
         Reset Oena2

      Else
         Enable Timer0
         Disable Urxc1
         Reset Leertemp
      End If

      If Aniflag = 1 Then
         Disable Urxc1
         Open Filename For Binary As #3
         Lonfile = Lof(#3)
         Print #1 , "L>" ; Lonfile
         Print #1 , "L>" ; Filename

         T = Lof(#3)
         Print #1 , "LOF:" ; T
         Tmplsd = 1
         Tmpptr = 0

         'Estado_led = Status + 1

         'Set Pinbug
         Print #1 , "INIwr"
         'Call Wrbufdata()
         'Reset Pinbug
         Print #1 , "FINwr"

      End If

      For Kw = 1 To 768
         Buffram(kw) = 0
      Next


      For Kw = 1 To 7681
         Buf1(kw) = 0
      Next

      For Tmpb = 1 To 6                                     ' Para que el reloj siempre empiece con datos
         Tbl_horaant(tmpb) = 99
      Next

      Tmpptrtx = 0

   End If



End Sub

'SUBRUTINA PARA ESCRIBIR A BUFDATA
Sub Wrbufdata()
   Close #3
   Open Filename For Binary As #3
   Lonfile = Lof(#3)
   'Print #1 , "Lw>" ; Lonfile
   'Print #1 , "Lw>" ; Filename

   T = Lof(#3)
   'Print #1 , "LOFw:" ; T
   Tmplsd = 1
   Tmpw3 = 0
   Tmpb = 0

   Do
      Get #3 , Sample , Tmplsd
      Line Input #3 , Atsnd
      'Print #1 , "ATSND=" ; Atsnd
      Tmplsd = Loc(#3)
      Tmpstr8 = Mid(atsnd , 2 , 2)
      Numpar = Val(tmpstr8)
      If Numpar > 0 Then
         For K = 1 To 32
            Kt = Lookup(k , Tbl_mid)
            Tmpstr8 = Mid(atsnd , Kt , 2)
            Tmpbyte = Hexval(tmpstr8)
            Incr Tmpw3
            'Bufdata(tmpw3) = Tmpbyte
         Next
      Else
         If Lonfile =< Tmplsd Then
            Tmplsd = 1
            Tmpb = 1
            Get #3 , Sample , 1
         End If
      End If
   Loop Until Tmpb = 1 Or Tmpw3 > 6144

End Sub

'SUBRUTINA PARA LEER UNA LINEA DE LA SD
Sub Rdlinesd()
   Get #3 , Sample , Tmplsd
   Line Input #3 , Atsnd
   Tmplsd = Loc(#3)
   If Lonfile =< Tmplsd Then
      Tmplsd = 1
      Tmpb = 1
      Get #3 , Sample , 1
   End If

   Tmpstr8 = Mid(atsnd , 2 , 2)
'   Print #1 , Atsnd

   Numpar = Val(tmpstr8)
   If Numpar > 0 Then
'      If Cntrframe.0 = 0 Then
        ' Set Pinbug
         Kt = 5
         For K = 1 To 32
            'Kt = Lookup(k , Tbl_mid)
            'Kt = Kt + 3
            Tmpstr8 = Mid(atsnd , Kt , 2)
            Kt = Kt + 3
            Tmpbyte = Hexval(tmpstr8)
            Tmpw3 = Tmpptr + K
            Buf1(tmpw3) = Tmpbyte
            'Print #1 , "B1(" ; Tmpw3 ; ")=" ; Hex(tmpbyte)
         Next
         'Reset Pinbug
'      Else
'         For K = 1 To 32
'            Kt = Lookup(k , Tbl_mid)
'            Tmpstr8 = Mid(atsnd , Kt , 2)
'            Tmpbyte = Hexval(tmpstr8)
'            Tmpw3 = Tmpptr + K
'            Buf2(tmpw3) = Tmpbyte
            'Print #1 , "B2(" ; Tmpw3 ; ")=" ; Hex(tmpbyte)
'         Next
'      End If
      Tmpptr = Tmpw3
      Tmpwf = Tmpw3 Mod Longbuf
      If Tmpwf = 0 Then
       'Toggle Pinbug2
       Set Newframe
      End If

      If Tmpptr = 9984 Then
         'Incr Cntrframe
         'Toggle Pinbug2
         'Set Newframe
         Tmpptr = 0
         'Tmpptrtx = 0
      End If


   End If


End Sub


'SUBRUTINA PARA ESCRIBIR A BUFDATA
Sub Rdbufdata()
   Ptrbufdata = Cntrbufdata * 768
   'Print #1 , "INI=" ; Ptrbufdata
   For Tmpw = 1 To 768
      Incr Ptrbufdata
      'Buffram(tmpw) = Bufdata(ptrbufdata)
   Next
  ' Print #1 , "FIN=" ; Ptrbufdata
   Incr Cntrbufdata
   Cntrbufdata = Cntrbufdata Mod 8
   'Set Iniespera
End Sub

'*******************************************************************************
'  Subrutina para pintar digito en posicion predeterminada
'  Los digitos son de 32x24 pixels y se puden posicionar en 6 posiciones
'  Valdig indica el valor del digito (1-9) y posdig la posicion (1-6)
'
Sub Gendig(byval Valdig As Byte , Byval Posdig As Byte)
   Local Kt As Byte
   Ptrdig = Valdig * 96
   Posdig = Posdig - 1
   Ptrpos = Posdig * 96

   For Kt = 1 To 96
      K = Kt - 1
      Tmpw3 = K + Ptrpos
      Tmpw = Lookup(tmpw3 , Tbl_posdig1)
      Tmpw2 = Ptrdig + K
      Tmpb2 = Lookup(tmpw2 , Tbl_char)
      Buffram(tmpw) = Tmpb2
   Next

End Sub


Sub Gendigt(byval Valdig As Byte , Byval Posdig As Byte)
   Local Kt As Byte
   Ptrdig = Valdig * 96
   Posdig = Posdig - 1
   Ptrpos = Posdig * 96

   For Kt = 1 To 96
      K = Kt - 1
      Tmpw3 = K + Ptrpos
      Tmpw = Lookup(tmpw3 , Tbl_post)
      Tmpw2 = Ptrdig + K
      Tmpb2 = Lookup(tmpw2 , Tbl_chart)
      Buffram(tmpw) = Tmpb2
   Next

End Sub

Sub Gendp(byval Posdp As Byte)
   Local Kp As Byte
   Posdp = Posdp - 1
   Ptrpos = Posdp * 32

   For Kp = 1 To 32
      K = Kp - 1
      Tmpw3 = K + Ptrpos
      Tmpw = Lookup(tmpw3 , Tbl_posdp)
      'Tmpw2 = Ptrdig + K
      Tmpb2 = Lookup(k , Tbl_dosp)
      Buffram(tmpw) = Tmpb2
   Next

End Sub

Sub Gengrado(byval Posdp As Byte)
   Local Kp As Byte
   Posdp = Posdp - 1
   Ptrpos = Posdp * 32

   For Kp = 1 To 32
      K = Kp - 1
      Tmpw3 = K + Ptrpos
      Tmpw = Lookup(tmpw3 , Tbl_posgrado)
      'Tmpw2 = Ptrdig + K
      Tmpb2 = Lookup(k , Tbl_grado)
      Buffram(tmpw) = Tmpb2
   Next

End Sub


Sub Gensp(byval Posdp As Byte)
   Local Kp As Byte
   Posdp = Posdp - 1
   Ptrpos = Posdp * 32

   For Kp = 1 To 32
      K = Kp - 1
      Tmpw3 = K + Ptrpos
      Tmpw = Lookup(tmpw3 , Tbl_possp)
      'Tmpw2 = Ptrdig + K
      Tmpb2 = Lookup(k , Tbl_sp)
      Buffram(tmpw) = Tmpb2
   Next

End Sub


'*******************************************************************************
Sub Disp_buffer(byval Ptrb As Word , Byval Cntr_seg As Word)
   Tt = Ptrb - 1
   Tt = Tt Mod 8
   Nn = Ptrb - 1
   For Cc = 1 To 16
      Tmpw2 = Nn / 8
      Tmpw2 = Tmpw2 * 16
      Tmpw2 = Tmpw2 + 17
      Tmpw2 = Tmpw2 - Cc
      M = Cc - 1
      If Cntr_seg.m = 1 Then
         Set Buffram(tmpw2). Tt
      Else
         Reset Buffram(tmpw2). Tt
      End If
   Next

End Sub



'*******************************************************************************
'Subrutina de espera
'*******************************************************************************
Sub Espera(byval Tespera As Word)
'(
   Topdelay = Tespera
   Cntrdelay = 0
   Reset T0delay
   Set Inidelay
   While T0delay = 0
      Reset Watchdog
   Wend
')
End Sub

'*******************************************************************************
'Subrutinas SD
'*******************************************************************************


Sub Diskinsertion()
   Local Errorcode As Byte
   If Debugsd = 1 Then
      Print #1 , "Ini SD"
   End If

   Gbdriveerror = Driveinit()
   If Gbdriveerror = 0 Then
         If Debugsd = 1 Then
           Print #1 , "Ini File System"
         End If

        ' Select partition 1 (or use 0 for drive without Master Boot Record)
        Errorcode = Initfilesystem(1)
        If Errorcode <> 0 Then
            Print #1 , "Error: " ; Errorcode ; " while initializing file system"
            Print #1 , "Errortext can't be saved at SD"
            Reset Sdinitok
        Else
         If Debugsd = 1 Then
            Print #1 , "Filesystem type: " ; Gbfilesystem
            Print #1 , "FAT Start Sector: " ; Glfatfirstsector
            Print #1 , "Root Start Sector: " ; Glrootfirstsector
            Print #1 , "Data First Sector: " ; Gldatafirstsector
            Print #1 , "Max. Cluster Nummber: " ; Glmaxclusternumber
            Print #1 , "Sectors per Cluster: " ; Gbsectorspercluster
            Print #1 , "Root Entries: " ; Gwrootentries
            Print #1 , "Sectors per FAT: " ; Glsectorsperfat
            Print #1 , "Number of FATs: " ; Gbnumberoffats
            Print #1 , "Disk size: " ; Disksize() ; " kB"
         Else
            Print #1 , "SD OK"
         End If
'            Diskinitialized = True
            Set Sdinitok
        End If
   Else
       Print #1 , "Error en Drive Init: " ; Gbdriveerror
       Print #1 , "Errortext can't be saved at SD"
       Reset Sdinitok
   End If
   Print #1 , ""



End Sub



'*******************************************************************************
'Subrutina de procesamiento de datos seriales
'*******************************************************************************
Sub Procser()
   Print #1 , "$" ; Serproc
   Locate 1 , 10
   Tmpstr52 = Mid(serproc , 1 , 6)
   Lcd Chr(3) ; Tmpstr52
   Numpar = Split(serproc , Cmdsplit(1) , ",")
   If Numpar > 0 Then
      For Tmpb = 1 To Numpar
         Print #1 , Tmpb ; ":" ; Cmdsplit(tmpb)
      Next
   End If

   If Len(cmdsplit(1)) = 6 Then
      Cmdtmp = Cmdsplit(1)
      Cmdtmp = Ucase(cmdtmp)
      Cmderr = 255
      Select Case Cmdtmp
         Case "LEEVFW"
            Atsnd = "Version FW: Fecha <"
            Tmpstr52 = Version(1)
            Atsnd = Atsnd + Tmpstr52 + ">, Archivo <"
            Tmpstr52 = Version(3)
            Atsnd = Atsnd + Tmpstr52 + ">"
            Cmderr = 0

         Case "LSTFIL"
            Cmderr = 0
            Call Diskinsertion()
            If Sdinitok = 1 Then
               Atsnd = "Archivos SD en DIR <" + Tmpstr52 + ">"
               'Print #1 , "Lista Archivos en DIR <" ; Tmpstr52 ; ">"
               Chdir "\"                                    ' Para ir al directorio raiz
               If Len(tmpstr52) > 0 Then
                  Chdir Tmpstr52
               End If
               Dirstr = Dir( "*.*")
               If Len(dirstr) > 0 Then
                  While Len(dirstr) > 0                     ' if there was a file found
                     Print #1 , Dirstr ; "," ; "LOF=" ; Filelen(dirstr) ; "," ; Filedate(dirstr) ; "," ; Filetime(dirstr)
                     Reset Watchdog
                     Dirstr = Dir()
                  Wend
               End If
            Else
               Cmderr = 9
            End If

            Case "LEELOG"
               If Numpar = 2 Then
                  Cmderr = 0
                  Print #1 , "LOG a " ; Date$ ; "," ; Time$
                  Disable Urxc
                  Call Diskinsertion()
                  If Sdinitok = 1 Then
                     Atsnd = "Lectura Log"
                     'Tmpstr8 = "LogSD.txt"
                     Tmpstr8 = Cmdsplit(2)
                     Open Tmpstr8 For Binary As #3
                     Tmpl2 = Lof(#3)
                     Print #1 , "LOF=" ; Tmpl2
                     Atsnd = "Datos SD"
                     For Tmpl3 = 1 To Tmpl2
                           Get #3 , Tmpb
                           Print #1 , Chr(tmpb);
                           'Call Espera(30)
                           Reset Watchdog
                     Next
                     Print #1,
                     Close #3
                     Enable Urxc
                  Else
                     Cmderr = 9
                  End If
               Else
                  Cmderr = 4
               End If

            Case "DELLOG"

               If Numpar = 2 Then
                  Cmderr = 0
                  Atsnd = "Borra Archivo Log"
                  'Tmpstr8 = "LogSD.txt"
                  Tmpstr8 = Cmdsplit(2)
                  Open Tmpstr8 For Binary As #3
                  Reset Watchdog
                  Tmpl2 = Lof(#3)
                  Close #3
                  Kill Tmpstr8
                  Flush #3
               Else
                  Cmderr = 4
                End If


            Case "SETBUG"
               Cmderr = 0
               Atsnd = "Se activa debug en SD"
               Debugsd = 1

            Case "RSTBUG"
               Cmderr = 0
               Atsnd = "Se desactiva debug en SD"
               Debugsd = 0

            Case "SETCLK"
               If Numpar = 2 Then
                  Cmderr = 0
                  Tmpstr8 = Mid(cmdsplit(2) , 7 , 2) + "/" + Mid(cmdsplit(2) , 9 , 2) + "/" + Mid(cmdsplit(2) , 11 , 2)
                  Time$ = Tmpstr8
                  Tmpstr8 = Mid(cmdsplit(2) , 1 , 2) + ":" + Mid(cmdsplit(2) , 3 , 2) + ":" + Mid(cmdsplit(2) , 5 , 2)
                  Date$ = Tmpstr8
                  'Print #1 , "D>" ; Date$
                  Tmpstr8 = ""
                  Atsnd = "WATCHING INFORMA. Se configuro reloj en " + Date$ + " a " + Time$

               Else
                  Cmderr = 4
               End If

            Case "LEECLK"
               Cmderr = 0
               Tmpstr8 = Time$
               Atsnd = "Reloj sistema actual " + Tmpstr8
               Tmpstr8 = Date$
               Atsnd = Atsnd + " de " + Tmpstr8

            Case "INITSD"
               Cmderr = 0
               Atsnd = "Inicializacion de la SD"
               Call Diskinsertion()

            Case "NUMLIN"
               If Numpar = 2 Then
                  If Val(cmdsplit(2)) < 1000 Then
                     Cmderr = 0
                     Numlineas = Val(cmdsplit(2))
                     Numlineaseep = Numlineas
                     Atsnd = "Se configuro numero maximo de lineas a " + Str(numlineas)

                  Else
                     Cmderr = 5

                  End If
               Else
                  Cmderr = 4
               End If

            Case "LEELIN"
               Cmderr = 0
               Atsnd = "Numero maximo de lineas=" + Str(numlineas)

            Case "NUMFIL"
               If Numpar = 2 Then
                  If Val(cmdsplit(2)) > 0 Then
                     Cmderr = 0
                     Numfile = Val(cmdsplit(2))
                     Numfileeep = Numfile
                     Atsnd = "Se configuro numero de archivo a " + Str(numfile)

                  Else
                     Cmderr = 5

                  End If
               Else
                  Cmderr = 4
               End If

            Case "LEEFIL"
               Cmderr = 0
               Atsnd = "Numero de archivo =" + Str(numfile)


            Case "RSTVAR"
               Cmderr = 0
               Numlineas = 1000
               Numlineaseep = Numlineas
               Numfile = 1
               Numfileeep = Numfile
               Atsnd = "Inicio variables: Numlineas=" + Str(numlineas) + ", Numfile=" + Str(numfile)
               Cntrdata = 0
               Cntrdataeep = Cntrdata
               Filename = "SD1.txt"
               Filenameeep = Filename
               Cfgok = 1
               Cfgokeep = Cfgok


            Case "SETBUF"
               Cmderr = 0
               Tmpw = Val(cmdsplit(2))
               If Tmpw < Longbuf_mas_uno Then
                  Cmderr = 0
                  Tmpb = Hexval(cmdsplit(3))
                  Buffram(tmpw) = Tmpb
                  Atsnd = "Buffram(" + Str(tmpw) + ") = &H " + Hex(tmpb)
               Else
                  Cmderr = 5
               End If

            Case "SETCER"
               Cmderr = 0
               Atsnd = "Encerar buffer"
               For Tmpw4 = 1 To Longbuf
                  'Incr Tmpw3
                  'Call Disp_buffer(tmpw4 , Tmpw3)
                  Buffram(tmpw4) = 0
               Next

            Case "SETLED"
               Cmderr = 0
               Tmpb = Val(cmdsplit(2))
               Estado_led = Tmpb
               Atsnd = "Se configuro estado LED " + Str(tmpb)

            Case "SETDIG"
               If Numpar = 3 Then
                  Cmderr = 0
                  Tmpb = Val(cmdsplit(2))
                  Tmpb2 = Val(cmdsplit(3))
                  Atsnd = "Test Digito " + Str(tmpb)
                  Call Gendig(tmpb , Tmpb2)
               Else
                  Cmderr = 5
               End If

            Case "SETDOP"
               Cmderr = 0
               Tmpb = Val(cmdsplit(2))
               Atsnd = "Test DOS PUNTOS EN POS  " + Str(tmpb)
               Call Gendp(tmpb)

            Case "ENAGPS"
               Cmderr = 0
               Atsnd = "Habilita Ints. Serial 2 GPS"
               Enable Urxc1

            Case "DISGPS"
               Cmderr = 0
               Atsnd = "Deshabilita Ints. Serial 2 GPS"
               Disable Urxc1

            Case "SETTEM"
               If Numpar = 2 Then
                  Cmderr = 0
                  Tmps = Val(cmdsplit(2))
                  If Tmps > 0 Then
                     Signo = "+"
                  Else
                     Signo = "-"
                  End If
                  Tempestr4 = Fusing(tmps , "##.#")
                  Atsnd = "Se configura valor Temp=" + Tempestr4

               Else
                  Cmderr = 5
               End If


            Case Else
               Cmderr = 1



      End Select

   Else
        Cmderr = 2
   End If

   If Cmderr > 0 Then
      Atsnd = Lookupstr(cmderr , Tbl_err)
   End If
   Print #1 , Atsnd

End Sub

'*******************************************************************************
'TABLA DE DATOS
'*******************************************************************************
Tbl_ind:
Data 0                                                      '
Data 4                                                      '1
Data 8                                                      '2
Data 12                                                     '3
Data 16                                                     '4
Data 20                                                     '5
Data 24                                                     '6
Data 28                                                     '7
Data 32
Data 36
Data 40
Data 44
Data 48
Data 52                                                     '13
Data 56                                                     '14
Data 60                                                     '15
Data 64                                                     '16


'*******************************************************************************
'TABLA DE DATOS
'*******************************************************************************
Tabla_estado:
Data &B00000000000000000000000000000000&                    'Estado 0
Data &B00000000000000000000000000000001&                    'Estado 1
Data &B00000000000000000000000000000101&                    'Estado 2
Data &B00000000000000000000000000010101&                    'Estado 3
Data &B00000000000000000000000001010101&                    'Estado 4
Data &B00000000000000000000000101010101&                    'Estado 5
Data &B00000000000000000000010101010101&                    'Estado 6
Data &B00000000000000000001010101010101&                    'Estado 7
Data &B00000000000000000101010101010101&                    'Estado 8
Data &B00000000000000010101010101010101&                    'Estado 9
Data &B00000000000001110111011101110111&                    'Estado 10

Tbl_err:
Data "OK"                                                   '0
Data "Comando no reconocido"                                '1
Data "Longitud comando no valida"                           '2
Data "Numero de usuario no valido"                          '3
Data "Numero de parametros invalido"                        '4
Data "Error longitud parametro 1"                           '5
Data "Error longitud parametro 2"                           '6
Data "Parametro no valido"                                  '7
Data "ERROR8"                                               '8
Data "ERROR SD. Intente de nuevo"                           '9

'******************************************************************************
' Tabla CRC Temperatura
Crc8:
Data 0 , 94 , 188 , 226 , 97 , 63 , 221 , 131 , 194 , 156
Data 126 , 32 , 163 , 253 , 31 , 65 , 157 , 195 , 33 , 127
Data 252 , 162 , 64 , 30 , 95 , 1 , 227 , 189 , 62 , 96
Data 130 , 220 , 35 , 125 , 159 , 193 , 66 , 28 , 254 , 160
Data 225 , 191 , 93 , 3 , 128 , 222 , 60 , 98 , 190 , 224
Data 2 , 92 , 223 , 129 , 99 , 61 , 124 , 34 , 192 , 158
Data 29 , 67 , 161 , 255 , 70 , 24 , 250 , 164 , 39 , 121
Data 155 , 197 , 132 , 218 , 56 , 102 , 229 , 187 , 89 , 7
Data 219 , 133 , 103 , 57 , 186 , 228 , 6 , 88 , 25 , 71
Data 165 , 251 , 120 , 38 , 196 , 154 , 101 , 59 , 217 , 135
Data 4 , 90 , 184 , 230 , 167 , 249 , 27 , 69 , 198 , 152
Data 122 , 36 , 248 , 166 , 68 , 26 , 153 , 199 , 37 , 123
Data 58 , 100 , 134 , 216 , 91 , 5 , 231 , 185 , 140 , 210
Data 48 , 110 , 237 , 179 , 81 , 15 , 78 , 16 , 242 , 172
Data 47 , 113 , 147 , 205 , 17 , 79 , 173 , 243 , 112 , 46
Data 204 , 146 , 211 , 141 , 111 , 49 , 178 , 236 , 14 , 80
Data 175 , 241 , 19 , 77 , 206 , 144 , 114 , 44 , 109 , 51
Data 209 , 143 , 12 , 82 , 176 , 238 , 50 , 108 , 142 , 208
Data 83 , 13 , 239 , 177 , 240 , 174 , 76 , 18 , 145 , 207
Data 45 , 115 , 202 , 148 , 118 , 40 , 171 , 245 , 23 , 73
Data 8 , 86 , 180 , 234 , 105 , 55 , 213 , 139 , 87 , 9
Data 235 , 181 , 54 , 104 , 138 , 212 , 149 , 203 , 41 , 119
Data 244 , 170 , 72 , 22 , 233 , 183 , 85 , 11 , 136 , 214
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
Data &B00000000,                                            '
Data &B00000000,                                            '
Data &B00000000,                                            '
Data &B00000000,                                            '
Data &B00000000,                                            '
Data &B00000000,                                            '
Data &B00000000,                                            '
Data &B00000000,                                            '
Data &B00000000,                                            '
Data &B00000000,                                            '

Tbl_posgrado:
Data 481%
Data 482%
Data 483%
Data 484%
Data 485%
Data 486%
Data 487%
Data 488%
Data 489%
Data 490%
Data 491%
Data 492%
Data 493%
Data 494%
Data 495%
Data 496%
Data 97%
Data 98%
Data 99%
Data 100%
Data 101%
Data 102%
Data 103%
Data 104%
Data 105%
Data 106%
Data 107%
Data 108%
Data 109%
Data 110%
Data 111%
Data 112%



Loaded_arch:
