Ferivas/RADIOBRIDGE/(commit log)

2022-01-26 Esquemáticos
    [BOM_RADIOBRIDGE_2022-01-24.csv, PCB_RADIOBRIDGE_2022-01-21.pcb, PickAndPlace_PCB_RADIOBRIDGE_2022-01-22.pcbdoc_2022-01-24.csv]
2022-03-12 Se añade programa Modbus para manejar 56 registros
    También se añade documentación de bugs de HW
    [RTU_BRIDGE_56.bas, RTU_BRIDGE_SIM_ARCHIVOS.bas, RadioBridge_M128.bas, RadioBridge_M128_archivos.bas]
2022-10-24 SE corrige activacion del driver de audio
    El Mainboard no enviaba por el puerto serial 2 el comando de activación para el Driver de Audio
    [RadioBridge_M128.bas]
2023-11-07 Test RTU
    [BOM_PCB_MDBGPS_2023-09-29.csv, PickAndPlace_PCB_MDBGPS_2023-09-29.csv]
2024-05-10 DRIVER Led para tarjeta JLCPCB
    [BOM_DRVLEDSAT_2024-02-23.csv, PickAndPlace_PCB_DRVLEDSAT_2024-02-23.csv]
2024-05-21 Depurando el Master
2024-05-29 Funciones para implementar volumen
2024-06-11 Se depura lectura de canales ADC del PCF8591 del amplificador de Federal Signal
2024-06-11 Subrutinas para consultar valores del conversor ADC del amplificador de Audio desde el RadioBridge
2024-07-02 Depuración consulta de registros ADC I2C
    [BOM_DRVAUDIOSAT_2024-05-31.csv, PickAndPlace_PCB_DRVAUDIOSAT_2024-05-31.csv]
2024-07-03 Test de estaciones vía Modbus
2024-07-27 Se añade tx datos a RPI de la trama del esclavo
2024-08-09 Tx de mensajes pregrabados
2024-08-14 Envío de mensajes pregrabados
2026-07-06 DRVAUDIOMSG, Bug SAT MASTER, RadiobridgeEntrada
    [DRV32X192_FINarchivos.bas, DRV32x192_FIN_DEBUG.bas, DRVAUDIOMSG.bas, DRVAUDIOMSG_archivos.bas, MASTER_archivos.bas, MASTER_main.bas, RadioBridge_VOL_archivos.bas, RadioBridge_VOL_entrada.bas]
